salfordracing/SR-FS-17/Assembly/FInal Assembly (Don't Touch)/Assembly/Suspension/fsae-rear-hub/FSAE REAR HUB.png

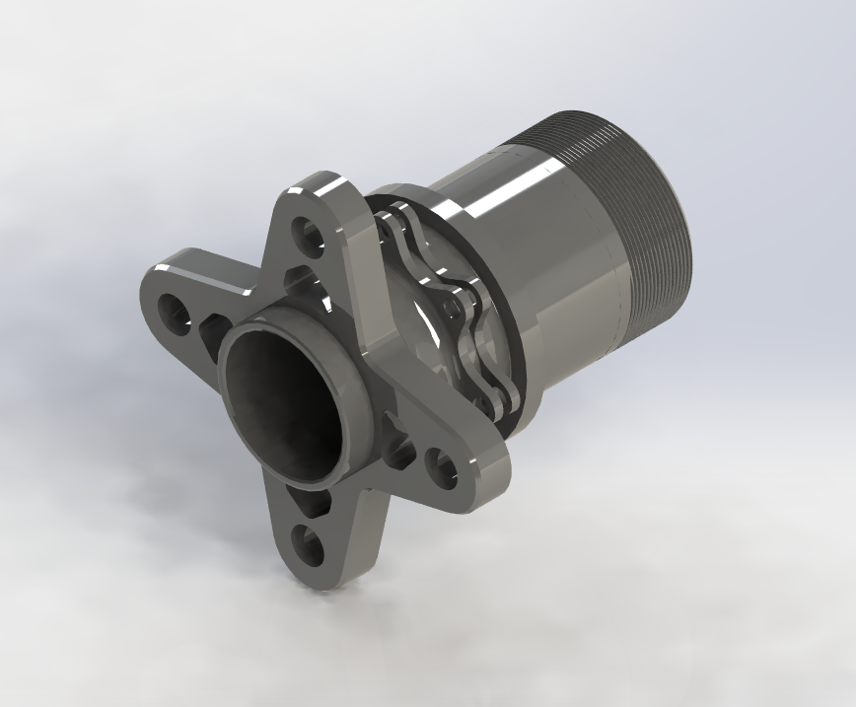
Assembly/FInal Assembly (Don't Touch)/Assembly/Suspension/fsae-rear-hub/FSAE REAR HUB.png
