salfordracing/SR-FS-17/2017 vehicle design/Pedal Box/pedalbox1.JPG

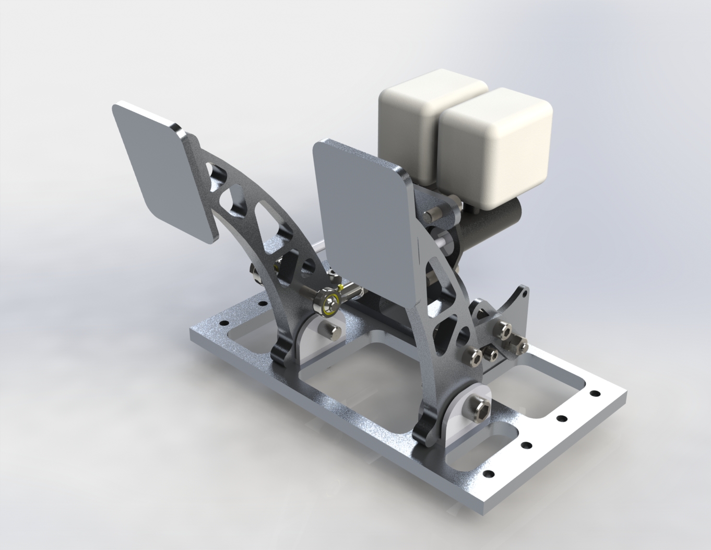
2017 vehicle design/Pedal Box/pedalbox1.JPG
