salfordracing/SR-FS-17/FS-17-0012-H Braking system Design and integration/to order brake cylinder.txt

Cylinder buy link]	3/4 size 2x	http://www.demon-tweeks.co.uk/motorsport/brake-master-cylinders-reservoirs/wilwood-compact-integral-reservoir-master-cylinder	37.24+vat

We'll buy this for now, and try to use the rest from the quadbike. If we'll need more, will order after we try to put things together.
