salfordracing/SR-FS-17/FS-17-0012-H Braking system Design and integration/Research items/Websites.docx

https://www.apracing.com/products/race_car/formula_student/sae.aspx

http://www.engineeringinspiration.co.uk/brakecalcs.htm
