salfordracing/SR-FS-17/Suspension/FS17-SUS-IN18-01 Suspension Calculator.docx

# Suspension WIP

Last updated: 23/01/2017

2 programs used to iteratively optimis

e solution.

http://www.vsusp.com/ (for geometry)

http://suspensioncalculator.com/download.html (for forces, moments and component selection)

## VSUP

Saving and Loading

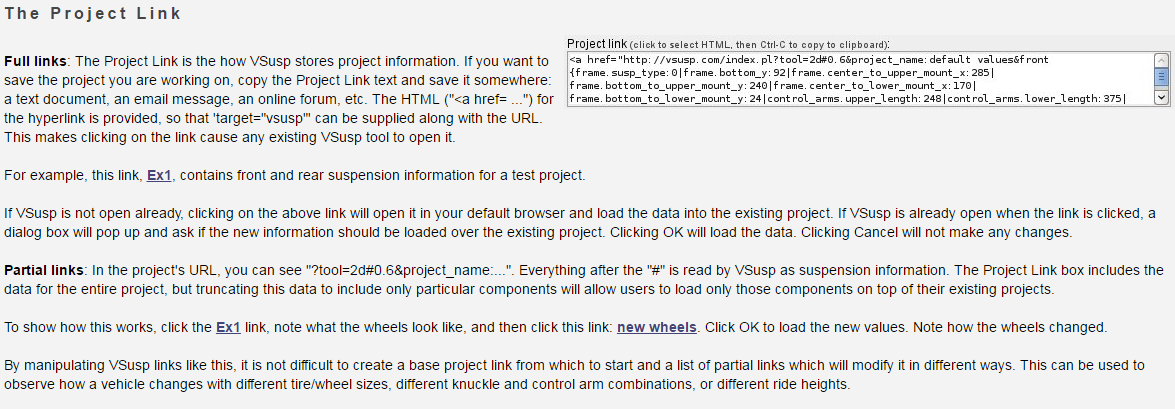
[picture p12: figure]

Saved Link

[url=http://vsusp.com/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]Salford mk.1[/url]

Current Frame Settings with 3 inch ground clearance.

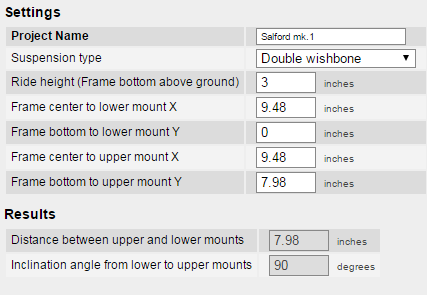
[picture p13: figure]
