salfordracing/SR-FS-17/FS-17-0012-H Braking system Design and integration/Breaking system.xlsx

Sheet: Sheet1
Initial parameters |  | Unit |  | Unit
Vehicle weight (including driver) W | 283 | Kg | 625 | lb
Maximum speed | 25 | m/s | 55 | mph
Wheelbase L | 1.5 | m | 59 | inch
H | 0.185 | m | 7.3 | inch
Lf | 0.64 | m | 25 | inch
Lr | 0.75 | m | 29 | inch
Ub coefficient | 1.8
tyre radius | 0.25 | m | 9.84 | inch
The rim diameter | 0.3 | m | 11.8 | inch
Calliper clearance | 0.03 | m | 1.18 | inch
Rotor diameter | 0.2 | m | 7.87 | inch
Mean radii of the friction force | 0.08 | m | 3.14 | inch
Calliper coefficient factor ucp | 0.6
Piston area Afcp | 0.00154 | m2 | 2.54 | inch^2
Calculations
Weight transfer force | 62.826 | kg | 139.1949153 | lbs | Ft
Weight transfer force exerted on tyre F | 183.5726667 | kg | 446.3983051 | lbs | Fnf
Weight transfer force exerted on tyre R | 78.674 | kg | 125.6355932 | lbs | Fnr
Friction forces front callipers | 1032.59625 | kg | 2518.027637 | lbs | Ffcp
Friction forces rear callipers | 442.54125 | kg | 708.680773 | lbs | Frcp | Need to select to 2 piston
Neutral forces front callipers | 1720.99375 | kg | 4196.712728 | lbs | Fnfcp
Neutral forces rear callipers | 737.56875 | kg | 1181.134622 | lbs | Fnrcp
Pressure in line front | 0.6625825937 | kg/m2 | 413.0622764 | psi | Pf
Pressure in line rear | 0.2839639688 | kg/m2 | 116.2534076 | psi | Pr | Need to select master cylinders
Force on master cylinder Front |  |  | 729.5712457
Force on master cylinder Rear |  |  | 205.3325812
Area of each master cylinder | 2025.8024 | mm2 | 1.76625 | inch2
Displacement of caliper pistons recommended | 0.000793785 | m | 0.03125 | inch
a | 260 | mm | 10 | inch | (approximated from drawing)
b | 71 | mm | 2.8 | inch
b/a |  |  | 0.28
F foot required |  |  | 261.7730715 | lbs

Sheet: Suggested to buy
Have to check this
Brake Calliper | AP Racing | CP3696 |  | https://www.apracing.com/products/race_car/formula_student/sae/brake_calipers.aspx
Brake discs | AP RAcing | 267mm |  | https://www.apracing.com/products/race_car/formula_student/sae/brake_discs.aspx
Brake pads | AP Racing |  |  | http://www.apracing.com/ProductDetail.aspx?ProductID=2999
Cylinder | AP RAcing | 25.4mm one |  | http://www.apracing.com/ProductDetail.aspx?ProductID=2386 | CP2623 Type | 19.1mm (.75") 3/4" | CP2623-92PRM065 / CP2623-92PRM088
 |  | (large to get the required foot force of 150 lbs= 60kgf) |  |  | 3/4 inch one |  | CP2623-92PRM115 / CP2623-92PRM160
 |  |  |  |  |  |  | CP2623-92PRT115 / CP2623-92PRT160
Cylinder buy link] | 2x | http://www.demon-tweeks.co.uk/motorsport/brake-master-cylinders-reservoirs/wilwood-compact-integral-reservoir-master-cylinder | 37.24+vat
