salfordracing/SR-FS-17/FS16/Documentation/FS16-PM-DC13-01 DESIGN SPEC SHEET MASTER.xlsx

Sheet: FSAE_Specs_IC_Powertrain
FSAE Design Spec Sheet |  |  |  |  |  |  | 2016
Competitors: Please read the Instructions-Tips (tab below) prior to the completion and submission of this sheet.
Car No. |  | 0 (class 2)
School |  | University Of Salford (Salford University Race Team)
Dimensions | Units
Overall Dimensions | mm | Length: | 3000 | Width: | 1405 | Height: | 1100
Wheelbase & Track | mm | Wheelbase: | 1600 | Front Track: | 1200 | Rear Track: | 1200
Center of Gravity Design Height | mm | CG Height: |  | Confirmed Via:
Mass without driver | kg | Front: |  | Rear: |  | Total: | 195
Weight Distribution with 68kg driver |  | % Front: | 23.6 | % Left: | 45
Suspension Parameters | Units | Front |  |  | Rear
Tire Size, Compound and Make |  | Hoosier: 20.5 X 7.0 X 13 R25B A2500 |  |  | Hoosier: 20.5 X 7.0 X 13 R25B A2500
Wheels (width, construction) |  | OZ 7"x13" Al Rim |  |  | OZ 7"x13" Al Rim
Suspension Type |  | Uneven A arms, push rod actuated, Fox float mxr infinitely adjustable air shock axially aligned |  |  | Uneven A arms, push rod actuated, Fox float mxr infinitely adjustable air shock, laterally aligned
Suspension design travel | mm | Jounce (col D): Rebound (col E): |  |  | Jounce (col G): Rebound (col H):
Wheel rate (chassis to wheel center) | N/mm
Roll rate (chassis to wheel center) | Nm/deg
Sprung mass natural frequency | Hz
Jounce Damping | % critical |  | at __ mm/sec: |  |  | at __ mm/sec:
Rebound Damping | % critical |  | at __ mm/sec: |  |  | at __ mm/sec:
Motion ratio | _.__:1 |  | Type: |  |  | Type:
Ride Camber (Rate of Camber Change) | deg/m
Roll Camber | deg/deg
Static Toe (- out, + in) | deg
Static camber | deg
Static camber adjustment method |  | upright design |  |  | upright design
Anti dive / Anti Squat | %
Roll center height above ground, static | mm
Roll center position at 1g lateral acc | mm | Height (col D): Lateral (col E): |  |  | Height (col G): Lateral (col H):
Front Caster, Trail, and Scrub Radius |  | Caster (deg): |  | Kin Trail (mm): |  | Scrub Rad (mm)
Front Kingpin Axis |  | Inclination (deg): |  | Offset (mm):
Static Ackermann | % | 5 | Adjustable? | No
Suspension Adjustment Methods
Steer Ratio, C-Factor, Steer Arm Length |  | Steer Ratio (x:1) |  | c-factor (mm) |  | Steer Arm Length
Brake System / Hub & Axle | Units | Front |  |  | Rear
Rotors
Master Cylinder
Calipers |  | AP racing calipers front: CP2576 / rear CP2577 |  |  | AP racing calipers front: CP2576 / rear CP2577
Brake Pad/Lining Material
Force and Pressures @ 1g Deceleration |  | Front Pres. (bar): |  | Rear Pres. (bar): |  | Pedal Force (kN)
Upright Assembly |  | modular concept, steel |  |  | modular concept, steel
Hub Bearings
Axle type, size, and material
Ergonomics | Units
Driver Size Adjustments |  | Sliding pedal box
Seat (materials, padding/damping) |  | Expanding Foam racing seat material, polyurethane foam seat kit produces a rigid foam seat which is ideal for making custom fitted seats
Steering Wheel (dia, construction) |  | Diamter (mm) | ~250mm | Construction | rectanglular shape, rounded edge, aluminium plate
Shift Actuator (type, location) |  | N/A
Clutch Actuator (type, location)
Instrumentation |  | OEM Honda CBR600RR Instrument Binacle
Optional: Driver Safety Systems? |  | HealTech Speedo-Healer for correction of speed read-out.
Electrical | Units
Power Management / Control
Wiring / Loom / ECM mounting |  | OEM Honda/KEIHIN 32Bit CDI ECU with adapted CBR600RR wiring Loom.
Battery / Charging System |  | Yuasa - YTZ10S Maintenance free 190A, 9.1 Ah Battery with 18 coil stator with rectifier for spark and battery charging.
Grounding |  | Earthing point on engine to frame mount
Driver Assist Systems
Logging / Telemetry
Special Sensing Technology
Frame | Units
Frame Construction |  | Steel Space frame chasis
Material |  | ROPT510 Cold Drawn mild steel
Joining method and material |  | Mig Welded
Bare frame mass with brackets & paint | kg | Target: | 60 | Physical Test: | 55
Torsional stiffness | N-m/deg | Target: |  | Simulated: |  | Physical Test:
Torsional stiffness validation method |  | TBC
Impact Attenuator configuration |  | Standard IA
Impact Attenuator dimensions | mm | Width: | 355.6 | Height: | 304.8 | Depth: | 254
Impact Attenuator energy capacity | kJ | Energy: |  | Method:
Powertrain | Units
Manufacturer / Model |  | Honda CRB 600RR
Cylinders & Fuel |  | Cylinders: |  | 4 | Fuel Type: |  | Petrol
Displacement & Compression |  | Displacement (cc): |  | 599 | Compression (_:1): |  | 12.2:1
Bore & Stroke | mm | Bore: |  | 67 | Stroke: |  | 42.6
Engine Output |  | Peak Power (kW) | 88.1 | PeakTorque (Nm) | 66
Design Speeds | rpm | Max Power: | 13500 | Max Torque: | 11250 | 80% Torque:
Induction (natural or forced, intercooled) |  | Naturaly Aspirated
Throttle Body / Mechanism |  | 4x40mm(1.6") cable operated throttle bodies
Fuel Injection System (manf'r, and type) |  | Dual Stage Fuel Injection (DSFI) with 12 hole Denso Injectors
Fuel System Sensors (for fuel mapping) |  | Throttle Position, Engine Coolant, Speed, Manifold Absolute Pressure, Ingition Pulse & Cam Pulse Generator Sensors
Fuel Pressure | bar | 3.45
Injector location |  | xx mm before _________ and directed towards ________
Intake Plenum |  | Volume (cc): |  | Runner length (mm):
Exhaust Header Configuration |  |  | Effective Runner Length (mm): |  |  | Variation (mm):
Exhaust Header Diameters |  | Primary (mm): |  | Collector (mm):
Ignition System |  | Computer Controlled Digital Transistorised with 3-D mapping
Ignition Timing |  | Standard, No advance
Oiling System (wet/dry sump, mods) |  | Wet sump lubrication system, 4.09L capacity
Engine Lubricants / Friction Treatment |  | 10W40 Fully synthetic engine oil
Coolant System and Radiator location |  | ______ mounted xx core ______ radiator , xxxx cfm fan mounted to ______
Fuel Tank Location, Type |  | aluminum sheet metal design |  |  |  | Capacity (L):
Muffler
Other significant engine modifications
Drivetrain | Units
Drive Type |  | Chain, Direct Drive
Differential System |  | Standard FSAE Drexler Differential
Final Drive Ratio | _:1 | 4:1
Vehicle Speed @ max power (design) rpm | kph | 1st gear: |  | 2nd gear: |  | 3rd gear:
Vehicle Speed @ max power (design) rpm | kph | 4th gear: |  | 5th gear: |  | 6th gear:
Half shaft size and material
Axle Joint type and grease used
Aerodynamics (if applicable) | Units
Type / Configuration |  | N/A
Forces (at 80 kph, ρ= 1.162 kg/m^3) |  | Downforce (N): |  | % Front: |  | Drag (N):
Coefficients & Reference Area |  | Cl: |  | Ref. Area (m^2): |  | Cd:
Noteable Features (active, etc)
Other Information | Units
Body Work (material, process)
Optional Information |  | Much of the design is still to be finalised and many items are un workable without a physical car to measure. - Chassis floor close out is CF plate, firewall is CF with Thermal Velocity Magmashield sheet

Sheet: Instructions-Tips
Instructions / Tips for Design Specification Sheet
File naming: Please adhere to the specific file naming convention as stated in the rules. This greatly simplifies file management for the judges and event organizers.
Formatting: Please do not modify the formating of the spec sheet. It has been laid out to print on a single sheet of 8.5 x 11 paper (double sided). While we acknowledge that there is little space in the cells, we ask that you be brief and include longer descriptive information within the Design Report.
Completeness: Please complete the spec sheet in its entirety. The judges expect that there will be a value or description entered for each and every line item contained within. If by chance, the particular item does not apply to your vehicle / design, please enter "N/A" in the space provided. N/A in this case meaning: Not Applicable.
Range of Values: In cases where you have yet to determine a specific value for a parameter, please input the range that you anticipate the values to fall within. Please make the noted range as tight (ie. narrow bandwidth) as you feel comfortable.
Units: For the majority of the specifications requiring a numerical input, an example of the desired unit of measure has been provided. Please be consistent with the units as specified on this sheet.
Comments / Clue Tabs: For many line items, there is additional descriptive information provided if you hover your cursor over the specification cell. Please use this information to guide your entry.
Understanding: The sample values in the template are fictional and should not be used as the baseline for your designs. Note that the specifications identified within the spec sheet contain the type of information the judges will expect you to know, understand, and be capable of discussing during the Design Event. Key factors during the discussion shall be the engineering rationale behind each decision and resulting specification.
Consistency: All values contained within this spec sheet are expected to align with your Design report and your vehicle at competition. It should be expected that inconsistencies will be discussed during the Design event. Without adequate reasoning for the discrepancies, a negative impact on your design score may result.
Timliness: Please submit the Spec Sheet and Design Report ON TIME. Late submission penalties can be significant and there is little excuse for points lost due to late submissions.
Data Entry Issues: If you are having issues with Excel not taking a value (especially if a negative sign is used) please try beginning the entry with an " ' " as the first character.
