salfordracing/SR-FS-17/FS-17-0012-H Braking system Design and integration/Research items/muSymposium2010_English.pdf

"#$!

!"#$%&'(&)'*+&#,-.*,$+&'+/',0"'1-(2"'#3#,"4#'/+-',0"' ⁵6+-4.7('8,.)"&,⁵9':(*$&%';(-#'<:;=>'?'<:;=@'

!"#$%&'"%()*+%&,-"./01*2&3%&41..& 567810*+-*+&9-/"207+60:/*1;<&3=>(40".1*& %&'()*+,-./+((0)123/*'(+,.4*!
560$-*&'-..?0"&

### @AB&5C3D)C,&E?F3&

51*6&,.4&((7*'08998(*7&+(.:97!

;+&*7.#$+&'

=/0& G*1H0"I16J& #$& @KK.108& 5:10*:0I& 1*& 40".1*<& 3=>(40".1*<& 6-;0I& K-"6& -6& 6/0& L9#"( ?7.-&56780*6L&M16/&6/01"&#M*&"-:0&:-"I&I1*:0&NOOP%&31I6#"1:-..J&80"1H08&$"#?&6/0&L9#"( ?7.-&5@QL<&I6780*6&60-?I&-"0&-F.0&6#&0*60"&M16/&I0.$(F71.6&"-:1*+&:-"I&1*&-*&1*60"81I( :1K.1*-"J&:#?K06161#*%&=/0& "0+7.-61#*I& #$&6/0& L9#"?7.-&56780*6L&80I:"1F0I& 6/0&:#*81( 61#*I& 6/-6& -& I1*+.0(I0-60"& "-:1*+& :-"& ?7I6& F0& F71.8& 7*80"& M16/1*& -& J0-"%& 9#"& 0-:/& :#?K06161#*&J0-"&-&*0M&H0/1:.0&?7I6&F0&F71.6%&

9#"&6/0&L9#"?7.-&56780*6L&R&"-:1*+&:-"&4DCOS&$"#?&6/0&3=>(40".1*<&6/0&F"-;0&IJI( 60?& M-I& :#?K.060.J& "080I1+*08& -*8& I7KK#"6I& 6/0& 1*60"K"06-61#*& #$& 6/0& :#?K#*0*6I& :#*I1I60*6.J&*7?0"1:-..J%&)*&6/0& $#..#M1*+&H0/1:.0&4DCOT&6/0&F"-;0&IJI60?&F-I08&#*& 6/0&4DCOS&"-:1*+&:-"&M-I&?#"0&80H0.#K08<&/#M0H0"&?#I6&#$&6/0&K-"6I&-"0&180*61:-.&6#& 6/0&K"0H1#7I&H0/1:.0%&

)*&-88161#*&6#&#K61?12-61#*&#$&I0.0:608&F"-;0&K-8&$"1:61#*&?-60"1-.I<&16&I/#MI&6/0&0U( K0"1?0*6-.& H0"1$1:-61#*& #$& 6/0& "0-.1208& F"-;0& IJI60?& $#"& 6/0& "-:1*+& :-"& 4DCOS<& K-"( 61:7.-".J&1*&6/0&80I1+*&#$&6/0&F"-;0&81I:I&-*8&6/01"&6/0"?-.&.#-8<&J06&6/0&K#60*61-.&1I& *#6&0U/-7I608%&

!"#$%&'(&)'*+&#,-.*,$+&'+/',0"'1-(2"'#3#,"4#'/+-',0"'⁵6+-4.7('8,.)"&,⁵9':(*$&%';(-#' | <==
! | "#$%&'()$*&#+

!"#$ %&'()*+,$-.*/#0.%$1'2#(3$ ,0$40.#(/43145+40,(6$ 3.*/#0.$1'0.#3.$74."$),06$ .#,)3$ ,('*0/$$/#2#+'5)#0.8$4)5+#)#0.,.4'0$,0/$'5#(,.4'0$'9$,$340:+#;3#,.#($9'()*+,$(,140:$ 1,($.",.$1'*+/$."#'(#.41,++6$3#(2#$,3$,$5('.'.65#$9'($,$3),++$3#(4#3$'9$<8===$2#"41+#3>$

!"#$5,(.4145,.40:$3.*/#0.$.#,)3$",2#$."#$'55'(.*04.6$.'$1'03'+4/,.#$."#4($?0'7+#/:#$ 40$."#$94#+/$'9$#0:40##(40:$314#01#3$,0/$.'$:,40$%3'9.$3?4++3%$40$."#$3,)#$),00#($.",.$9'($ +,.#($5('9#334'0,+$+49#$43$@#1')40:$401(#,340:+6$4)5'(.,0.>$

!"#$.#,)3$40$."#$%&'()*+,$-.*/#0.%$;$5('A#1.3$,(#$34)4+,($'(:,04B#/$,3$1')5,06$0'.$ '0+6$40$.#1"041,+$.,3?3$9'($1'03.(*1.4'0$'9$,$&'()*+,$(,140:$1,(8$@*.$,+3'$40$(#+#2,0.$ '(:,04B,.4'0,+$,0/$#1'0')41$,35#1.38$3*1"$,3$5('A#1.$),0,:#)#0.8$940,014,+$5+,0040:$ ,0/$5*@+41$(#+,.4'03$402'+2#/>$

!,! -*.$&%*)/0+'1210&341#$+&5+$61+⁷8&%4(0/+9$('1#$⁷+

!"#$4/#,$'9$."#$%&'()*+,$-.*/#0.%$7,3$3.,(.#/$<CD<$40$."#$E04.#/$-.,.#3$'9$F)#(41,$ @6$ ."#$ -FG%3$ H-'14#.6$ '9$ F*.')'.42#$ G0:40##(3I$ ,11'(/40:$ .'$ ."#$ J&'()*+,$ -FGJ>$ !"#$,4)$'9$."#$1')5#.4.4'0$7,3$."#0$;$,0/$3.4++$43$;$,$35#14,+$3.*/#0.$3*55'(.$40$."#$ 94#+/$'9$#0:40##(40:>$

-401#$ <CCD8$ 40$ 1''5#(,.4'0$ 74."$ -FG$ ,0/$ KL#1"G$ HK03.4.*.4'0$ '9$L#1",041,+$ G0:4; 0##(3I8$ ."#$ %&'()*+,$ -.*/#0.%$ "#+/$ 40$ G0:+,0/>$ L#,07"4+#8$ ."#$ %&'()*+,$ -.*/#0.%$ 1'01#5.$",3$ 9'*0/$)'(#$ 9'++'7#(3$40$),06$1'*0.(4#3>$M'7$7'(+/74/#$,@'*.$N==$3.*; /#0.3$1''5#(,.#$,.$1'++#:#3$,0/$*042#(34.4#3$40$40.#(/43145+40,(6$.#,)3>$-401#$<CCC8$."#$ %&'()*+,$-.*/#0.%8$43$,+3'$,.$"')#$40$O#(),06$P<Q>$$

E0/#($ ."#$ .#()$ %&'()*+,$-.*/#0.$O#(),06%$ ."#$RSK$ HF33'14,.4'0$ '9$O#(),0$G0:4; 0##(3I$$."43$#2#0.$43$"#+/$,00*,++6$'0$."#$T'1?#0"#4)$U40:$3401#$V==W>$!"#$0*)@#($ '9$*042#(34.6$.#,)3$5,(.4145,.40:$",3$401(#,3#/$9(')$X=$40$V==W$.'$YD$40$V==C8$7"41"$ /'1*)#0.3$."#$,..(,1.42#0#33$'9$."#$%&'()*+,$-.*/#0.$O#(),06%$4)5(#3342#+6>$

!,: ;1<(0/$*&#.+

!"#$(#:*+,.4'03$'9$."#$%&'()*+,$3.*/#0.%8$@,3#/$'0$."#$(*+#3$'9$."#$%&'()*+,$-FG%$PVQ8$ /#31(4@#3$ ."#$ ?#6$ #+#)#0.3$ 9'($ (#,+4B40:$ ."#$340:+#;3#,.#($ 9'()*+,$ (,140:$ 1,(8$ 7"41"$ )*3.$@#$5+,00#/8$/#34:0#/$,0/$4)5+#)#0.#/$@6$3.*/#0.$7'(?$74."40$,$6#,(>$&'($."#$ 1')5#.4.4'0$40$."#$9'++'740:$6#,(8$,$0#7$2#"41+#$)*3.$@#$5('/*1#/>$

!"!# | $$%$&'#%(&)*(+&,-(+.#Æ#/012-3,41#

!"#$%&"'&("'")&"*#%+"',-./"01-2'1,'&("'-34"#5'&("'-"634.&%1*#'6%+"'#3,,%7%"*&',-""81/5' #1'&(.&'83-%*6'&("'-".4'%/$4"/"*&.&%1*'.'7-".&%+"'8"#%6*'%#'$1##%94":';("-"'%#'*1'$-"< #7-%9"8'/%*%/3/'0"%6(&5'&("'#$"7%,%7'"*6%*"'8"#%6*'1,'&("'-"=3%-"8',13-<#&-12"'"*6%*"' 7.*'9"',-""4>'7(1#"*'.*8'%&'%#'$1##%94"'&1'3#"'/18"-*'/.&"-%.4#:'

?10"+"-5' ,1-' 8"+%.&%1*#' ,-1/' &("' -"634.&%1*#' &("' &"./#'/3#&' .77"$&' #"*#%&%+"' $1%*&' 8"837&%1*#' 3$' &1' &("' 8%#=3.4%,%7.&%1*' .*8' .*' ")743&%1*' ,-1/' &("' 71/$"&%&%1*:' ;("' 71/$"&%&%1*'%&#"4,5'.#'#(10*'%*'@%63-"'A5'%#'8%+%8"8'%*'#&.&%7'.*8'8>*./%7'8%#7%$4%*"#' B"+"*&#C5'0(%7('.-"'1*4>'$-"#"*&"8'%*'D*64%#(:''

;("'"+"*&#'.-"'"+.43.&"8'#"$.-.&"4>'.*8'#3/'3$'&1'&("'1+"-.44'-.*2%*6'1,'".7('&"./:' ;("' .##"##/"*&' 1,' &("' "+"*&#' .-"' 7.--%"8' &(-136(' 9>' "*6%*""-#' .*8' $-1,"##%1*.4#' 1,' -.7%*6'.*8'.3&1/1&%+"'%*83#&->:'E1&'&("',.#&"#&'7.-'0%*#'.3&1/.&%7.44>5'93&'&("'9"#&' 1+"-.44'$.72.6"'1,'&"7(*1416>'.*8'"71*1/>:'

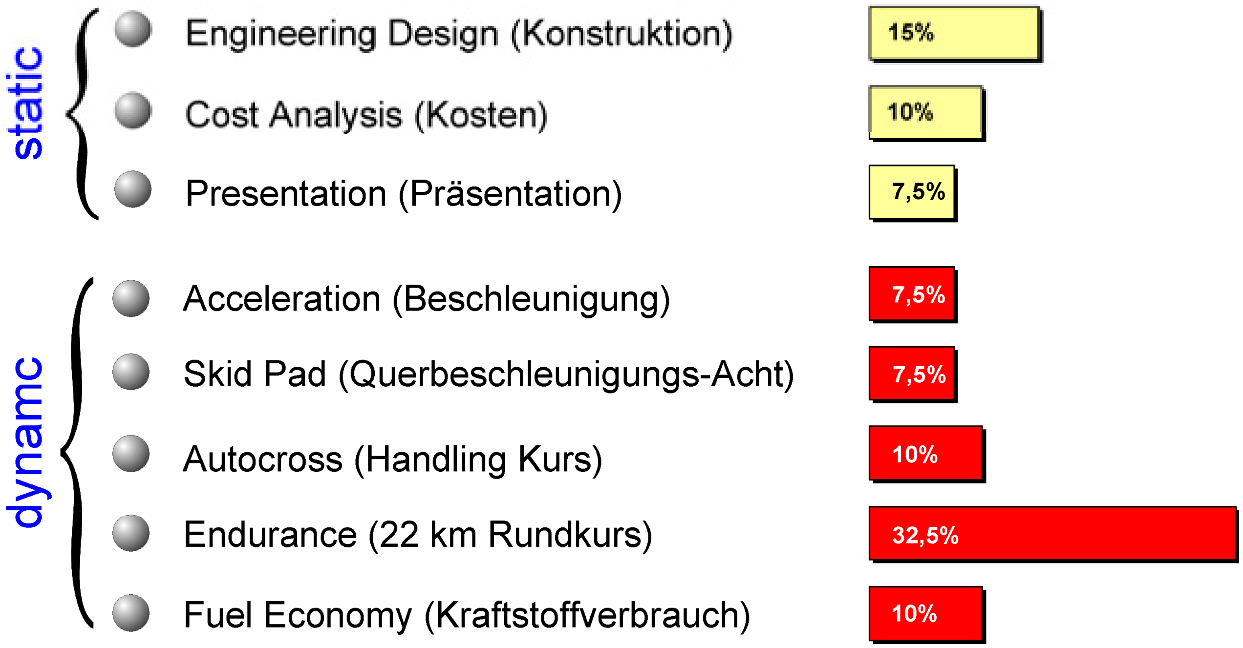
[picture p71: figure]

@%63-"'AF' !%#7%$4%*"#'

G*'#&.&%7'8%#7%$4%*"#'&("'71#&#'0%44'9"'.*.4>H"8'.*8'.*'%/.6%*.->',1-/34.'9386"&'$4.*' ,1-' '$-1837&%1*' 1,' &("'7.-'/3#&'9"'7-".&"8:';("' I"*6%*""-#I' 1,' &("' &"./'(.+"' &1'")< $4.%*'.44'#&-37&3-"#'.*8'7(.-.7&"-%#&%7#'1,'&("'+"(%74"'83-%*6'&("'I!"#%6*'J"$1-&I:'G&'%#' *1&'&("'.7&3.4''71*#&-37&%1*5'93&'-.&("-'&("'$-1,"##%1*.4'9.726-13*8'1,'&("'&"./'.*8' &("%-'3*8"-#&.*8%*6'1,'&("'71--"4.&%1*#'&(.&'%#'"+.43.&"8:'

;("'#&.&%7'8%#7%$4%*"#'.-"'71/$4"&"8'0%&('&("'IK3#%*"##'L4.*'L-"#"*&.&%1*I:'M'$.*"4'1,' %*83#&->'")$"-&#'-"+%"0'&("',%*.4'#.4"#'$-"#"*&.&%1*'1,'&("',1-/34.'7.-:'

!"#$%&'(&)'*+&#,-.*,$+&'+/',0"'1-(2"'#3#,"4#'/+-',0"'⁵6+-4.7('8,.)"&,⁵9':(*$&%';(-#' | <=>

!"#$%&#'()"$*+'$,()#(-#'.*"#,"#+"+.//0#()/0#1("",2/&#3,$%#.)#,)$&)",4&#,)5+"$*0#"1()6 "(*"%,17#$%&#1/.'&8&)$#(-#$%&#$&.8"#,"#*.$%&*#,81(*$.)$#,)#1&*"1&'$,4&#(-#.$$*.'$,4&6 )&""# $(# 1($&)$,./# "1()"(*"9# :81(*$.)$# 2.",'# '%.*.'$&*,"$,'"# (-# .# ;<(*8+/.# =$+5&)$;# 6# *.'&#'.*#.*&#"%(3)#,)#<,>+*&#?9#

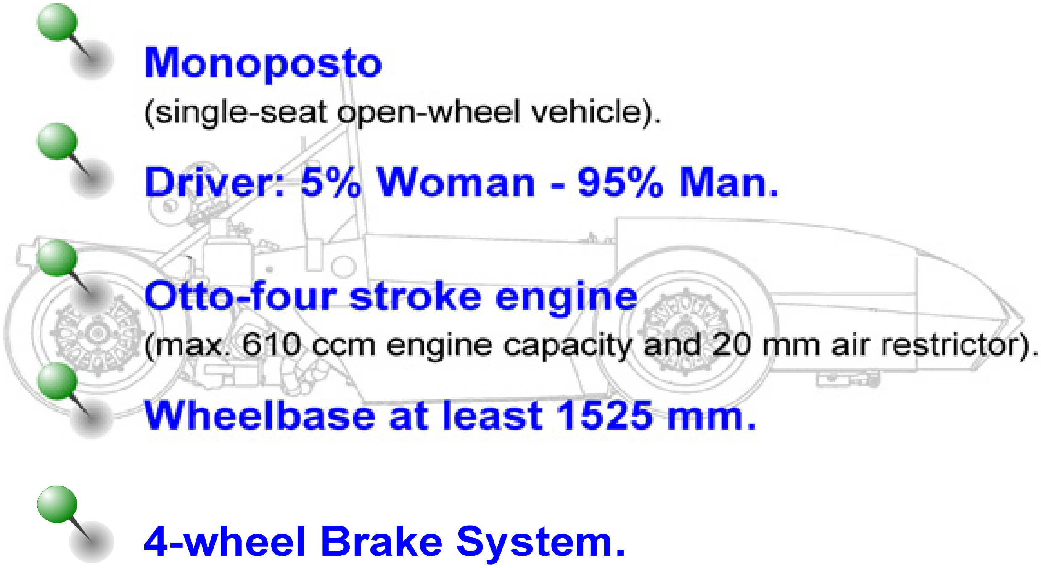
[picture p72: figure]

<,>+*&#?@# | :81(*$.)$#2.",'#'%.*.'$&*,"$,'"#(-#.#;<(*8+/.#=$+5&)$;#6#*.',)>#'.*#
! | "#$%&'($#)*(

<,>+*&#A#"%(3"#$%&#BCDEF#C.',)>#GC.'&#D.*#B&*/,)7#?EEFH#.)5#BCDEI#GB&*/,)#C.'&# D.*#?EEIH9#J%&#5&",>)#(-#&.'%#2+,/5&5#4&%,'/&#3."#5&",>)&5#-(*#$%&#;<(*8+/.#=$+5&)$;# K&*8.)0#GLM:#'(81&$,$,()#(-#$%&#;<(*8+/.#=$+5&)$;#()#$%&#$*.'N#(-#$%&#O('N&)%&,86 *,)>H#.)5#'(**&"1()5&5#$(#$%&#*+/&"#(-#<(*8+/.#=!P9#M&*,4&5#-*(8#$%&#&Q1&*,&)'&"#(-# $%&#0&.*"#?EER#.)5#?EES#-(//(3,)>#5&4&/(18&)$#1*,(*,$,&"#3&*&#"&$@#

=,81/&#5&",>)7#&"1&',.//0#-(*#$%&#;<(*8+/.#=$+5&)$;#K&*8.)0#5&4&/(1&59# P81$0#8.""#(-#?EE#N>9#
PQ1&)",4&#.)5#'(81/&Q#.+Q,/,.*0#"0"$&8"#*&1/.'&5#20#",81/&#'()"$*+'$,()"9# D(81()&)$#".4,)>"#20#*&+",)>#$%&89#
D()","$&)$# './'+/.$,()# .)5# (1$,8,T.$,()# (-# .//# 8.""# *&/&4.)$# '(81()&)$"# 3,$%# <P#8&$%(5"9#

!"#$ | %%&%'($&)'*+),'-.),/$Æ$0123.4-52$

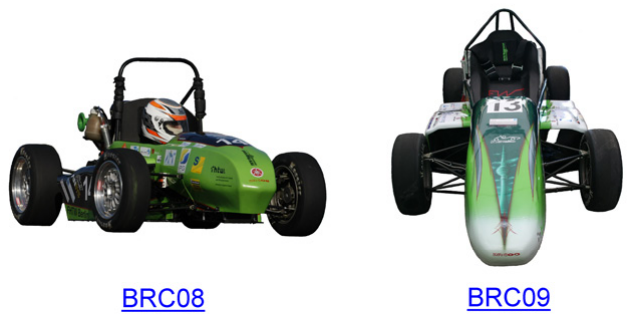
[picture p73: figure]

"#$%&'!()! *+,#-$!,+&.!!/*012!%-3!/*014!

5-!67'!+&'+!89!67'!3&#:'!+-3!67'!.%.;'-.#8-!<867!:'7#,='.!7+:'!+-!#3'-6#,+=!,8-,';6>! ?7'!9&+@'!89!67'!/*014!78A':'&B!A+.!3':'=8;'3!9&8@!.,&+6,7>!

?7'!:'7#,='!3C-+@#,.!98,%.!=#'.!A#67!67'!&'.;',6#:'!&+,#-$!,+&.!8-!+!;+&6#,%=+&=C!$883! +,,'='&+6#8-!+-3!<&+D#-$!+<#=#6CB!A7#,7!#.!&'E%#&'3!#-!67'!3C-+@#,!,8@;'6#6#:'!'F+@#G -+6#8-.>!!?+<='!H!;&8:#3'.!#-98&@+6#8-!8-!#@;8&6+-6!:'7#,='!3+6+>!

?+<='!H)!I'7#,=' 3+6+

?7'!@+F#@%@!.;''3!89!,+&.!#.!3%'!68!67'!7#$7!=+6'&+=!+,,'='&+6#8-!&'E%'.6!3%&#-$!67'! 3C-+@#,! 6'.6.! -86!#-! 67'! 98&'$&8%-3B! .8! 67+6!#-! ,8@;+&#.8-! 68! 67'! ,+&.! 89! ;&':#8%.!

!"#$%&'(&)'*+&#,-.*,$+&'+/',0"'1-(2"'#3#,"4#'/+-',0"'⁵6+-4.7('8,.)"&,⁵9':(*$&%';(-#' | <=>

!"#$%& '()#*+& ,-.& /& 0..&1)& 2&34& 53"&)#*6& %7""8&9%&$"8:;"8&<!& 53"&=>;19?@& 53"&39@3"$& @"#$%&5>&,0.&1)&2&36&A39%&3#%&#&7>%959("&"BB";5&>B&="%%&5$#;59>?&9?5"$$:759>?%&9?&53"&#;/ ;"="$#59>?&5"%56&

! "#$%&'()&*#$+,$-+-.%*/$+#0+&1.+2',3*$/+%4%&.5+

A3"&<$#1"&%!%5")&9?&#&B>$):=#&;#$&;3#%%9%&8"%9@?&9%&?"*5&5>&53"&C3""=&%:%7"?%9>?&#?8& 53"& ;3>9;"& >B& 53"& 59$"D& 53"&)>%5&9)7>$5#?5& ;>)7>?"?56& E%7";9#==!& C953& 53"& C9?89?@& ;>:$%"&>B&53"&FG>$):=#&H5:8"?5F&I"$)#?!&53"&#;;"="$#59>?&#?8&%5>779?@&7>C"$&B>$&B#%5& =#7&59)"%&3#%&%7";9#=&9)7>$5#?;"6&A3"&)>$"&"BB9;9"?5&53"&<$#1"&%!%5")&8";"="$#5"%&53"& ("39;="D&53"&=>?@"$&;#?&<"&53"&$#?@"&>B&39@3&%7""8%6&J8"#==!D&53"&;#$&C9==&89$";5&5>&53"& ;:$("&#5&B:==&%7""8D&8"=#!"8&C953&)#*9):)&B$9;59>?&7>5"?59#=&>B&53"&("39;="&#?8&9?&53"& 5>7&>B&53"&;:$("&):%5&%5#$5&C953&53"&$"#;;"="$#59>?6&

A>&#==>C&=#5"&<$#19?@&@>>8&F;>=8&B$9;59>?&7$>7"$59"%F&>B&53"&7#8%&#$"&$"K:9$"8&<";#:%"& 53"&<$#1"&7#8%&3#("&?>5&$"#;3"8&53"9$&>759):)&>7"$#59?@&5")7"$#5:$"&#5&53"&<"@9?/ ?9?@&>B&53"&<$#19?@&7$>;"%%6&L&$#798&9?;$"#%"&>B&53"&<$#19?@&8";"="$#59>?&5>&53"&)#/ *9):)&="("=&9%&9)7>$5#?5&9?&>$8"$&5>&9?959#5"&53"&<$#19?@&7$>;"%%&=#5"6&

M:$9?@&53"&FE?8:$#?;"F&'%""&#=%>&G9@:$"&,D&760,04D&C39;3&$"7$"%"?5%&#&00&1)&3#?8=9?@& ;>:$%"D&9?&#88959>?&5>&53"&F;>=8& B$9;59>?&7$>7"$59"%F&53"&53"$)#=&%5#<9=95!&>B&53"&<$#1"& %!%5")&9%&9)7>$5#?56&A3"&<$#19?@&%!%5")&9%&%5$"%%"8&8!?#)9;#==!&%5$>?@&<!&$#798&=>#8& ;3#?@"&7$>;"%%"%6&L?&"*5$")"& 53"$)#=&=>#8& >?& 53"&<$#1"%D&="#89?@& 5>&39@3& 5")7"$#/ 5:$"&@$#89"?5%&#?8&3"#5&B=>C%D&C9==&="#8&5>&53"$)#=&"BB";5%&9?&53"&"?59$"&%!%5")6&L%&#& ;>?%"K:"?;"& >B& 539%& 53"& 89%;%D& 53"& B$9;59>?& )#5"$9#=D& <$#1"& B=:98& #?8& 53"& 7"$973"$#=& ;>)7>?"?5%&#$"&%5$"%%"8&39@3=!&53"$)#=&C9%"6&A3"%"&B>==>C9?@&5")7"$#5:$"&"BB";5%&#$"& 5#1"?&9?5>&#;;>:?5+&

N$#1"&89%;& | & | &O"#5&;$#;1%&
G$9;59>?&)#5"$9#=%& | &P3#?@"%&>B&B$9;59>?&&>$6&=>%%&>B&B$9;59>?&:7&5>&B#89?@&
N$#1"&B=:98& & | &P3#?@"%&>B&;>)7$"%%9<9=95!&&7"8#=&5$#("=&"*5"?59>?&
Q"$973"$!& | & | &G9$"&

A3"&39@3&>7"$#59?@& B$"K:"?;!&8:$9?@&53"&$98"&#=%>&$"K:9$"%&#&"$@>?>)9;&>7"$#59>?&>B& 53"&<$#1"&%!%5")D&%>&53#5&53"&3:)#?/)#;39?"&9?5"$B#;"&@"5%&#?&#%&39@3&9)7>$5#?;"&#%& 53"&7:$"&8";"="$#59>?&7"$B>$)#?;"&>B&53"&<$#1"&%!%5")6&&

!"#$ | %%&%'($&)'*+),'-.),/$Æ$0123.4-52$

!"#$%&'(#$)*)+#,$-.$+"#$&'/012$/'&$34567$8')$9#:#;-<#9$$.&-,$)/&'+/"$'19$')$%')0)$ .-&$.=+=&#$345><;'11#9$:#"0/;#)?$!"#$&#=)'%0;0+*$-.$+"#$%&'(#$)*)+#,$9#)021$8')$0,> <;#,#1+#9$%*$=)012$+"#$3456@?$!"#$)+#<$+-8'&9)$,-9=;'&0)'+0-1$-.$0190:09=';$)=%> )*)+#,)$0)$'$<&#&#A=0)0+#$ .-&$'$9&')+0/$ &#9=/+0-1$01$9#:#;-<,#1+$ +0,#)$ .-&$1#8$:#"0> /;#)?$$

B+$ .=&+"#&$ )<#'()$ .-&$ +"#$,-9=;'&0C'+0-1$ >$ #)<#/0';;*$ -.$ +"#$ %&'(#$ )*)+#,$ >$ +"'+$ +"#$ 90,#1)0-1)$-.$+"#$%&'(#$/-,<-1#1+)$'+$'1$#'&;*$)+'2#$-.$:#"0/;#$9#:#;-<,#1+$,=)+$%#$ .0D#9E$ %#/'=)#$ +"0)$ "')$ '$ ,'F-&$ 01.;=#1/#$ -1$ +"#$ /-1)+&=/+0-1$ -.$ +"#$ #1+0&#$ :#"0/;#$ G8"##;$/'&&0#&E$8"##;$"=%)E$.&',#)H?$

!"#$/-1/#<+=';$9#:#;-<,#1+$-.$+"#$%&'(012$9#:0/#$8')$/"'&'/+#&0C#9$<&0,'&0;*$%*$+"#$ 1##9$+-$)':#$8#02"+$'19$0,<&-:#$+"#$=)'%0;0+*$-.$+"#$<&#:0-=)$)*)+#,?$!"#$1=,#&0/';$ '1';*)0)$-.$+"#$"#'+$%=92#+$/-=;9$%#$8#;;$)-;:#9$01$+"#$8#02"+$)':012$/-,<&-,0)#$&#> 2'&9012$)+'%0;0+*$'19$<#&.-&,'1/#?$

!"# $%&'()%*%+,-./0.,1%.²34)*'56.7,'8%+,².)'5%-.

B1$ +"#$ )#+$ -.$ &=;#)$ %')#9$ -1$ +"#$ IJ-&,=;'$ KLM$ 4=;#)I$NOPE$ +"#$ )<#/0.0/'+0-1)$ .-&$ +"#$ /-1)+&=/+0-1$-.$+"#$%&'(#$)*)+#,$%##1$9#)/&0%#9?$Q"#&#R$

!"#$/'&$,=)+$%#$#A=0<<#9$80+"$'$%&'(#$)*)+#,$+"'+$'/+)$-1$';;$.-=&$8"##;)$'19$ 0)$-<#&'+#9$%*$'$)012;#$/-1+&-;?$ !"#&#$'&#$+8-$019#<#19#1+$%&'(#$/0&/=0+)$&#A=0&#9?$ J-&$#'/"$%&'(#$/0&/=0+$'$)#<'&'+#$&#)#&:-0&$,=)+$%#$<&#)#1+?$ B1$/')#$-.$.'0;=&#$-.$'$%&'(#$/0&/=0+$+8-$8"##;)$,=)+$)+0;;$%#$'%;#$+-$%&'(#?$ L$)012;#$%&'(#$'/+012$-1$'$;0,0+#9>);0<$90..#&#1+0';$0)$'//#<+'%;#?$ 3&'(#>%*>80&#$)*)+#,)$'&#$<&-"0%0+#9?$ S1'&,-&#9$<;')+0/$%&'(#$;01#)$'&#$<&-"0%0+#9?$
!"#$ %&'(#$ )*)+#,)$ ,=)+$ %#$ <&-+#/+#9$ 80+"$ )/'++#&$ )"0#;9)$ .&-,$ .'0;=&#$ -.$ +"#$ 9&0:#$+&'01$-&$.&-,$,01-&$/-;;0)0-1)?$ !"#$%&'(#$)*)+#,$80;;$%#$9*1',0/';;*$+#)+#9$'19$,=)+$9#,-1)+&'+#$+"#$/'<'%0;> 0+*$ -.$;-/(012$ ';;$ .-=&$ GTH$8"##;)$ '19$ )+-<<012$ +"#$ :#"0/;#$01$ '$ )+&'02"+$;01#$ '+$ +"#$#19$-.$'1$'//#;#&'+0-1$&=1$)<#/0.0#9$%*$+"#$%&'(#$01)<#/+-&)$GU6$(,V"H?$ L$%&'(#$<#9';$-:#&>+&':#;$)80+/"$,=)+$%#$01)+';;#9$-1$+"#$/'&?$!"0)$)80+/"$,=)+$ %#$ 01)+';;#9$ )-$ +"'+$ 01$ +"#$ #:#1+$ -.$ %&'(#$ )*)+#,$ .'0;=&#$ )=/"$ +"'+$ +"#$ %&'(#$ <#9';$ -:#&$ +&':#;)E$ +"#$ )80+/"$ 80;;$ %#$ '/+0:'+#9$ '19$ 80;;$ )+-<$ +"#$ #1201#$ .&-,$

!"#$%&'(&)'*+&#,-.*,$+&'+/',0"'1-(2"'#3#,"4#'/+-',0"'⁵6+-4.7('8,.)"&,⁵9':(*$&%';(-#' | <=>

!"##$#%&'()$*'*+$,-)'."*,'/$00',)1'$%#$,$2#'3#4'-",',)1'52+1!',2'3#6'101-,!$-30' 7"10'5".5*&'81513,14' 3-,"3,$2#' 27' ,)1'*+$,-)'."*,'#2,' !1*,2!1'52+1!' ,2' ,)1*1' -2.52#1#,*9' 3#4' $,' ."*,' :1' 41*$%#14' *2' ,)3,' ,)1' 4!$;1!' -3##2,' !1*1,' $,&' ()1' *+$,-)'."*,':1'$.501.1#,14'+$,)'3#302%'-2.52#1#,*9'3#4'#2,',)!2"%)'!1-2"!*1' ,2' 5!2%!3..3:01' 02%$-' -2#,!2001!*9' 1#%$#1' -2#,!20' "#$,*9' 2!' *$.$03!' 7"#-,$2#$#%' 4$%$,30'-2#,!2001!*&'
()1'-3!'."*,':1'1<"$5514'+$,)'3'!14':!3/1'0$%),'27'3,'013*,'=>'+3,,*9'2!'1<"$;3? 01#,9' -013!06' ;$*$:01' 7!2.' ,)1' !13!&' @7' 3#' ABC' :!3/1' 0$%),' $*' "*149' $,' ."*,' :1' -013!06';$*$:01'$#';1!6':!$%),'*"#0$%),&'
()$*' 0$%),' ."*,' :1' 7$D14' :1,+11#' ,)1' +)110' -1#,1!0$#1' 3#4' :102+' ,)1' 4!$;1!E*' *)2"041!'01;10';1!,$-3006'3#4'355!2D$.3,106'2#';1)$-01'-1#,1!0$#1'03,1!3006&'

!"# $%&'()*+%,()-./0%.120.+3)

F2!',)1':!3/1'*6*,1.',)1':!3/1'72!-1'4$*,!$:",$2#'3#4':!3/1'72!-1'4$*,!$:",$2#'%!35)' 5036*'3#'$.52!,3#,'!201&'@#'-2#,!3*,',2'!1<"$!14':!3/1'72!-1'4$*,!$:",$2#9'$#'+)$-)',)1' 02-/'*1<"1#-1'27'7!2#,'3#4'!13!'3D01'$*'7$D149'72!';1)$-01*'72!'5":0$-',!3#*52!,',)$*'421*' #2,' -2"#,' 72!' ,)1' GF2!."03' H,"41#,G' !3-$#%' -3!*&' ()1' :!3/$#%' 72!-1' 4"!$#%' :!3/$#%' 72!-1'4$*,!$:",$2#'4$3%!3.'$*',)1!172!1'#2,'!1*,!$-,14&'I2+1;1!9',)1':!3/$#%'72!-1'4$*? ,!$:",$2#'4$3%!3.'72!',)1'"*"30'*,3,$2#3!6'-2#4$,$2#*'3!1'3**".14J'

K2;1.1#,'2#'3'503#1'*"!73-1'L#2'3*-1#,'$#70"1#-1M&' N1%01-,'27',)1'-)3**$*'*"*51#*$2#'L#2'.2;1.1#,'302#%',)1'O?4$!1-,$2#&' P2#*,3#,',$!1'!200$#%'!34$"*'L#2',$!1*'*"*51#*$2#M&' N1%01-,'27',)1'+)110'!1*$*,3#-1'-2177$-$1#,&' N1%01-,'27',)1'+)110*'.2.1#,'27'$#1!,$3&' N2'1771-,'27'31!246#3.$-'!1*$*,3#-1'72!-1*&' N2'0$7,?'3#4'42+#72!-1*&'
N1%01-,'27',)1'1#%$#1*':!3/1',2!<"1&'

F$%"!1'Q'*)2+*',)1':!3/1'*6*,1.'53!3.1,1!*'!1<"$!14'72!',)1'%12.1,!6'3#4'*,!1#%,)' 27',)1';1)$-01&'

!"#$ | %%&%'($&)'*+),'-.),/$Æ$0123.4-52$

"#$%&'!()! *'+,'&!-.!$&/0#,1!

"-&!,2'!3'45&#6,#-+!-.!,2'!#3'/7!8&/9#+$! .-&5'!3#4,&#8%,#-+!,-!,2'! .&-+,!:";<0<#3'/7=!/+3! ,2'!&'/&!/>7'!:";<2<#3'/7=!#4!.-&!/!0'2#57'!?#,2!,2'!@/44!@"A$!/+3!$&/0#,1!2B<!70<!72!#.!,/9#+$! #+,-! /55-%+,! ,2'! 31+/@#5! ?'#$2,! 3#4,&#8%,#-+! -+! ,2'! />7'4! :"C<! 0<! 31+<! "C<! 2! 31+=<! ,2'! ?2''78/4'!7!/+3!,2'!/55'7'&/,#-+!-.!$&/0#,1!$!#+!,2'!4,'/31!3'5'7'&/,#-+! >; !DEF)!

G
; | ; | B | ; | 2 | ; | "A$ | ; | B
;<0<#3'/7 | C<0<31+ | C<0<4,/, | "A$ | ; | "A$
> | > | 2> | 7> | @ | >2
" | H" | H" | I@ | > | H@ | $ | I $ | $ | 7 | $ | 7 | $ | 7$
÷ | ÷ ÷ | ÷ | ÷ | ÷ | ÷ | ÷÷ ÷ | ÷
! | ! | | | | | | | | | | | | :JKL!M=!

G
; | ; | B | ; | 0 | ; | "A$ | ; | B
;<2<#3'/7 | C<2<31+ | C<2<4,/, | "A$ | ; | "A$
> | > | 2> | 7> | @ | >2
" | H" | H" | @ | > | H@ | $ $ | $ | 7 | $ | 7 | $ | 7$
÷ | ÷ ÷ | ÷ | | ÷ | ÷ | ÷ | ÷÷ ÷ | | ÷
! | ! | | | | | | | | | | | :JKL!G=!

N/9#+$!#+,-!/55-%+,!,2'!&'7/,'3!$&/0#,1!2'#$2,!,-!,2'!?2''78/4'!O <!

2B OH
7 | !! | :JKL!E=!

,2'!6/&,!-.!,2'!8&/9'!.-&5'!/,!,2'!&'/&!/>7'!

| 07 H 7 | !! | :JKL!(=!

/+3!,2'!3'5'7'&/,#-+!A!

!"#$%&'(&)'*+&#,-.*,$+&'+/',0"'1-(2"'#3#,"4#'/+-',0"'⁵6+-4.7('8,.)"&,⁵9':(*$&%';(-#' | <=>

"! #$
%
| !! | "&'()*#!

+,--,./)012)3425-)62-503,7/138)920.227)012)965:37%)+,6;2)95/24),7)012).23%10),+)5--)<2= 13;-2)>/22)5-/,)?@AB()

< | >
!C<C3425-

D

E
$+ # $# F | G# H
E | ÷ | ÷ | !&'"#I#!
< | > !C1C3425-

D

E
$+ # $# | G# H
E | ÷ | ÷ | !&'"#J#!

E,6)012)3425-)965:37%)+,6;2)43/0639K03,7)+,--,.24)9L)2-3M37503,7),+)012)8565M2026)#N)

| O
!C1C3425- | !C<C3425- | !C<C3425-
O
D | D | D
E | E | E F | F
$ | G
E | @H | HE | OH | E
| | ÷ | ÷ | ÷ | !&'"#P#!

!5/24),7)>&'(PB)E3%K62)*)/1,./)012)3425-)965:37%) +,6;2)43/0639K03,7),+)012)!QRSPT/) 965:37%)+,6;2)43/0639K03,7)435%65M()U,),90537)012)92/0)8,//39-2)42;2-26503,7)012);,7= /06K;03<2) 7,6M5-) 43/0639K03,7) 7224/) 0,) 92) ,632705024) ,7) 012)M5"3MKM) ,+) 0362) 5412= /3,7())

V13-2)+,6),0126)E,6MK-5);56/)+6,70)574)6256).37%/)86,<342)/,M2);,7/342659-2)526,4L= 75M3;)4,.7) +,6;2C)37)012)E,6MK-5)W0K4270)012)M5"3MKM)/8224/) +,6)2++2;03<2)K/2),+) 526,4L75M3;)4,.7) +,6;2)3/) 0,,)-,.()U1262+,62C) 012) <32.);57)92)-3M3024)37) 012) /057= 4564);,7/06K;03,7) 0,) 012) 657%2) 0,) 59,K0) F(S)%()E,6)5).122-) +63;03,7)2++,60),+)F(S) 012) +6,70)574)6256)5"-2).3--)-,;:)/3MK-0572,K/-L)5/)/1,.7)+,6)012)/0574564);,7/06K;03,7)37) E3%K62)*())

U12)!QR)65;2);56/)4,)7,0)15<2),0126)965:2) +,6;2)624K;26)574)965:2) +,6;2)43/0639K= 03,7)K730/C)/,)012)625-)43/0639K03,7)3/)5-.5L/)62862/27024)9L)5)/0653%10)-372()

X7426) 43++26270) .122-) +63;03,7) ;,2++3;3270)+6,M) 012) /0574564) 965:2) +,6;2) 43/0639K03,7) 012)43/057;2)920.227)012)625-)574)3425-)965:2)+,6;2)43/0639K03,7)3/)1,.2<26)'K302)-56= %2()Y/)5)62/K-0)57)2"027424)/0,8837%)43/057;2)+,--,.37%)012),<26)965:24)+6,70)5"-2),+)
012) <213;-2) .301) 57) K7426/0226) /2-+) /022637%) 9215<3,K6() Z7) 85603;K-56C) 012) 625-3#59-2) M5"3MKM) +63;03,7);,2++3;3270) ,7) 012);,K6/2);57) <56L);,7/342659-L)42827437%) ,7) 0362) ;1,3;2)574)6,54)/K6+5;2C)/,)012)965:37%)+,6;2)43/0639K03,7)MK/0)5-.5L/)92)5458024)0,) 012)5;0K5-)6,54=+63;03,7)/30K503,7)92+,62)5);,M820303,7()

!!"# | $$%$&'#%(&)*(+&,-(+.#Æ#/012-3,41#

!"#$ %&'($)*#)"(+$',$ #-.',/$.-#($ %0"$1#-2+$3-(%+#$.45',6+#(7$5',2+6$0'%&$ -$3-,*-554$ -68*(%-15+$1-5-,.+$1+-37$-#+$*(*-5$9(++$:&-)%+#$;<=><$

?&'($ #+(*5%($',$ -$ -68*(%-15+$ @'+56$ %"$ -6-)%$%&+$ -A-'5-15+$ -6&+('",$ "@$ %&+$ %'#+($ %"$ %&+$ '6+-5$1#-2',/$@"#.+$6'(%#'1*%'",<$

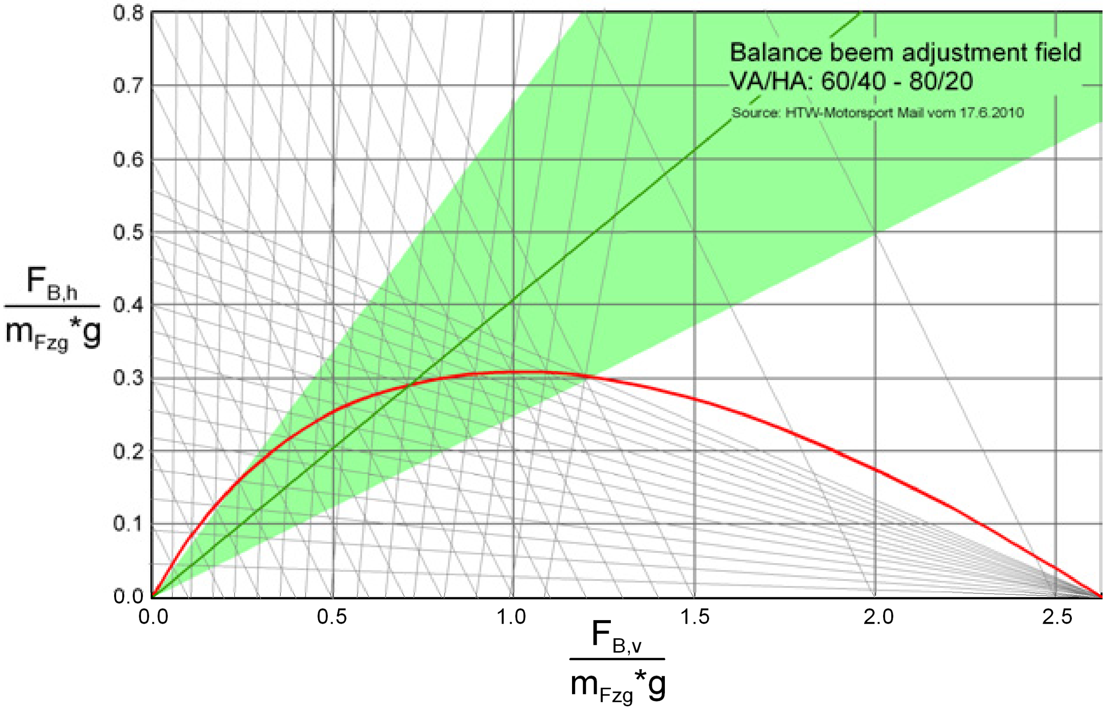
[picture p74: figure]

!'/*#+$BC$ D#-2+$ @"#.+$ 6'(%#'1*%'",$ 6'-/#-3$ "@$ %&+$ DE:FG$ 0'%&$ -68*(%3+,%$ "@$ %&+$ #+-5$1#-2+$@"#.+$6'(%#'1*%'",$

H,$ -$ A-#'-%'",$ "@$ %&+$ %'#+$ -6&+('",$ *(+6$@"#$ )5-,,',/$ -,6$ "..*##',/$ 6*#',/$ %&+$ #'6+$ 1"%&$-I5+($6"$,"%$5".2$-%$%&+$(-3+$%'3+$',$-$6+.+5+#-%'",$0'%&$%&+$3-I'3*3$-6&+J ('",$*%'5'K-%'",7$1*%$%&+#+$'($-$6+@',+6$5".2$(+L*+,.+<$M'%&"*%$%&+$*(+$"@$NDO$',$)#',J .')5+$'%$'($,+.+((-#4$%"$5".2$%&+$ @#",%$-I5+$1+@"#+$5".2',/$%&+$#+-#$-I5+$%"$+,(*#+$%&+$ .-#P($(%-1'5'%4<$?&+$%#-.%'",$+@@"#%$"@$%&+$@#",%$-I5+$3*(%$1+$/#+-%+#$%&-,$%&-%$"@$%&+$ #+-#$-I5+<$$

M&+,$(+%%',/$%&+$-.%*-5$1#-2+$@"#.+$6'(%#'1*%'",7$%&+#+@"#+7$%&+$%#-.%'",$+@@"#%$"@$%&+$ -I5+($&-($%"$1+$+I-3',+6<$

?&+$1#-2+$(%-1'5'%4$.-,$1+$-((+((+6$*(',/$%&+$ÆJK$6'-/#-3<$H,$%&'($6'-/#-37$%&+$'6+-5$ 1#-2',/$@"#.+$6'(%#'1*%'",$#*,($',$-$;B$Q$-,/5+<$?"$+A-5*-%+$%&+$1#-2',/$(%-1'5'%47$%&+$ .*#A+($"@$%&+$%'#+J-6&+('",$5'3'%($-#+$6#-0,$',$-66'%'",-5<$

!"#$%&'(&)'*+&#,-.*,$+&'+/',0"'1-(2"'#3#,"4#'/+-',0"'⁵6+-4.7('8,.)"&,⁵9':(*$&%';(-#' | <<=

!"#$%&'(#)*+")%"$%)$,-"./)0%$1")23%4")53%*'3()*+")$&+"/'3()-'6'*/)*$1"/7)

| 89+ | 89+ | 89+
89+ | 89: | ;
< | < | < = | = | = < >< | ? < | ? 6 # ÷ | ÷÷ | ! | "@A#!B!"

<%3(*)$,-"7

| :

C
?=
C D

÷
÷ | 3%)"AE':$-"(*7) | F@AG)CHI
89: | 89:
:
;9:9&K( | + | J
< | < C = | = | = < | C | - | + >D | 6 # | >?
? | - | -
| | ← ÷ | ÷ | | | | →

F@AG)CCI

!"$%)$,-"7)

⁺ ?=
D>

÷
÷ | 3%)"AE':$-"(*7) | F@AG)CLI
89+ | 89+
+
;9+9&K( | : | J
< | < = | = | = < | - | + D | 6# | ?
? | - | -
| ← | ÷ | ÷ |
| | | →
) | F@AG)CMI

<'#E%") N) /+3O/) $() ",$65-") 32) *+") $&+"/'3() 53*"(*'$-) 32) *+") :"+'4-") 8!PHQ) 23%) *+") $&+"/'3()32)CGH)$&RE/*"&)-'("$%)0%$1")23%4")&'/*%'0E*'3(G)

!!!" | ##$#%&"$'%()'*%+,'*-"Æ"./01,2+30"

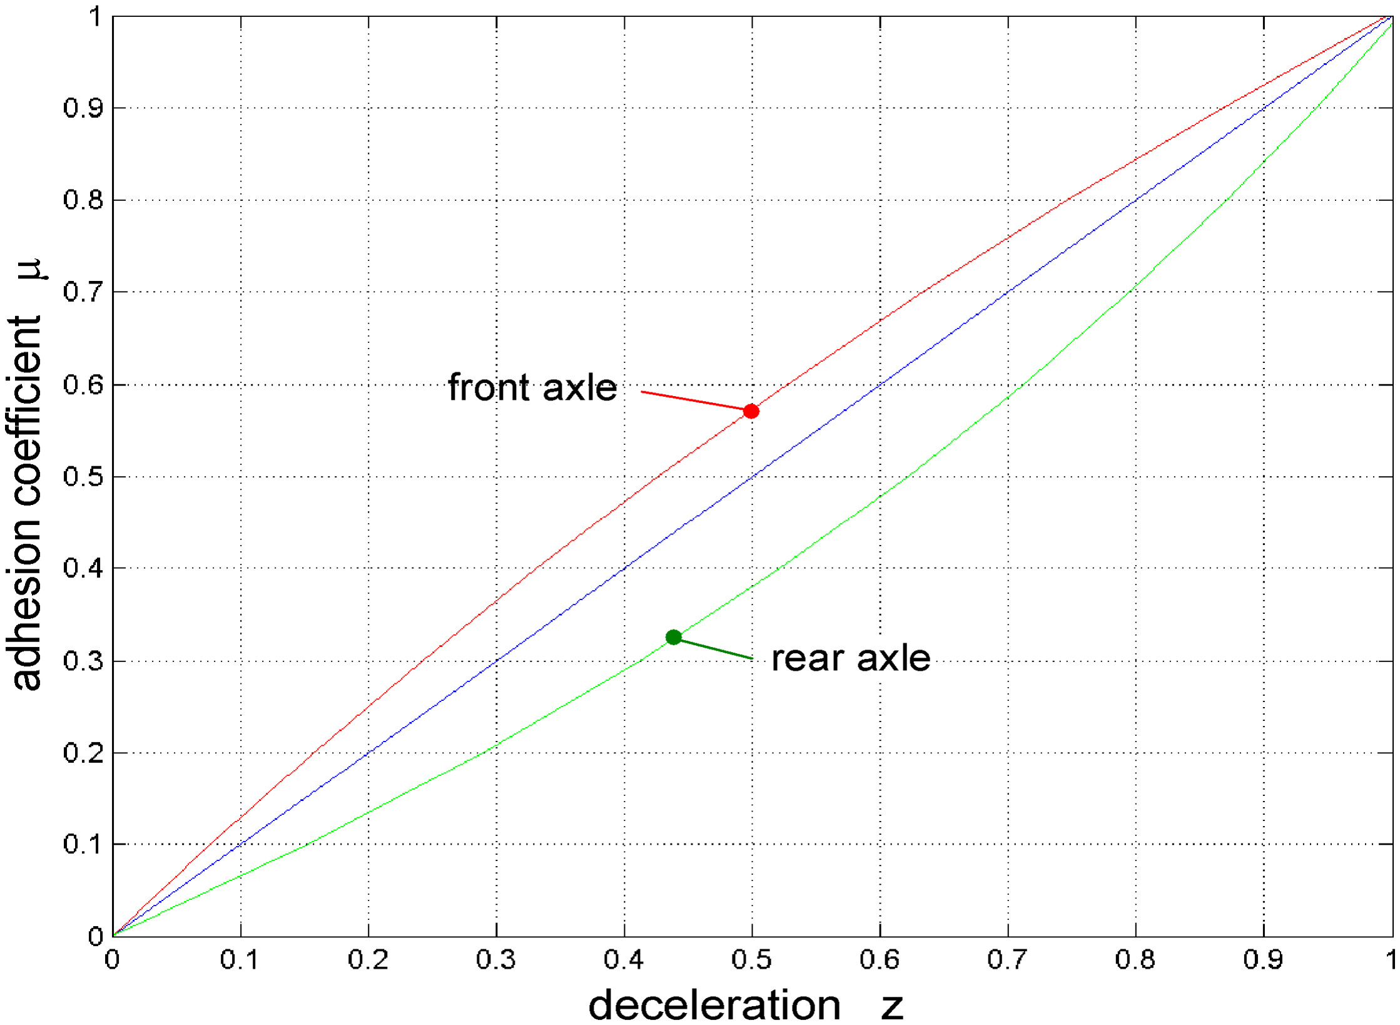
[picture p75: figure]

"#$%&'!()! *+,'-#./!0.1'/1#23!1.!&'0&'-'/1!1,'!4&25#/$!-124#3#16!7Æ89!+#2$&2:;!

!"! #$%&'()*$)+*,(-*.,$*/+,*01(

</!1,'!=".&:%32!>1%+'/1=!&%3'-!1?.!#/+'0'/+'/1!4&25'!@#&@%#1-!2&'!2-5'+A!</!-'3'@1#/$! 1,'!:'1,.+!.B!1,'!200.&1#./:'/1! B2#3!-2B'16!2/+!C',#@3'!+6/2:#@-!2-0'@1-!,2-!1.!4'! @./-#+'&A!

"2#3%&'!.B!./'!.&!4.1,!4&25'!@#&@%#1-!,2-!1?.!:2#/!&'2-./-)!

D'252$'!
1,'&:23!.C'&3.2+!

E,'!0&.424#3#16!.B!B2#3%&'!.B!1,'!4&25'!-6-1':!1,&.%$,!3'252$'!+'0'/+!-1&./$36!./!1,'! -6-1':!+'-#$/A!E,'!B2#3%&'!0&.424#3#16!&#-'-!?#1,!1,'!#/@&'2-'!.B!@.:0./'/1-!2/+!@./8 /'@1.&-A!F'&:2/'/136!#/-1233'+!2/+! B#G'+!02&1-!2/+!-121#@!-'23-!0&.C#+'!,#$,!-'@%&#16! 2$2#/-1!+'B2%31A!E,'!%-'!.B!,.-'!3#/'-!#/@&'2-'-!1,'!&#-5!.B!+'B2%31H!?,#@,!#-!?,6!1,'! &'$%321#./-! +.! /.1! 233.?! %/2&:.%&'+! 032-1#@! 0#0'-A! ".&! 1,#-! 0%&0.-'! :'123! :'-,! -,'21,'+! @243'-! 74&2#+'+! ,.-';! 2&'! %-'+A! *! ,#$,'&! 0&.424#3#16! .B! +'B2%31H! ,.?'C'&H! ,2C'!:.C'+! -'23-H! 2-! %-'+! B.&! 'G2:03'!#/! 1,'!:2-1'&! 4&25'! @63#/+'&! 2/+! 1,'! 4&25'! @23#0'&-!723-.!-''!IJK;A!*/!'L%2336!#:0.&12/1!2-0'@1!3#5'!1,'!:'@,2/#@23!B2#3%&'!#-!1,'! 0&.1'@1#./! 2$2#/-1! 2! B2#3%&'! 46! 1,'&:23! .C'&3.2+A! M6! C'&6! B&'L%'/1! 4&25#/$! 4'B.&'! '2@,!@%&C'!./!1,'!N/+%&2/@'!@.%&-'!1,'!4&25'-!2&'!,#$,36!-1&'--'+A!*!B2#3%&'H!4.1,!46!

!"#$%&'(&)'*+&#,-.*,$+&'+/',0"'1-(2"'#3#,"4#'/+-',0"'⁵6+-4.7('8,.)"&,⁵9':(*$&%';(-#' | <<=

!"#$%&"&'()%$%*"('+(',"(-#%."(/0&0&*(+#(-#%."()0123(%&)('"$!+#%#0/4(-4(',"(5%0/6#"(+5( ',"(-#%."(5/60)($61'(-"(2+&10)"#")(0&(',"(1"/"2'0+&(+5(2+$!+&"&'17(

8,"(5%0/6#"(+5(',"(-#%."(5/60)(2%&(-"(5"/'(%1(9%!+#(/+2.3(+#(-4(%&(0$!#+!"#(":'"&10+&( +5(',"(-#%."(!")%/('#%9"/(%1(%(#"16/'(+5(0&2#"%1")(2+$!#"110-0/0'4(+5(',"(/0;60)7(<5(',"#"( 01(%(-#%."(20#260'( 5%0/6#"3(0'($61'(%2,0"9"( ',"(,0*,"1'(!+110-/"( '#%2.( 1'%-0/0'4(%#"( #"= ;60#")(0&(+#)"#('+(&+'(+9"#>,"/$(',"()#09"#7(?"2%61"(+5(610&*(50:")(2%/0!"#(-#%."1(+&( ',"(5#+&'(%:/"1(+5(',"(?@ABC(%&)(',"(?@ABD(%(1/0*,'/4($+#"(!+10'09"(12#6-(#%)061(01( 1"'7(8,01()+"1(&+'(%//+>(%()0%*+&%/(-#%."(20#260'()01'#0-6'0+&3(10&2"(',"(,0*,"#(-#%."( 5+#2"(%'(',"( 5#+&'(%:/"(#"16/'1(0&(%(-#%."=4%>($+$"&'(',%'(2%&(&+'(-"(2+$!"&1%'")( -4( %&( 1'""#=4%>( $+$"&'( >,02,( >0//( -"( 0&0'0%'")( -4( ',"( .0&*!0&7( 8,"( -#%."( 20#260'( )01'#0-6'0+&($61'(',"#"5+#"(-"()"10*&")(%1( 5#+&'(%:/"(E(#"%#(%:/"(F-/%2.(E(>,0'"(/%4= +6'G3( >,02,( >0//( %/1+( 16!!+#'( ',"($"',+)( +5( ',"( %)H61'%-/"( -#%."( 5+#2"( )01'#0-6'0+&( 610&*(%(-%/%&2"(-"%$(F1""(%/1+(I"2'0+&(J7KG7(

!"# $%&'()*+,&-./0+

<&(90">(+5(%(,0*,(',"#$%/(#"/0%-0/0'4(>,0/"(10$6/'%&"+61/4(#")620&*(',"($%11"1(%(&6= $"#02%/(2%/26/%'0+&(+5(',"(,"%'(-6)*"'(+5(',"()"902"(01(61"56/7(L6#0&*(',"(-#%.0&*(!#+= 2"11( ',"( )012( ,%1( '+( 1%9"( %-+6'( CB=DBM( +5(',"( '+'%/( -#%.0&*( "&"#*4( %1( ,"%'7( N&/4( %-+6'(KB=OBM(+5(',"#$%/("&"#*4(2%&(-"()"/09"#")(%1( 5+#2")(+#( 5#""(2+&9"2'0+&(+#(#%= )0%'0+&(0&'+(',"("&90#+&$"&'7(8,"#"5+#"(',"(',"#$%/()"10*&(+5(%(-#%."(141'"$(01($%)"( "11"&'0%//4(+&(',"()0$"&10+&1(+5(',"(-#%."()01.7(

8,"('+'%/(,"%'(5/6:(+&(',"()012(01(2+$!+1")(+5(',"(2+$-0&")(,"%'(5/6:(16!!/0")(-4(',"( >,""/(-#%."(FP?

| G(%&)(',"(!#+!+#'0+&1(+5(,"%'(#%)0%'0+&(FPI'
| G3( 5#""(%&)( 5+#2")(2+&=

9"2'0+&(FPQ

| G(%&)('+(+',"#(2+$!+&"&'1(',#+6*,()0#"2'")(,"%'(5/+>(FPR
| G7((

8%.0&*(0&'+(%22+6&'(',"(!+#'0+&(+5(-#%."(5+#2"(%'(',"(#"%#(%:/"(-4(FS;7(DG3(!7(OOK3(5+#( ',"(%2'6%/(1!"")(9(5+//+>(',"(0$!/"$"&'")(!+>"#(%'(',"(5#+&'(%&)(#"%#(>,""/(-#%."1T(

?3I2,"0-"3, | ?3I2,"0-"3,
K U | V | $ * W 9VP | V5 ' O
÷ ÷ ÷÷÷ | | ( | FS;7(KJG
?3I2,"0-"39 | ?3I2,"0-"39
K U | V | K | $ * W 9VP | V5 ' O
÷ | ÷ ÷÷÷ | | ( | FS;7(KXG

!!"# | $$%$&'#%(&)*(+&,-(+.#Æ#/012-3,41#

!"#$%&'$()'*+,-$*,('$".$%&'$/#,0'$1+(*2$%&'$(),%+,-$1+3'4(+"4$+4$%&'$%&'#3,-$*,-*5-,6 %+"4$,#'$#'15*'12$!+75#'$82$+4$%&,%$"4-9$,$*#"(($('*%+"4$".$%&'$.#+*%+"4$#+47$+($*"4(+16 '#'1:$

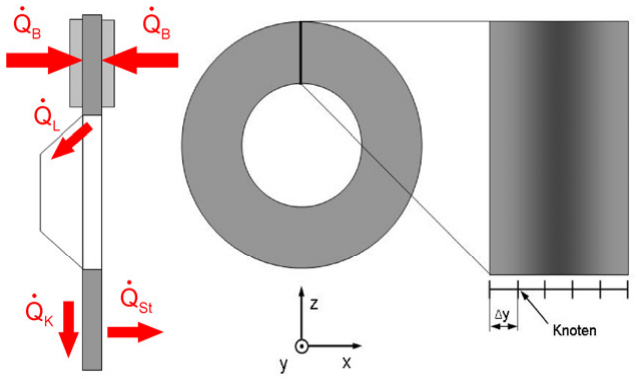
[picture p76: figure]

!+75#'$8;$ <#,0'$1+(*$3"1'-$

=4$%&'$3"1'-$ ."#$*,-*5-,%+47$%&'$/#,0'$1+(*$%'3)'#,%5#'$,($,$ .54*%+"4$".$%&'$1+3'46 (+"4+47$,41$*&"+*'$".$3,%'#+,-2$%&'$&',%$*5##'4%$>5,4%+%+'($+4$%&'$/#,0'$),1($,41$#"6 %"#($+4$%&'$/#,0'$1+(*$)"%$?+--$/'$(533,#+@'$,41$/5+-1$%"7'%&'#$?+%&$%&'$*"4A'*%+"4$ ,41$#,1+,%+"4$&',%$.-5B$,$*"33"4$)'#*'4%,7'$&',%$.-"?$#54"..:$

! "#$%&'#(&#&)*

=4$,$."#35-,$*,#$,$/#,0'$/""(%'#$+($5(5,--9$4"%$5('12$("$%&,%$+4$,11+%+"4$%"$%&'$1'*'-6 '#,%+"4$/'&,A+"#$%&'$*-,3)+47$'4'#79$".$%&'$(9(%'3$+($".$7#',%$+3)"#%,4*':$C4-9$%&'$ '4'#79$DE/'%F$)#"A+1'1$/9$%&'$1#+A'#$+($A,+--,/-':$=%$+($#'>5+#'1$."#;$

G-,3)+47$'4'#79$DEH)F$D'B),4(+"4$".$%&'$/#,0'$*,-+)'#(F$ H%#,+4$'4'#79$DEI/F$".$%&'$%#,4(3+((+"4$1'A+*'$D':7:$&"('$-+4'(F$

E K ! 1( K ) 1L M ! 1( <'% | ¨ | ¨ | ¨ <'% | <'% | J/ | J/ | H) | H) | $ | DN>:$OPF

Q&'$,*%5,%+"4$'4'#79$35(%$/'$3+4+3+@'1$/'*,5('$"4$%&'$"4'$&,41$%&'$)'1,-$%#,A'-$+($ A'#9$-+3+%'1$%&#"57&$%&'$'B+(%+47$(),*'$,41$"4$%&'$"%&'#$&,41$%&'$1#+A'#$+($-",1'1$/9$ ,$&+7&$-'A'-$".$,*%5,%+"4$."#*':$$

!"#$%&'(&)'*+&#,-.*,$+&'+/',0"'1-(2"'#3#,"4#'/+-',0"'⁵6+-4.7('8,.)"&,⁵9':(*$&%';(-#' | <<=

!"#$%&'%#(%$)*+%)+%,-%(.%/)0#).1%)'$%)",)+020/).'3%$)*#/)1"$%)-0#%$4).1+"'21).1%)'$%)",) $.0,,%+)3+*5%)(*-06%+$4)3+*5%),-'0/)70.1).1%)'$%)",)-"7)("86+%$$030-0.94)8*:080;0#2),+0(< .0"#)+*/0'$)*#/)0#)*)-"7)$9$.%8)6+%$$'+%)-%=%-)>?@<A@)3*+BC)D#)6*+*--%-4).1%)*(.'*.0"#) ",).1%)3+*5%)6%/*-)*-$")1*$).")3%)/%$02#%/)0#).%+8$)",)%+2"#"80($C)

!"# $%&'(&)*+,-./)%.,

E1%)/%$02#)",).1%)*(.'*.0"#)/%=0(%)",)*),"+8'-*)(*+)/0,,%+$)#".*3-9),+"8).1%)'$'*-)/%< $02#$)",)6*$$%#2%+)(*+$)0#).1%)-0#5*2%)",).1%)3+*5%)6%/*-).").1%)3+*5%)8*$.%+)(9-0#/%+C) E1%)*(.'*.0"#)/%=0(%)8'$.)1*=%)*#)*/F'$.*3-%)3+*5%)6%/*-)+*.0")*.)"#%)1*#/)*#/)*#) */F'$.*3-%)$.*.0()3+*5%),"+(%)/0$.+03'.0"#)*.).1%)".1%+)1*#/C)

G) $8*--)6%/*-) .+*=%-)*#/)*) $.0,,)3+*5%) $9$.%8)-%*/$) .") *) $%('+%) ,%%-0#2) *.) .1%)3+*5%) 6%/*-C)H9) .1%)-90#2) $%*.0#2)6"$0.0"#) ",) .1%)/+0=%+4)0.)0$)/0,,0('-.).")/"$%) .1%)3+*50#2) ,"+(%)/'+0#2)%8%+2%#(9)3+*50#2C)

!"#"# 0(1%'1(&)*+,

E1%)3+*5%)6%/*-)+*.0")(*#)3%)(1*#2%/)70.1)1%-6)",).1%)-%=%+)2%"8%.+9)"+)*#)*/F'$.< *3-%)*#2-%)3%.7%%#).1%)3+*5%)6%/*-),"+(%)>IJB)*#/).1%)*(.'*.0"#),"+(%)/0+%(.%/).").1%) 8*$.%+)(9-0#/%+)>IKL4H%.BC)I02'+%)M)$1"7$).1%),"+(%$)*.).1%)*(.'*.0"#)/%=0(%C)

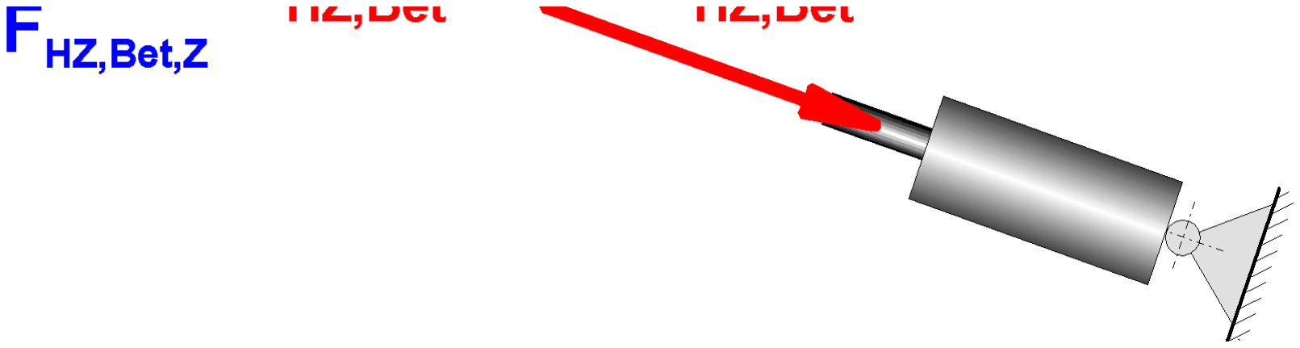
[picture p77: figure]

I02'+%)MN) I"+(%$)*.).1%)*(.'*.0"#)/%=0(%)

G),-%:03-%)8"/0,0(*.0"#)",).+*#$80$$0"#)"#).1%)$6".4)1"7%=%+4)(*#)"#-9)+%*(1%/)70.1)*) ("86-0(*.%/) (1*#2%) ",) .1%) 3+*5%) -%=%+O$) 2%"8%.+94) 3%(*'$%) .1%) 3+*5%) 6%/*-) 3%*+0#2) (*#)3%)%:6"$%/).")1021)-"*/$C)

!!"# | $$%$&'#%(&)*(+&,-(+.#Æ#/012-3,41#

!"#$%&'"(&$")*+&,(-.,(/'.)+&)0&'"(&1/'#1'.)+&0),/(&2&1$&.+&'"(&3("./4(&,(14.5(-&6789:& 2&4(1-$&')&1&".;"&<(1,.+;&4)1-&1'&'"(&<,1=(&>(-14&'",)#;"&'"(&0),/(&A?%@1;(,

G | B&
A | EA FA ?%@1;(, | ? | CD%6('
G | G | G | GHIB&JKL

!".$&*1$&/)+$.-(,(-&1'&'"(&,1/.+;&/1,&6789M&1+-&'"(&<(1,.+;&)0&'"(&>(-14&*1$&>)$.2 '.)+(-&&#+-(,&'"(&N1$'(,&<,1=(&/O4.+-(,G$((&A.;#,(&JP%&>BQP9LB&

6(''(,&$#.'(-&'"1+&'"(&/"1+;(&)0&'"(&<,1=(&>(-14&;()N(',O&0),&1+&(1$O&1-R#$'N(+'&)0& '"(&>(-142',1+$N.$$.)+&.$&1&04(S.<4(&/"1+;(&)0&'"(&'.4'&1+;4(&&0),&'"(&N1$'(,&<,1=(&/O42 .+-(,B&A),&'"(&N1.+&<,1=(&/O4.+-(,&-.,(/'.)+14&/)+',)4&0),/(&.$&314.-T&

? | J
CD%6('
Q
A@ A | E
/)$ | @

÷
÷ | & | GHIB&J:L

A.;#,(&MT& 6141+/(&<(1N&

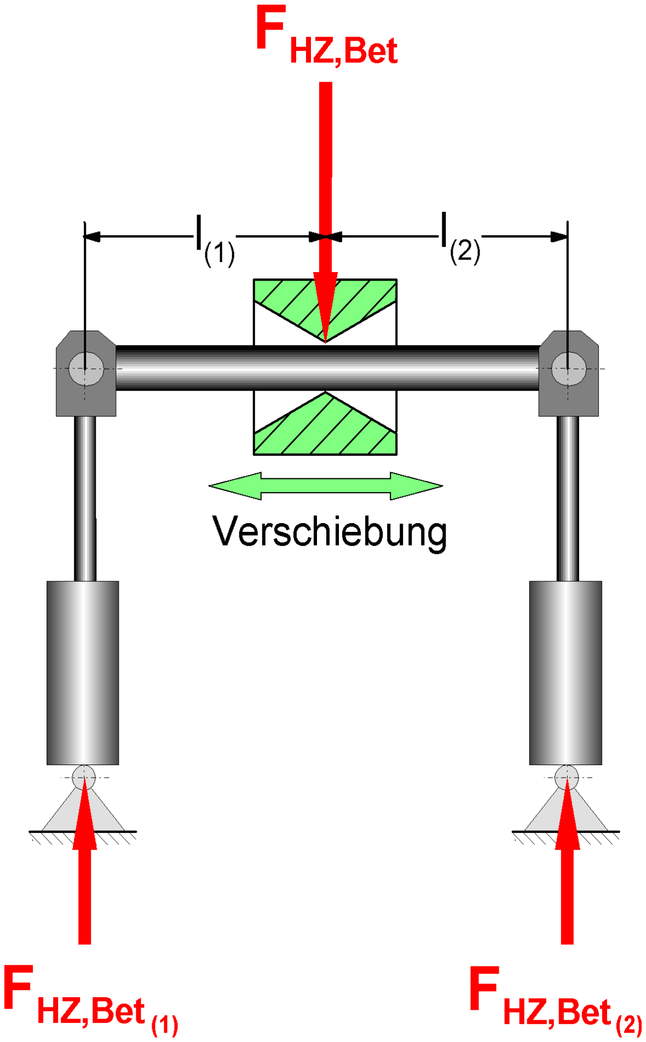
[picture p78: figure]

!)&1-R#$'& '"(& $'1'./&<,1=(& 0),/(&-.$',.<#'.)+&')& '"(&-.00(,(+'& 1-"($.)+&/)+-.'.)+$& )+& '"(&/)#,$(&'"(&<,1=(&>(-14&0),/(&GACD%6('L&*.44&<(&-.3.-(-&)+&'*)&N1.+&<,1=(&/O4.+-(,$B&&

U.'"& '"(&/"))$(+&<,1=(&/.,/#.'&-.$',.<#'.)+&1'& '"(&3("./4($&6789:& 1+-&6789M& G$((& 81>BL&'"(&0,)+'&1+-&,(1,&1S4(&(1/"&)>(,1'(-&*.'"&1&$.+;4(2/.,/#.'&N1$'(,&<,1=(&/O4.+2 -(,B&!"(&-.$',.<#'.)+&)0&'"(&>#$"&,)-&0),/($&1$$#N($&1&<141+/(&<(1N&*.'"&1+&1-R#$'2 1<4(&>)$.'.)+&')&/)+-#/'&'"(&1/'#1'.)+&0),/(&GACD%6('L%&A.;#,(&M%&-.,(/'(-&')&'"(&<,1=(& N1$'(,&/O4.+-(,B&

!"#$%&'(&)'*+&#,-.*,$+&'+/',0"'1-(2"'#3#,"4#'/+-',0"'⁵6+-4.7('8,.)"&,⁵9':(*$&%';(-#' | <<=

!"#$%&'$("#)'*$%"$%&'$+#,-'$.,*%'#$)/0123'#*$41%&$$0$5$0678906:8$("00"4*$(#".$%&'$';<101+= #1<.$)"231%1"2*$"2$%&'$+,0,2)'$+',.>$

?@AB'% :
?@AB'% 7
! | 0
! | 5
0
÷ | $ | 6C;D$7E8
?@AB'% | 7
?@AB'% :
! | 0
! | 5
0
÷ | $ | 6C;D$:F8

G+%,12$%"H'%&'#$41%&$C;D7I>$

J | 7 | :
?@AB'% 7
| | :

!K0
! | 5
)"* | K 0

÷÷
÷ | ÷ | $ | 6C;D$:78

J | 7 | 7
?@AB'% :
| | :

!K0
! | 5
)"* | K 0

÷÷
÷ | ÷ | $ | 6C;D$::8

B'),<*'$"($ %&'$)&"1)'$ %"$,$ (#"2%$L$ #',#$,M0'$31*%#1+<%1"2$,2$',*/=%"=1.N0'.'2%$+,*1)$ +#,-'$N#'**<#'$31*%#1+<%1"2$),2$+'$.,3'$+/$.',2*$"($,$*'N,#,%'$31.'2*1"212H$"($%&'$ .,12$+#,-'$)/0123'#$N1*%"2$31,.'%'#$63?@6M88D$O2$*<..,#/$1%$1*$P,013$ ("#$%&'$#'0,%1"2= *&1N$+'%4''2$%&'$+#,-'$N'3,0$,23$%&'$+#,-'$)1#)<1%$N#'**<#'>$

: | J | 7
7
?@ | :
7
0 | Q! K
N5
3: | )"* | K 0
÷ | ÷ ÷ ÷ | ÷ | ÷ | !C;D$:R"#
7 | J | 7
:
?@ | :
:
0 | Q! K
N5
3: | )"* | K 0
÷ | ÷ ÷ ÷ | ÷ | ÷ | !C;D$:Q"#

!"#"$ %&'(&)*)+,-

QD7D:D7 J'3,0$+"M$

S&'$3'*1H2$"($%&'$N'3,0$+"MA$)"2*1*%12H$"($+#,-'$,23$,))'0'#,%"#$N'3,0A$&,*$%"$+'$*<+= T')%$%"$%&'$("00"412H$)"231%1"2*>$

)".N,)%$,23$01H&%4'1H&%$3'*1H2$
*N,)'$"N%1.1U'3$
*%1(($N'3,0*$
#1H13$."<2%12H$

,3T<*%,+0'$12$M=31#')%1"2$

!!"# | $$%$&'#%(&)*(+&,-(+.#Æ#/012-3,41#

!"#$%$&'()**+,$-.'&'/!0,
'%.!#").'$%,'%.$,.1!,2")&!,3."4(.4"!,

5$",.1!,0"'6!",.$,7!,)7*!,.$,.)8!,),2).'#4!,2"!!,"'0'%#,-$3'.'$%9,'.,'3,$2,)06)%.)#!,.1)., .1!,-!0)*,7$:,'3,&$6)7*!,'%,.1!,;,0'"!(.'$%,)%0,.1!,)%#*!,$2,.1!,-!0)*3,()%,7!,)0< =43.!0>,?'.1,.1!,43!,$2,0"'6!",3-!('2'(,3!).,'%3!".3,)%,)0=43.&!%.,$2,.1!,-!0)*,7$:,'%, ;,0'"!(.'$%,'3,%$.,%!(!33)"+>,5$",),2).'#4!,2"!!,-$3'.'$%9,'.,'3,)*3$,43!24*,%$.,.$,-$3'< .'$%, 1'3, 2!!., 6!".'()*, $%, .1!, -!0)*39, 74., 3*'#1.*+, '%(*'%!0, '%, .1!, 0'"!(.'$%, $2, .")6!*>, @1'3,()%,7!,0$%!,A'.1,.1!,-'.(1'%#,$2,.1!,-!0)*3,).,)7$4.,B<CDE,2"$&,.1!,F<):'3,$",7+, .1!, $223!., $2, .1!, ."!)0, $2, .1!, -!0)*, .$, .1!, -$3.'%#, $2, .1!, 1!!*, 7+, )7$4., CD<GD,&&>, ?'.1, )%,'%("!)3'%#, )%#*!9, 1$A!6!"9, .1!, 43)7*!,)(.4).'$%, 0'3-*)(!&!%.,'3,*'&'.!0>, H%, .1!, 3'..'%#, -$3'.'$%, $2, .1!, IJKDLMDN<6!1'(*!3, ),&):'&4&, $-!").'%#, )%#*!, $2, )7$4., GBE,'3,-$33'7*!,.$,%$.,.$,$6!"3."!.(1,.1!,2$$.>,,

5'#4"!,CD,31$A3,),38!.(1,$2,.1!,-!0)*,7$:,$2,.1!,IJKDL,($%3'3.'%#,$2,7")8!,)%0,)(< (!*!").$",-!0)*>,@1!,7)*)%(!,7!)&,.$,.1!,7")8!,&)3.!",(+*'%0!",'3,*$().!0,4%0!",.1!, 6!1'(*!,2*$$",).,.1!,IJKDL>,O,(*4.(1,-!0)*,'3,%$.,)6)'*)7*!,7!()43!,.1!,(*4.(1,'3,!*!(< ."'()**+, $-!").!0,6'), .1!, 3.!!"'%#,A1!!*>,@1!,"!)*,6!"3'$%,'%, .1!,IJKDL,'3, 31$A%,'%, 5'#4"!,CC>,

5'#4"!,CDP, IJKDL,-!0)*,7$:,38!.(1,QRS,

!"#$%&'(&)'*+&#,-.*,$+&'+/',0"'1-(2"'#3#,"4#'/+-',0"'⁵6+-4.7('8,.)"&,⁵9':(*$&%';(-#' | <<=

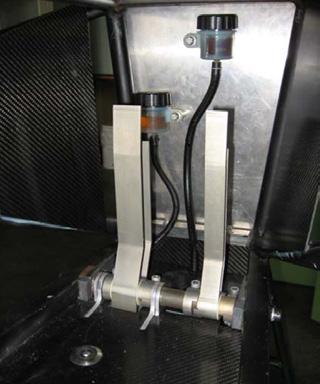
[picture p79: figure]

"#$%&'!(()! *+,-.!/'012!345!678!

9:'! 3&1;'! /'012! :1<! 1=! 10>%<?132'! <?4/!#=! ?:'! &'2'1<'0! /4<#?#4=@! A:#B:! '=<%&'<! ?:'! <1C'!4/'=#=$!4C!?:'!B4D/'=<1?#4=!34&'!E<=#CC#=$!:42'F!#=!?:'!D1<?'&!BG2#=0'&<@!"#$%&'! (HI! 9:'! 0#<?1=B'! 3'?A''=! 3&1;'! 1=0! 1BB'2'&1?4&! /'012! D%<?! 3'! 4C! <%CC#B#'=?! <#J'! ?4! <1C'2G!/&'K'=?!1!B4=?1B?!4C!?:'!<:4'<!A:'=!4/'&1?#=$I!

L<!/1&?!4C!?:'!0'K'24/D'=?!4C!?:'!3&1;'!<G<?'D!C&4D!?:'!*+,-.!?4!?:'!*+,-M!?:'! /'012!345!A1<!/1&?#B%21&2G!1CC'B?'0!3G!B:1=$'<I!9:'!/'012<!4C!?:'!*+,-M!04!A#?:4%?! 1!C4&B'!&'0#&'B?#4=I!9:'!3&1;'!D1<?'&!BG2#=0'&!?:'&'C4&'!:1K'!3''=!/21B'0!#=!?:'!#=?'N &#4&@!:4A'K'&@!?:'!3&1;'!/'012!#<!2'<<!3%&0'='0I!"#$%&'!(O!<:4'<!?:'!/'012!345!4C!?:'! *+,-MI!!

!"#$ | %%&%'($&)'*+),'-.),/$Æ$0123.4-52$

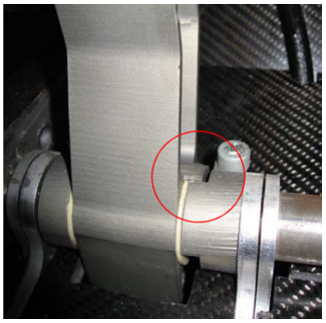
[picture p80: figure]

"#$%&'!()*! +&,-'!.'/,0!123.!456!

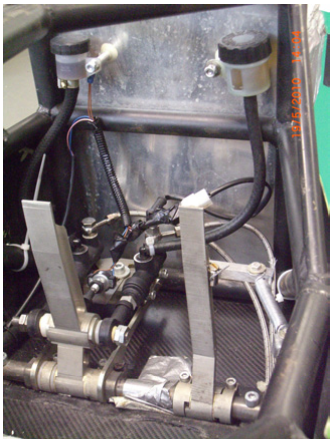
[picture p81: figure]

"#$%&'!(7*! +89:;!.'/,0!<3=!

>?(?)?) +,0,@A'!<',B!

CD'!12&%A2%&'!3E!2D'!<,0,@A'!<',B!#1!/'1#$@'/!E3&!<32D!F'D#A0'1!#/'@2#A,00G?!H1.'A#,00G! ,! 1D3&2! /'1#$@! 3E! 2D'! <',B!I,1!#@! E3A%1! 23! ,AD#'F'! D#$D! 12#EE@'11?!CD'! %@,11'B<0'/!! <,0,@A'!<',B!#1!1D3I@!#@!"#$%&'!(>!I#2D!,@/!#@!!"#$%&'!(J!I#2D3%2!2D'!10#/#@$!10''F'?!

!"#$%&'(&)'*+&#,-.*,$+&'+/',0"'1-(2"'#3#,"4#'/+-',0"'⁵6+-4.7('8,.)"&,⁵9':(*$&%';(-#' | <=>

!"#$ %&'(')*$ %&##+#$,-(#$ ./$%0##&$ 123$'%$ 45#%%#($')0.$ 0"#$ 65-7#$ 4#(-&$,-(#$ ./$ -&8,'9 )8,:$ 0.$ 5#(8;#$ 0"#$ <#-5$ /5.,$ 0"#$ 6-&-);#$ ('%7$ 1=3$ <"';"$ '%$ %844.50#($ ')%'(#$ 0"#$ %&##+#>$!"#$4.%'0'.)$./$0"#$6-&-);#$('%7$0.$0"#$0<.$?.')0$"#-(%$1@3$5#*8&-0#%$0"#$65-7#$ /.5;#$('%05'680'.)>$

!"#$ ?.')0$"#-(%$15.($#)(%3$-5#$,.8)0#($0.$0"#$0"5#-($.)$0"#$0"5#-(#($5.($1A3$#-;"$ 6B$-$;#)0#5')*$('%7$1C3$-)($-$)80$1D3>$E"#)$8%')*$-$%0-)(-5($0"5#-($0"#$;.5#$('-,#9 0#5$./$0"#$0"5#-(#($5.($'%$0..$&.<:$%.$'0$;.8&($*#0$(#/.5,#(>$F)$.5(#5$0.$45#+#)0$/5.,$ 085)')*$0"#$6-&-);#$('%7$(85')*$0"#$-(?8%0,#)0:$'0$<'&&$6#$/'G#($6B$,#-)%$./$-$4')$1H3$ ')$0"#$%&##+#$123>$E'0"$"#&4$./$0"#$;#)0#5')*$('%7%$0"#$&-0#5-&$;&#-5-);#$./$0"#$6-&-);#$ 6#-,$'%$-(?8%0#($%.$0"-0$0"#$0"5#-(#($5.($;-)$/5##&B$?.**&#$')$-$/-'&85#$./$.)#$65-7#$ ;'5;8'0:$680$0"#$%&##+#$;-)$).0$,.+#$#G;#%%'+#&B$(85')*$).5,-&$.4#5-0'.)>$$

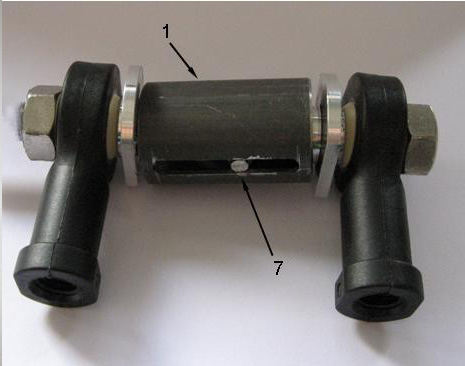
[picture p82: figure]

I'*85#$2CJ$ K-&-);#$6#-,$<'0"$%&'(')*$%&##+#$LAM$

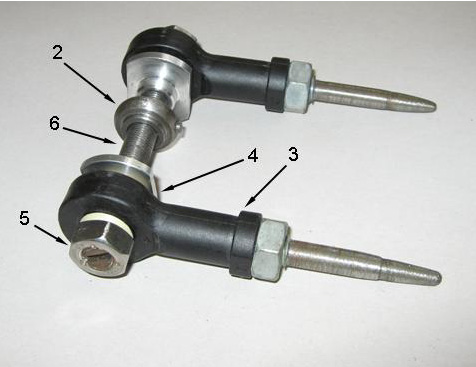
[picture p83: figure]

I'*85#$2DJ$ K-&-);#$6#-,$LAM$

!"!# | $$%$&'#%(&)*(+&,-(+.#Æ#/012-3,41#

!"#$%&#'()&#*+#&,,*,#$%&#'&"$&,-".#/-)0#-)#)122*,$&/#($#$%&#'*33(,#-")-/&#$%&#)3&&4&5#6%&# /-(7&$&,#*+#$%-)#'*33(,#/&$&,7-"&)#$%&#3*)$#$,(4&3#/1,-".#$%&#+(-31,&#*+#(#8,(0&#'-,'1-$5# 9/4("$(.&)# *+# $%-)# ):)$&7# (,&# )-723&# 7("1+('$1,&# ("/# 1)&# *+# 3-.%$# ;&-.%$<23()$-'# 8&(,-".)5#9#/-)(/4("$(.&#-)#$%&#;&(,#*+#$%&#8(3("'&#/-)0#-"#$%&#)3&&4&#+*,#(#1"+(4*,< (83&#7($&,-(3# )&3&'$-*"=#;%-'%#'("#8&# ,&/1'&/#8:# $%&#1)&# *+# (# >?"-8(33>#3-"0(.&5#6%&# 1)&# *+# (# >?"-8(33>#3-"0(.&# %*;&4&,# ,&@1-,&)# ("#&"3(,.&7&"$# *+# $%&# )3-/-".# )3&&4&>)#/-< (7&$&,5#

6*# '%(".&# $%&# 8,(0&# +*,'&# /-)$,-81$-*"# /1,-".# $%&# ,('&# ("# (/A1)$7&"$# *+# $%&# 8,(0&# 8(3("'&# -")-/&# $%&# '*'02-$# -)# 7&("-".+135#B*,# $%-)# $%&# $%,&(/&/# ,*/# *+# $%&# 8(3("'&# 8&(7#-)#$1,"&/#-"#$%&#'*'02-$#8:#7&(")#*+#(#+3&C-83&#)%(+$#;-$%#(#0"*85#D&)$#2*)-$-*")# -"# $%-)# 0"*8# 2,&4&"$# ("# (1$*7($-'# (/A1)$7&"$# *+# $%&# 8,(0&# 8(3("'&# ;%-3&# /,-4-".5# 6%&#"*,7(3#8,(0-".#+*,'&#/-)$,-81$-*"#,($-*#*+#+,*"$#E#,&(,#+*,#$%&#FDGHI#-)#JIKLM#*"# $%&#8(3("'&#8&(75#

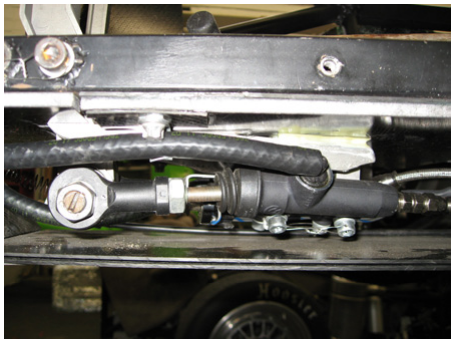
[picture p84: figure]

B-.1,&#NJK# O()$&,#':3-"/&,#($#$%&#FDGHI#PJQ#

R5N5M5L O()$&,#':3-"/&,#

B-.1,&#NS#)%*&)#$%&#8(3("'&#8&(7#("/#$%&#(/(2$-*"#*+#$%&#7()$&,#':3-"/&,)#1"/&,#$%&# 4&%-'3&#+3**,#8(3("'&#8&(7#("/#$%&#8,(0&#7()$&,#($#$%&#FDGHI5#6%&#(/(2$-*"#*+#$%&# 8,(0&#7()$&,#':3-"/&,)#($#$%&#FDGHT#)%*;)#B-.1,&#NM5#9)#(#7()$&,#8,(0&#':3-"/&,=#-"# 2,-"'-23&=#7*$*,':'3&#7()$&,#8,(0&#':3-"/&,)#+*,#+**$#('$1($-*"#'("#8&#1)&/5##

6%&)&#(,&#81-3/#()#(#)-".3&<'-,'1-$#/&4-'&=#%(4&#)7(33#/-7&")-*")#("/#(33*;#("#&C$&,< "(3#$("0#&('%5#6%&#1)&/#':3-"/&,#(,&#7(/&#8:#$%&#7("1+('$1,&,#F,&78*#U#'*7&#12#

!"#$%&'(&)'*+&#,-.*,$+&'+/',0"'1-(2"'#3#,"4#'/+-',0"'⁵6+-4.7('8,.)"&,⁵9':(*$&%';(-#' | <==

!"#$%"&'$%#()*$+,#+-,&.$/,&'$($0,.&"1$2,(3*&*#$"!$45$336$($+"30"1*1&$3(..$"!$78$9$ (12$&'*:$(#*$!,;*2$3"-1&*2$&"$&'*$+'(..,.<$=-#,19$&'*$%#()*$(+&-(&,"16$&'*$0-.'$#"2$ ,.$9-,2*2$"1$($+,#+->(#$>,1*$(&$&'*$.,2*$"!$&'*$0*2(>6$."$&'(&$&'*$+:>,12*#$3-.&$'(?*$($ @",1&$%*&/**1$&'*$0-.'$#"2$(12$0,.&"16$/',+'$+(1$%*$%*1&$(&$($#(19*$-0$&"$(%"-&$8$A<$ B,9-#*$4C$.'"/.$&'*$%(.,+$.&#-+&-#*<$D$2,.(2?(1&(9*$"!$&',.$+:>,12*#$,.$&'*$>"..$"!$0,.E &"1$!"#+*$+(-.*2$%:$&'*$%*12$(19>*<$

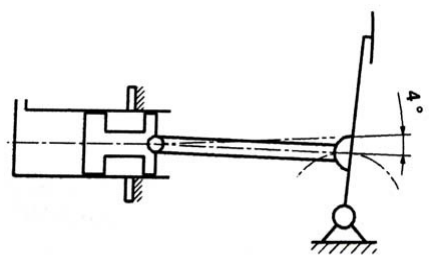
[picture p85: figure]

B,9-#*$4CF$ G(.&*#$%#()*$+:>,12*#$/,&'$(19->(#$2*?,(&,"1$HCI$

J1$0#,1+,0>*6$3(.&*#$%#()*$+:>,12*#$/,&'$($#,9,2$+"11*+&,"1$%*&/**1$&'*$0-.'$#"2$(12$ 0,.&"1$(#*$0"..,%>*$&"$-.*$&'*$*1&,#*$(?(,>(%>*$(+&-(&,"1$!"#+*<$$

K"/*?*#6$ &'*$ +:>,12*#$ 3-.&$ &'*1$ %*$ 0,?"&*2<$ L-+'$ +:>,12*#.$ (#*$ *M-,00*2$ /,&'$ ($ .&#"19*#$0-.'$#"2$(12$'(?*$($',9'*#$/*,9'&<$

N'*$%#()*$>,9'&$"!$&'*$?*',+>*.$/',+'$/(.$0#*.+#,%*2$%:$&'*$#*9->(&,"1.$,.$(+&,?(&*2$ %:$3*(1.$ "!$ ($ ':2#(->,+$ ./,&+'$ +"1&#">>*2$/,&'$ &'*$ %#()*$ +,#+-,&$ "!$ &'*$ !#"1&$ (;>*<$ N'*$ ./,&+'$,.$ (2(0&*2$2,#*+&>:$ &"$ &'*$0,0*$+"11*+&,"1$ (&$ &'*$3(.&*#$%#()*$+:>,12*#6$ B,9-#*$47<$O*+(-.*$"!$&'*$#"%-.&$2*.,91$PQ=$>,9'&.$(#*$-.*26$B,9-#*$4R<$

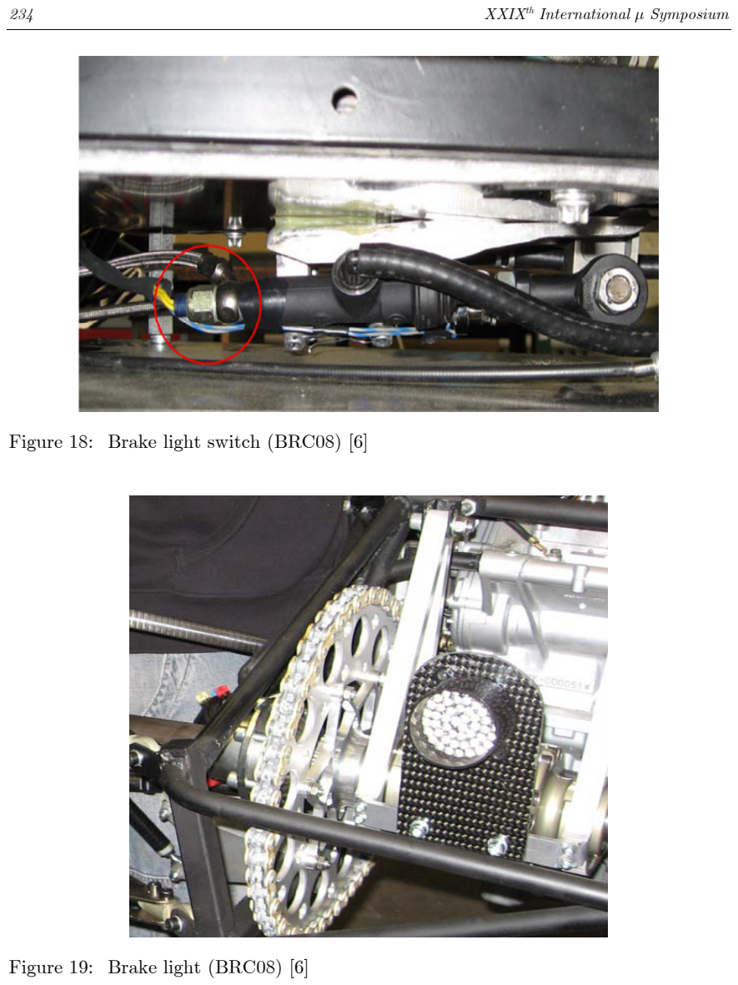
[picture p86: page 25]

!"#$ | %%&%'($&)'*+),'-.),/$Æ$0123.4-52$

"#$%&'!()*! +&,-'!.#$/0!12#03/!4+567)8!9:;!

"#$%&'!(<*! +&,-'!.#$/0!4+567)8!9:;!

!"#$%&'(&)'*+&#,-.*,$+&'+/',0"'1-(2"'#3#,"4#'/+-',0"'⁵6+-4.7('8,.)"&,⁵9':(*$&%';(-#' | <=>

!"# $%&'()*((*+',-./*0.,

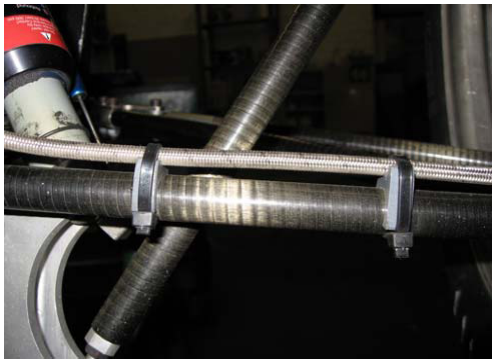
[picture p87: figure]

"#$%&'!()*! +'#,-.&/'0!1.2'!34!41'!5+6)7!89:!

!"#"1 2%&3.,4*'.(,

;1'!4&3,2<#22#.,!0'=#/'!.-!41'!='1#/>'2!/.,2#242!'?/>%2#='>@!.-!41'!1@0&3%>#/!>#,'2!A3,0! 41'#&!/.,4',42B!C'4D'',!41'!3/4%34#.,!0'=#/'!3,0!41'!D1''>!C&3E'2F!

5&3E'! -.&/'! 0#24&#C%4.&2! .&! '>'/4&.,#/3>>@! C32'0! C&3E'G/.,4&.>! /.<H.,',42! 3&'! ,.4! 3=3#>3C>'!-.&!41'!5+6!='1#/>'2F!

5'/3%2'! .-! 41'! 2<3>>!>',$412!41'! 4&3,2<#22#.,! 0'=#/'!#2! '?/>%2#='>@! C%#>0! D#41! &'#,G -.&/'0! 1.2'2! AIJ431>->'?>'#4%,$',IBF! K>41.%$1! 24''>! H#H'2! 13='! 3! 1#$1'&! /.<H&'22#='! 24#--,'22L! 1.D'='&L! 41'! >#,E2! 4.! 41'! ,'/'223&#>@! ->'?#C>'! H#H'2! #,! 41'! 3?>'! 3,0! D1''>! 3&'3!H&.=#0'!3,!300#4#.,3>!&#2E!.-!-3#>%&'F!;1'!H#H'2!3&'!3443/1'0!D#41!1.2'!/>3<H2!.,! 2%C-&3<'!.&!-&3<'!4%C'2L!!"#$%&'!()F!

!"#"# 2%&3.,546*-,

;1'!/.<H.,',42!%2'0!#,!41'!5+6G='1#/>'2!3&'!<.24>@!C32'0!.,!41'!<.4.&/@/>'!4'/1G ,.>.$@F!;1'!'>324.<'&2!.-!41'!/.<H.,',42!3&'!0'2#$,'0!-&.<!41'!<3,%-3/4%&'&!-.&!41'! %2'!.-!H.>@$>@/.>'41'&F!!

!"#$ | %%&%'($&)'*+),'-.),/$Æ$0123.4-52$

!"#$%#$&"#'()'*+,-.'/01#23/.0-*'0340&"4(*-.(0("0.3#3&"4'0"*0534'*-#0"3#.0#'..0&"56*'..3+ ,#'70."0()-(0()'0.(3114'..0"10()'0,*-8'0.$.('503.06".3(39'#$0341#2'4&'/:0;4"()'*0356"*+ (-4(0 &*3('*3"403.0 ()'0 ('56'*-(2*'0 .(-,3#3($0 "10 ()'0 ,*-8'0 1#23/:0 <*39'40 ,$0 ()'0 -350 ("0 .-9'0-.052&)0(3*'0.2.6'4/'/05-..0"10()'0,*-8'0.$.('50-.06"..3,#'0-(0()'0=)''#.70"4#$0 -0#353('/06"('4(3-#01"*0.("*-%'0"10,*-834%0)'-(03.0-9-3#-,#'70."0-,"9'+-9'*-%'0('56'*-+ (2*'.0 &-40 ,'0 -&)3'9'/:0 >"/'*40 #3?23/.0 ,-.'/0 "40 6"#$%#$&"#'()'*0 "11'*0 )3%)0 ,"3#34%0 6"34(.0()-(0'@&''/.0'9'40()'0.6'&313&-(3"40-&&"*/34%0("0<AB0C0D':%:0E-.(*"#F0GHIJ:0

!"# $%&&'()*+,&-(

K(03.0 2.'12#0 ("0 &"553(0 ()'0 425,'*0 "10 63.("4.0 -4/0 ()'0 63.("40 /3-5'('*0 "10 ()'0 ,*-8'0 &-#36'*.0,'1"*'06#-4434%0()'0,*-8'0/3.&70,'&-2.'0()'0/3.&.0)-9'0-0)2%'0/'.3%406"('4(3-#0 340 ('*5.0 "10 /3-5'('*70 ()3&84'..0 -4/0 34.(-##-(3"4:0 ;40 356"*(-4(0 6-*-5'('*0 3.0 ()'0 )'3%)(0 "10 ()'0 ,*-8'0 6-/70 =)3&)70 (-834%0 34("0 -&&"24(0 ()'0 6-/0 6*'..2*'70 -11'&(.0 ()'0 #'4%()0"10()'06-/0-4/0()2.0()'0425,'*0"10,*-8'063.("4.:0B)'05'-401*3&(3"40*-/32.0"10 ()'0/3.&03.01-9"*'/0,$0-0#"=0)'3%)(0"10()'06-/:0B)'0(-4%'4(3-#01"*&'0"40()'0/3.&0-&(.0 "40-0*-/3-#0.2*1-&'70#353('/0,$0()'0"2('*0*-/32.0*-0-4/0()'0344'*0*-/32.0*3 0"10()'0,*-8'0
6-/01*3&(3"40*34%:0

I"*0()'05'-401*3&(3"40*-/32.03.09-#3/L0

| M | M
- 3
N | O | O
- 3

* *
*P
* *
| DQ?:0OCJ

B)'0*'?23*'/0("(-#0,*-8'063.("40-*'-0"10()'0,*-8'0;R70N0/'6'4/.0"40()'0,*-8'06*'..2*'0 "10 ()'0 *'.6'&(39'0 ,*-8'0 &3*&23(0 D6DSTOJJ70 ()'0 ,*-8'0 &)-*-&('*3.(3&0 EU70 ()'0 -&)3'9-,#'0 ,*-834%0 1"*&'0340 ()'0 (3*'V.0 &"4(-&(0 6#-('0 "10 ()'0 -66*"6*3-('0 -@3.0IN7D9T)J70 ()'0 /$4-53&0 (3*'0*"##34%0*-/32.0*/$40-4/0()'05'-401*3&(3"40*-/32.0"10()'0,*-8'0#3434%0*N:0

N7 9 T )
/$4
R7N | U
STO | N
I | *
; | P
6 | E | * ÷ ÷ | DQ?:0OWJ

!"#$%&'(&)'*+&#,-.*,$+&'+/',0"'1-(2"'#3#,"4#'/+-',0"'⁵6+-4.7('8,.)"&,⁵9':(*$&%';(-#' | <=>

!"#$%&'(&)"*"&+,&*-%&.-%%$&#/"0%1&234567869:&

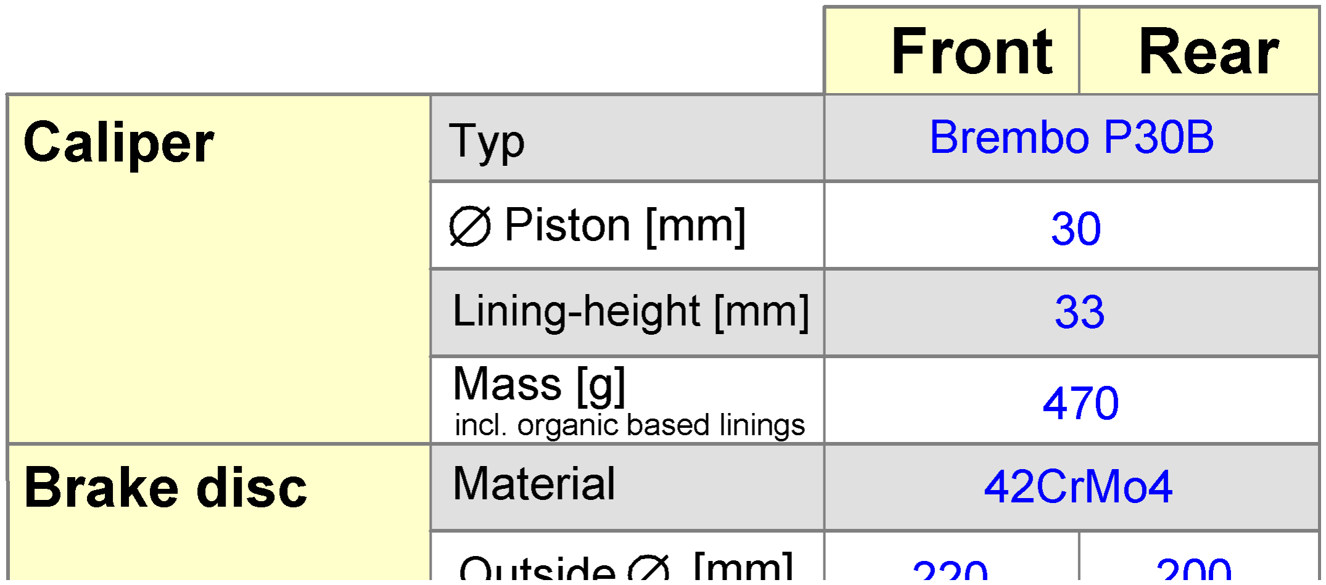
[picture p88: figure]

!-%&/%;<=/%>&?<@#%/&+,&A=1*+?1&B"?&#%&"11%11%>&=?&B+?C<?B*=+?&.=*-&"&>%1=/%>&,/=B*=+?& /=?D& +?& *-%&>=1BE& *"0=?D&=?*+& "BB+<?*& *-%&A%/@=11=#$%& 1A%B=,=B& 1</,"B%&A/%11</%& +,& *-%& #/"0%&A">&"?>&*-%&/%$"*%>&1</,"B%&>=@%?1=+?F&&

G+/& +/D"?=B& ,/=B*=+?& @"*%/="$& *-%& 1</,"B%& A/%11</%& 1-+<$>& ?+*& %HB%%>& *-%& I"$<%& +,& J'&K8@@'
F&!-%&B"$=A%/1&"?>&A">1&"/%&=>%?*=B"$&=?&#+*-&I%-=B$%1&+?&*-%&,/+?*&"?>&/%"/& "H$%1F&!"#$%&'&1<@@"/=L%1&*-%&>"*"&,/+@&*-%&B"$=A%/&"?>&*-%&#/"0%&>=1BF&

!"#"$ %&'()*+,

3/"0%&B"$=A%/1& ,+/& ,+/@<$"&B"/1&@<1*&#%&>%1=D?%>& "1&$=D-*&.=D-*& "1&A+11=#$%& "?>&M%*& I%/M& 1*=,,& 2I+$<@%& B"A"B=*M:F& G+/& /"B=?D& ,=H%>& B"$=A%/& #/"0%1& "/%& A/%,%/"#$M& <1%>F& !-%1%&-"I%&"&$+.&I+$<@%&B"A"B=*M&"?>&B"?&#%&>%1=D?%>&$=D-*N.%=D-*F&)<%&*+&*-%&-=D-& 1*=,,?%11&+,&*-%&,=H%>&B"$=A%/1&*-%M&-"I%&"&I%/M&%I%?&#/"0%&A">&.%"/&#%-"I=+/F&)<%&*+& -=D-&#%?>=?D&@+@%?*1& +?& *-%&#/=>D%& +,& ,=1*&B"$=A%/1&=*&@<1*&#%&@">%&I%/M&@"11=I%F& O1<"$$M&@+*+/BMB$%&,=1*&B"$=A%/1&-"I%&*-%/%,+/%&"&-=D-%/&@"11&*-"?&,=H%>&B"$=A%/1&.=*-& *-%& 1"@%& A%/,+/@"?B%F&3%B"<1%& +,& *-%&@"11=I%& ,=1*& B"$=A%/& #/=>D%& *-%& ,/=B*=+?& /">=<1& @<1*&"$1+&#%&/%><B%>&+,& ,+/&"&D=I%?&/=@&B$%"/"?B%F&3"1=B"$$ME&*.+NA=1*+?&B"$=A%/1&"/%& 1<,,=B=%?*&.=*-&=*1& #/"0%& ,+/B%&$%I%$& ,+/& *-%& PG+/@<$"& Q*<>%?*P& I%-=B$%1F& R,& *-%& -=D-%/& @"11&+,&@<$*=&A=1*+?&&,=H%>&B"$=A%/1&2SE&TE&7&A=1*+?:&B"?&#%&"BB%A*%>E&*-=1&+,,%/1&#%?%N ,=*1& +,&$+?D%/& #/"0%&$=?=?D1& +?& *-%& ,/+?*& "H$%F&3M& /%><B=?D& *-%& -=D-*1& +,& *-%& ,/=B*=+?& "/%"&"1&"&/%1<$*&+,&*-%&$+?D%/&#/"0%&$=?=?D&#/"0%&>=1B1&.=*-&"&1@"$$%/&>="@%*%/&B"?&#%& >/=I%?F&Q=?B%&.=*-&@<$*=&A=1*+?&B"$=A%/1&*-%&A=1*+?&"/%"&=?&D%?%/"$&=1&D/%"*%/&*-"?&.=*-& 'NA=1*+?&B"$=A%/1E&*-%&#/"0%&A/%11</%&B"?&#%&/%><B%>F&U$1+E&*-%&*=$*N@+@%?*&+,&*-%&$=?N

!"#$ | %%&%'($&)'*+),'-.),/$Æ$0123.4-52$

!"#$%&'()*+%,-% ./*% 01!&.!2"% 021&*% '&.!"#% 0123% ./*%4*5*1% 20% ./*%4!"!"#% ./!&6"*))% '.% ./*% 7'+% ,'&6% 74'.*$% &'"% ,*% &237*")'.*+% ,-% ./*% ()*% 20% +!00*1*".% 7!).2"% +!'3*.*1)%!")!+*% ./*%3(4.!%7!).2"%&'4!7*1)8%92:*5*1%("!0213%)(10'&*%71*))(1*%&'"%'4)2%,*%1*'&/*+%:!./% /!#/;<('4!.-%.:2;7!).2"% 0!=*+%&'4!7*1)%:!./%#(!+*+%,1'6*%7!).2")8%>/*%:/**4%,1'6*%20% ./*% 1*'1% '=4*% 20% ./*% ?@ABC% )/2:)%D!#(1*% EE8% F"%D!#(1*% EG$% ./*% 012".% '=4*% ,1'6*% 20% ?@ABC%')%()*+%+(1!"#%1'&!"#%!)%)/2:"8%

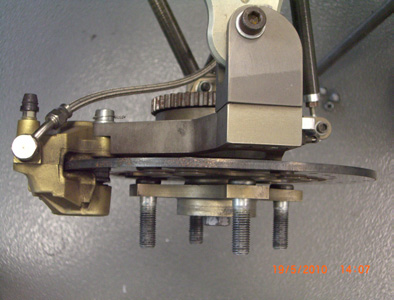
[picture p89: figure]

D!#(1*%EGH% D12".%'=4*%,1'6*%?@ABC%

!"#$%&'(&)'*+&#,-.*,$+&'+/',0"'1-(2"'#3#,"4#'/+-',0"'⁵6+-4.7('8,.)"&,⁵9':(*$&%';(-#' | <=>

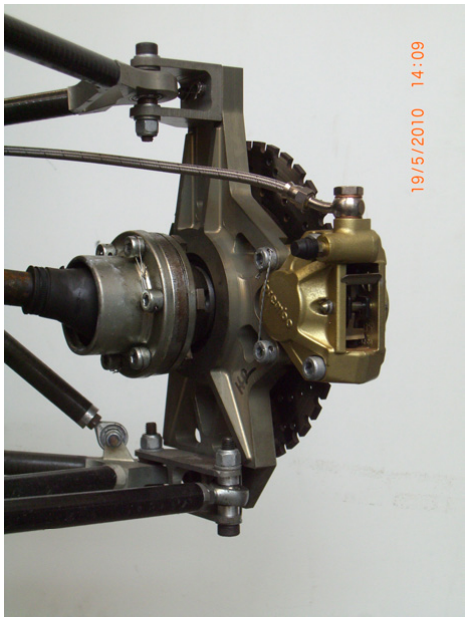
[picture p90: figure]

"#$%&'!(()! *'+&!+,-'!.&+/'!0*123!

45'!6'5#7-'8!0*129:23!+&'!';%#<<'=!>#?5!?>@A<#8?@B!C#,'=!7+-#<'&8!DEF20G!>#?5!+! <#8?@B!=#+H'?'&!@C!F2!HH!@C!?5'!H+B%C+7?%&'&!0&'H.@IJ!!+,#+--K!H@%B?'=!@B!?5'! >5''-!7+&&#'&L!

!"#"$ %&'&'()*

"@&!75@@8#B$!?5'!.&+/'!<+=8!#?!H%8?!C#&8?!.'!='7#='=!#B!<&#B7#<-'!?@!%8'!8#B?'&'=!H'A ?+--#7!.&+/'!-#B#B$8!@&!@&$+B#7!.+8'=!-#B#B$8!#B!7@BM%B7?#@B!>#?5!H'?+--#7!.&+/'!=#878L! "@&! @&$+B#7! .+8'=!-#B#B$8J! ?5'! @<'&+?#B$! ?'H<'&+?%&'!#8! $'B'&+--K!#B! ?5'! &+B$'! F22A N22O!1J!#?!H%8?!.'!7+-7%-+?'=!>#?5!+B!#B7&'+8'=!>'+&!+?!+!8?'+=KA?'H<'&+?%&'!@C!+<A <&@,#H+?'-K! (22OL!45'! C&#7?#@B! 7@'CC#7#'B?! @C!@&$+B#7! .+8'=!-#B#B$8!#8!#B! ?5'! &+B$'! @C! 2LF! ?@! 2LPL! Q#B?'&'=! .&+/'!-#B#B$8! 7+B! .'! =&#6'B! +?! 5#$5'&! ?'H<'&+?%&'8! +B=! 5+6'! +! H@&'! '6'B! C&#7?#@B! $&+=#'B?! @B! ?5'! ?'H<'&+?%&'L! 45'! C&#7?#@B! 7@'CC#7#'B?! @C! 8#B?'&'=! -#B#B$8!#8!#B!?5'!&+B$'!C&@H!2LN!?@!2LRL!S8<'7#+--K!?5'!7@-=!C&#7?#@B!7@'CC#7#'B?!#8!5#$5'&!

!"#$ | %%&%'($&)'*+),'-.),/$Æ$0123.4-52$

!"#$%&'()!*%"#+%#%),("!$#-(*./#0!"!",*1#23.).-4#(#3!,3.)#-)(5!",#'.)6%)&("$.#!"#+3.# !"!+!(0#'3(*.#%6#+3.#-)(5!",#')%$.**#$("#-.#($3!.7./#8!+3#*!"+.)./#0!"!",*9#*%#+3(+#+3!*# !*#-.++.)#*:!+./##+3("#%),("!$#-(*./#&(+.)!(0*#.*'.$!(004#6%)#+3.#3("/0!",#$%:)*.#%6#+3.# ;<%)&:0(# =+:/."+;1# >%8.7.)9# *!"+.)./# 0!"!",*# $).(+.# (# 3!,3# 8.()# (+# +3.# -)(5.# /!*$1# 23.# 3!,3# +3.)&(0# $%"/:$+!7!+4# %6# -)(5.# '(/*# 8!+3# *!"+.)./# 0!"!",*# (0*%# 3(7.# 3!,3# +3.)&(0#).?:!).&."+*#%"#+3.#-)(5.#60:!/1#

<%)# +3.# :*./# $(0!'.)*# @ABCDE# D).&-%FG# !"# +3.# DHICJ# ("/# DHICK# *!"+.)./# 0!"!",*# 8!+3#(#&(+.)!(0#&!L!",#=H#@=MHG#().#%66.)./#6)%&#2HNF#1#O"#+3.#$%&'.+!+!%"#:"+!0# "%8#%),("!$#-(*./#0!"!",*#8!+3#(#3!,3#%6#BB#&&#3(7.#-.."#:*./1#23.#:*.#%6#*!"+.)./# 0!"!",*#!*#("#%'+!%"#6%)#6:+:).#%'+!&!P(+!%"#*+.'*1#

!"#"# $%&'()*+,-,)

23.# -)(5.# /!*$# %66.)*# .L+."*!7.# %''%)+:"!+!.*# 6%)# +3.# %'+!&!P(+!%"# %6# +3.# -)(5.# *4*Q +.&1#R%).%7.)# 6)%&# (00# '()+*# %6# +3.# -)(5.# *4*+.&# +3.# -)(5.# /!*$#!*# +3.# $%&'%"."+# +3(+#$("#-.#.(*!.*+#("/#$3.('.*+#*.06Q&(/.9#-.$(:*.#("#!"+.)"(0#$%%0!",#%6#+3.#-)(5.# /!*$#!*#"%+#".$.**()41#

2(-0.#BS#D)(5.#/!*$#/.*!,"#'()(&.+.)*#

2(-0.#B#,!7.*#("#%7.)7!.8#%6#+3.#/.*!,"#'()(&.+.)*#%6#+3.#-)(5.#/!*$1##

T1B1B1U R%:"+!",#

V"#+3.#/)!7."#(L0.#@:*:(004#+3.#).()#(L0.G#&%:"+!",#%6#+3.#-)(5.*#%"#+3.#$3(**!*#3(*# +%#-.# +.*+./# +%# 5..'# +3.# +!).# *:*'."/./#&(**# (+# +3.#83..0# (*#0%8# (*#'%**!-0.1#N!+3# +3.#7.3!$0.*#DHICJWCK#+3.#-)(5.#/!*$*#().#&%:"+./#%"#+3.#83..0#$())!.)9#-.$(:*.#+3.# *'($.#!*#7.)4#0!&!+./#(+#+3.#/!66.)."+!(01#N!+3#(#7!.8#+%#+!).#*:*'."/./#&(**#+3.#-)(5.# /!*$# &(**# 3(*# ("# ('')%')!(+.# 3!,3# ')!%)!+41# >."$.# !+# 6%00%8*# +3.# "../# 6%)# !&')%7.Q

!"#$%&'(&)'*+&#,-.*,$+&'+/',0"'1-(2"'#3#,"4#'/+-',0"'⁵6+-4.7('8,.)"&,⁵9':(*$&%';(-#' | <=>

!"#$%&'"()'*+#(&$,"&,")$&-).)-+$/&)#*&%$'0-$0')1&%$'"#($,&)%&)&20#-$+3#&32&4')5"&!)6 $"'+)1&7&

8#)13(&$3&$,"&*+%-&4')5"&)*).$+3#&3#&!3$3'-/-1"%&+%&)&2+9"*&3'&213)$+#(&+#%$)11)$+3#&32& $,"&4')5"&*+%-& $3& $,"&:,""1&-)''+"'& 2")%+41"7&8& 213)$+#(&!30#$+#(& 32& $,"&4')5"&*+%5;%& 2'+-$+3#&'+#(&)#*&$,"&*+%-;%&+##"'&'+#(<&:,+-,&+%&0%"*& 23'&$,"&)*).$)$+3#&$3&$,"&:,""1& ,04<&,)%& $,"& )*=)#$)("& $,)$& $,"&"9.)#%+3#& 32& $,"& 2'+-$+3#& '+#(&:+11&4"&1"%%&,+#*"'"*& $,)#& $,"& 3#"& 32& )& 2+9"*&!30#$"*& 4')5"& *+%-7&>,0%& $,"& %,+"1*+#(& 32& $,"& 2'+-$+3#& '+#(& 0#*"'&,+(,&$"!."')$0'"%&)#*&$,"&$,'")$&32&."'!)#"#$&*+%$3'$+3#&+%&!+#+!+?"*7&

@3:"="'<&:+$,&)&213)$+#(&+#%$)11)$+3#&')$$1+#(&#3+%"%&-)#&4"&3--0'&:,+1"&*'+=+#(7&>,+%& #3+%"&+%&)=3+*"*&4/&0%+#(&)&;%"!+;&213)$+#(&+#%$)11)$+3#&0%+#(&213)$"'%<&:,+-,&("#"')$"&)& .'"13)*& 4/& !")#%& 32& $,"& +#%$)11)$+3#& 32& )**+$+3#)1& -3''0()$"*& :)%,"'%& 4"$:""#& $,"& 4')5"& *+%-& )#*& $,"& & 21)#("<&A+(0'"& BC7&81$,30(,& $,"& 0%"& 32& 213)$+#(& 4')5"& *+%-%& ,)%& !3'"&*"%+(#&)#*&!)#02)-$0'+#(&-3!.1"9+$/<&$,'30(,&$,"&0%"&32&)10!+#0!&23'&$,"&+#6 #"'&'+#(&32&$,"&4')5"&*+%-&,3:"="'&$,"&!)%%&32&$,"&213)$+#(&!30#$"*&4')5"&*+%-&-)#&4"& '"*0-"*&-3!.)'"*&:+$,&$,"&2+9"*&!30#$"*&*+%57&

A+(0'"&BCD& A13)$"'&EFG&

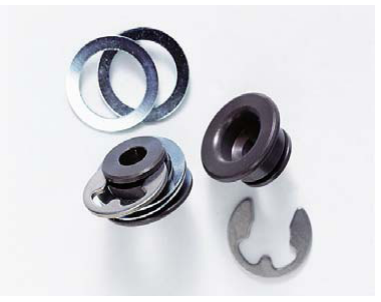
[picture p91: figure]

H7C7C7B I)$"'+)1%&)#*&*+!"#%+3#%&

>,"&*+!"#%+3#%&32&$,"&4')5"&*+%-&J'3$3'K&:+11&4"&&*"$"'!+#"*&4/&&$,"&%"1"-$+3#&32&$,"& !)$"'+)17&8%&)&"-3#3!+-)1&!)$"'+)1&23'&$,"&4')5"&*+%-&)10!+#0!&3'&%$""1&-)#&4"&0%"*7& L')5"& *+%-%&!)*"& 32& -)'43#& 2+4"'& -3!.3%+$"%& )'"& 32$"#&*'+="#&+#& ')-+#(<&40$& 23'& $,"& '30$"&)#*&*'+=+#(&.'32+1"&+#&$,"&;A3'!01)&M$0*"#$;&$,+%&+%&#3$&%0+$)41"&4"-)0%"&32&$,"& 13:&-31*&2'+-$+3#&-3"22+-+"#$&)#*&,+(,&.'3*0-$+3#&-3%$%7&

L')5"&*+%-%&32&')-+#(&=",+-1"%&)'"&32$"#&.'3=+*"*&:+$,&,31"%&3'&('33="%7&>,"&('33="%& 3'&,31"%&)'"&#3$&+#$"#*"*&$3&-331&$,"&4')5"&*+%-<&40$&-1")#&$,"&%0'2)-"%7&L/&$,"&"1)%6 $+-+$/&32&$,"&1+#+#(&+$&:+11&4"&.0%,"*&+#$3&$,"&'"-"%%&*0'+#(&%1+.&3="'&)#*&:")'&30$&*0'6

!"!# | $$%$&'#%(&)*(+&,-(+.#Æ#/012-3,41#

!"#$%&'&()&*$+,&%&-.$/!0,$1&%23%(0&4$3%$#%335&4$-%(6&$4!)7)$("$!"7%&()&4$/&(%$32$0,&$ '!"!"#)$3778%9$,3/&5&%9$0,&$73"0(70$1(00&%"$32$0,&$'!"!"#$("4$0,&$4!)7$!)$:3%&$8"!23%:$ ("4$)73%!"#$7("$-&$1%&5&"0&4*$;:13%0("0$!)$0,&$8"!23%:$(%%("#&:&"0$32$0,&$<"&#(0!5&$ 13%0!3")<*$ ;"$ 0,&$ (%%("#&:&"0$ 32$ ,3'&)$!"$0,&$ -%(6&$ 4!)69$ 0,&$:808('$ 35&%'(1$ 32$ 0,&$ ,3'&)$3"$0,&$3%-!0)$32$0,&$'!"!"#=(%&($!)$!:13%0("0*$>)$0,&$73(0!"#$!)$)'!11&4$35&%$(0$ &(7,$13!"0$32$0,&$1&%23%(0!3"$0,&$23%:(0!3"$32$%!11'&)$0,%38#,$0,&$1&%23%(0!3")$/!''$-&$ (53!4&4*$$

+,&$ 8)&$ 32$ )'30)$ #&"&%(''.$ $ "30$ ,(5&$ 0,!)$ 1%3-'&:*$ +,&$ "&#(0!5&$ 13%0!3"$ /,!7,$ /!''$ )'!11&4$35&%$2%3:$0,&$'!"!"#$),38'4$-&$&?8('$0,%38#,380$0,&$&@0&"0$32$0,&$-%(6&$4!)7*$ +,&%&-.$-%(6&$A844&%$("4$($"3!)&$#&"&%(0!3"$!)$)811%&))&4*$+,&$%&)8'0!"#$"307,$("4$ 0,&%:('$)0%&))&)$48%!"#$31&%(0!3"$(%&$%&'&5("0$03$0,&$2(0!#8&$)0%&"#0,$23%$0,&$<B3%:8'($ C084&"0<$73:1&0!0!3"9$,3/&5&%9$0,&$53'8:&$32$:(0&%!('$03$(-)3%-$0,&$-%(6!"#$&"&%#.$ )0("4)$)3'&'.$!"$0,&$23%&#%38"4*$

D)1&7!(''.$ /,&"$ 4!:&")!3"!"#$ 0,&$ %&(%$ -%(6&$ 4!)79$ ($ 4&0(!'&4$ )0%&))$ ("('.)!)$ !)$ %&= ?8!%&4*$ E&7(8)&$ 32$ 0,&$ '3/$ ,&(0$ !"180$ 48&$03$ '3/&%$ -%(6!"#$ 23%7&)9$ 0,&$ %&(%$ -%(6&$ 4!)7)$(%&$:(4&$0,&3%&0!7(''.$5&%.$0,!"*$

>$7%!0!7('$'3(4$7()&$3778%)9$,3/&5&%9$!2$0,&$5&,!7'&$:35&)$-(76/(%4$(20&%$($F)1!"F$/!0,$ !"7%&()&4$)1&&4$("4$0,&$4%!5&%$1%&))&)$0,&$-%(6&$1&4('$/!0,$28''$23%7&*$>)$0,&$%&)8'0$32$ 0,&$4."(:!7$ (@'&$'3(4$ 03$ 0,&$ %&(%$/,&&')$("4$ 0,&$1%3487&4$,!#,$-%(6&$ 23%7&$ (0$ 0,&$ -%(6&)$0,!)$7("$'&(4$03$-876'!"#$32$0,&$2%!70!3"$%!"#$3%$0&(%!"#$32$0,&$2'3(0&%)*$

+,&$:())&)$ 32$ 0,&$ 2%!70!3"$ %!"#)$ 32$ 2%3"0$ ("4$ %&(%$ (@'&$:8)0$ -&$ ('!#"&4$ )3$ 0,(0$ 0,&$ 0&:1&%(08%&$ #%(4!&"0)$ 48%!"#$ 31&%(0!3"$ (%&$ )!:!'(%*$ +,!)$ 4&:("4$ (%!)&)$ 2%3:$ 0,&$ 0&:1&%(08%&$4&1&"4&"7&$32$0,&$ 2%!70!3"$73&22!7!&"0$32$0,&$'!"!"#)*$;29$ 23%$&@(:1'&9$0,&$ -%(6&$ 0&:1&%(08%&$ (0$ 0,&$ %&(%$ (@'&$!)$ (0$ ($'3/&%$'&5&'9$/!0,$!"7%&()!"#$ 0&:1&%(08%&$ 4!22&%&"7&$ 73:1(%&4$ 03$ 0,&$ 2%3"0$ (@'&$ -%(6&$ 1&%23%:("7&$!)$ #!5&"$ (/(.$ -&7(8)&$ 0,&$ 2%!70!3"$73&22!7!&"0$32$0,&$'!"!"#)$(7,!&5&4$(0$0,&$2%3"0$(@'&$($,!#,&%$'&5&'$0,("$(0$0,&$ %&(%$(@'&*$

G3%&$4("#&%38)$!)$("$!"7%&()&$32$0,&$2%!70!3"$73&22!7!&"0$(0$0,&$%&(%$(@'&*$;2$0,&$2%!70!3"$ 73&22!7!&"0$3"$0,&$%&(%$-%(6&$!"7%&()&)$(0$($%!)!"#$0&:1&%(08%&$ 2()0&%$0,("$0,&$73&22!= 7!&"0$3"$0,&$2%3"0$-%(6&9$0,!)$7("$%&5&%)&$0,&$'376!"#$3%4&%$("4$0,&$-%(6!"#$-&,(5!38%$ 32$0,&$5&,!7'&$!)$8")0(-'&*$

B3%$0,&$%&4870!3"$32$73:13"&"0)$("4$/&!#,09$!0$:(6&)$)&")&$03$8)&$0,&$-%(6&$4!)7$(0$ 0,&$)(:&$0!:&$()$)1&&4$)&")3%$/,&&'$23%$($0%(70!3"$73"0%3'$).)0&:$("4$03$&?8!1$0,&:$

!"#$%&'(&)'*+&#,-.*,$+&'+/',0"'1-(2"'#3#,"4#'/+-',0"'⁵6+-4.7('8,.)"&,⁵9':(*$&%';(-#' | <=>

!"#$% $&'()% &*% +*&&,()-% .$")/% $&!(,(*/% *(01"*()% #$(% 1)(% &2% #(34(*5#1*(% )#56'(% )4((7% )(8)&*)-%

9-:-:-: ;(5'"<5#"&8%

.$(%2*"=#"&8%*"8+)%&2%#$(%>;?@AB@CD,($"='()/%358125=#1*(7%6E%3(58)%&2%'5)(*%=1#/%5*(% 357(%&2%9F?*G&9/%H"+1*(%F9-%I(*(%#$(%#$"=J8())%&2%#$(%*5!%35#(*"5'%!5)%=$&)(8%#&%6(% KDF%33%'5*+(*-%L2%8(=())5*E/%#$(%2*"=#"&8%*"8+%=58%6(%)#"''%$5*7(8%587%#(34(*/%61#%#$")% ")% 8&#%35875#&*E-% .$*&1+$% #$(% )16)(01(8#% +*"87"8+% 587% )#*5"+$#(8"8+% &2% #$(% 7")=)/% #$(%2"85'%2*"=#"&8%*"8+%#$"=J8())%587%*18&1#%")%357(/%H"+1*(%FM-%

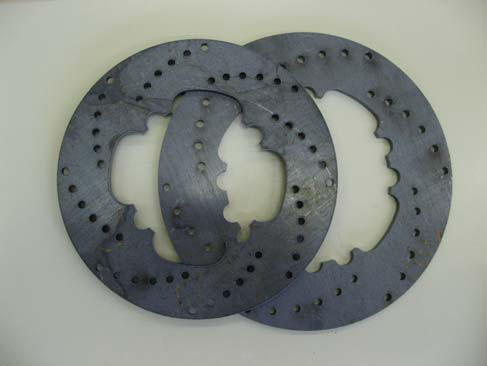
[picture p92: figure]

H"+1*(%F9N% H*"=#"&8%*"8+%=1##(7%>;?@A%OPQ%

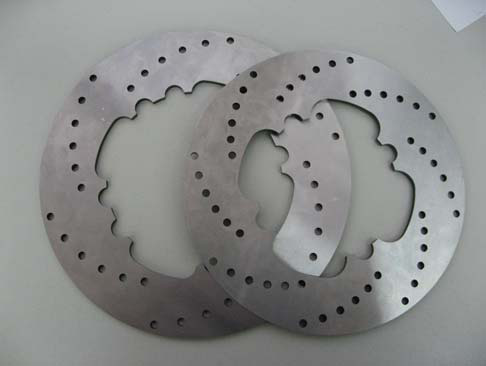
[picture p93: figure]

H"+1*(%FMN% H*"=#"&8%*"8+%+*"87(7%>;?@A%OPQ%

L8% 577"#"&8% #&% #$(% 2*"=#"&8% *"8+% #$"=J8())% #$(% "8#(+*5#"&8% &2% #$(% "88(*% *"8+% "8#&% #$(% !$(('% $16% &22(*)% 21*#$(*% 4&#(8#"5'% 2&*% !("+$#% *(71=#"&8-%R"#$% #$(% 3&18#"8+% &2% #$(% 6*5J(%7")=S)% 2*"=#"&8%*"8+%6E%3(58)%&2% 2'&5#(*)%5''%)=*(!%=&88(=#"&8%!"''%6(%()=54(/%)&%

!""# | $$%$&'#%(&)*(+&,-(+.#Æ#/012-3,41#

!"#!$!"%$&'(!#)*%$+%!,%%)$!"%$-.#)/%$0-$!"%$1'2$#)&$,"%%.$*#)$+%$1%&3*%&4$50,$+%)&6 ')/$202%)!($')$!"%$7031)#.$0-$!"%$#8.%$#1%$!"%$1%(3.!(4$

9'/31%$:;$("0,($!"%$#&<#)!#/%03($')!%/1#!'0)$0-$!"%$+1#=%$&'(*>($'))%1$1')/$')!0$!"%$ ,"%%.$"3+$ 0)$ !"%$?@ABC4$D"%$&'#2%!%1$ 0-$ !"%$+1#=%$&'(*($ 0)$ !"%$ -10)!$ #8.%$ 0-$ !"%$ ?@ABC$ E$ ?@ABF$ '($ ::B$ 224$ G31')/$ 1#*')/H$ !"%$ +1#=%$ &'(*($ #!$ !"%$ -10)!$ 0-$ !"%$ ?@ABF$,%1%$'&%)!'*#.$!0$!"0(%$0-$!"%$?@ABC4$D"%$1%#1$+1#=%$&'(*($0-$+0!"$<%"'*.%($ "#<%$#$&'#2%!%1$0-$:BB$224$$

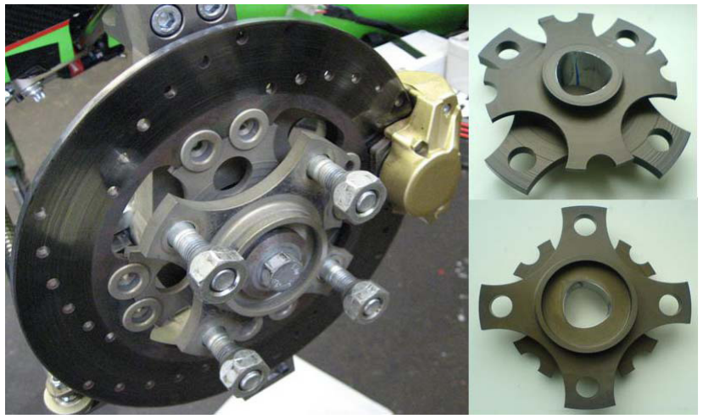
[picture p94: figure]

9'/31%$:;I$ J)!%/1#!'0)$0-$!"%$&'(=$'))%1$1')/$')!0$!"%$,"%%.$"3+$6$?@ABC$K;L$

!"#$%&'(&)'*+&#,-.*,$+&'+/',0"'1-(2"'#3#,"4#'/+-',0"'⁵6+-4.7('8,.)"&,⁵9':(*$&%';(-#' | <=>

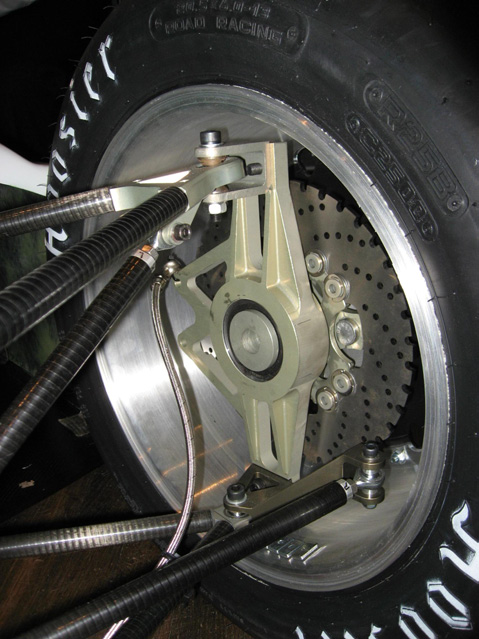
[picture p95: figure]

"#$%&'!()*! +,-'&./-#0'!1&/2'!3#45!6!7&8.-!/9,'!:;<=>!

"8&! -?'! :;<=>! /30/.5'3! 1&/2'! 3#454! @#-?! /!-88-?'3! 3#45! '3$'! /&'! /0/#,/1,'! @?#5?! 5/.!/,48!%4'3!/4!/!&8-8&!78&!4A''3!4'.4#.$!B4''!"#$%&'!((C!"#$%&'!()DE!F?'!3#454!8.!-?'! 7&8.-!/9,'4!87!18-?!0'?#5,'4!/&'!&%..#.$!@#-?!G!HH!-?#52.'44C!-8!-?'!&'/&C!'/5?!@#-?!I! HHE!

! "#$%&'(%)*+,-.%&'/'0+*'1)-

"8&! -?'! &'0#'@! 87! -?'&H/,! 1'?/0#8&! 87! -?'!1&/2'! 4J4-'HC! -'4-! &%.4!@'&'! 5/&&#'3! 8%-! @#-?!-?'!&/5'!5/&!:;<=KE!F?'!'9A'&#H'.-4!@'&'!5/&&#'3!-?&8%$?!8.!-?'!78&H'&!H#,#L -/&J!/#&A8&-!#.!MNO-'&18&$P+,-'4!Q/$'&ME!F?'!-'4-!58%&4'!58.4#4-'3!87!/!7,/-!/18%-!R==! H!,8.$!/.3!K=!H!@#3'!58.5&'-'!A,/-''3!A/-?E!

F?'! 4','5-'3! &8%-'! ?/3! .8@?'&'! 7,8@! 8%-! 87! -/&! /-! -?'!#.-'&4-#5'4! ! 87! -?'! A,/-'4! 8&! $&8@-?!87!$&/44C!"#$%&'!(KE!S%'!-8!,/52!87!&8/3!H/&2#.$4C!/!58.4-/.-!-&/5-#8.!8.!-?'!

!"#$ | %%&%'($&)'*+),'-.),/$Æ$0123.4-52$

!"#$%!&'"()**'#!+&#%,-.&/,0&!1(!-#!+2&3)%&+,#,&%!-)%+$"4&#5!&$6,4!&+$0(*,7&'"$#&879 :5%)"& ;&<=&>)4&/$#5&$"#!4%,#!+& +,#,&*)44!%& )?& #5!&$"0#%'6!"#&6,"'?,-#'%!%&@A8B& 05)/"&$"&&3$4'%!&CDB&/,0&'0!+2&&

E5!&+,#,&*)44!%&0#)%!0&#5!&+,#,&$"&,"&$"#!%",*& ?*,05&6!6)%72&F7&6!,"0&)?&(%)4%,69 6,G*!& ,",*)4& -5,""!*0& (%!00'%!& ,"+& #!6(!%,#'%!& 0!"0)%0& H#5!%6)-)'(*!0& ,"+& #!69 (!%,#'%!& %!0$0#,"-!IB& *$"!,%& ,"+& %)#,%7& ()#!"#$)6!#!%0B& *,6G+,& 0!"0)%0& ,"+& ,*,%6& >JKL0&-,"&G!&-)""!-#!+2&&

E5!& 0,6(*$"4& %,#!& -,"& G!& -)"?$4'%!+& ?%!!& ?)%& !,-5& -5,""!*2& M$#5& ,++$#$)",*& $"('#& -5,""!*&/5!!*&0!"0)%0&-,"&G!&-)""!-#!+&#)&#5!&N!*)-$#7&6!,0'%!6!"#2&A"#!%",*&0!"0)%0& ,**)/&#5!&+!#!-#$)"&)?&*)"4$#'+$",*&,"+&*,#!%,*&,--!*!%,#$)"2&E5!%!&$0&,*0)&#5!&()00$G$*9 $#7&#)&6!,0'%!&+,#,&)?&#5!&!"4$"!&-)"#%)*&:@O&G'02&

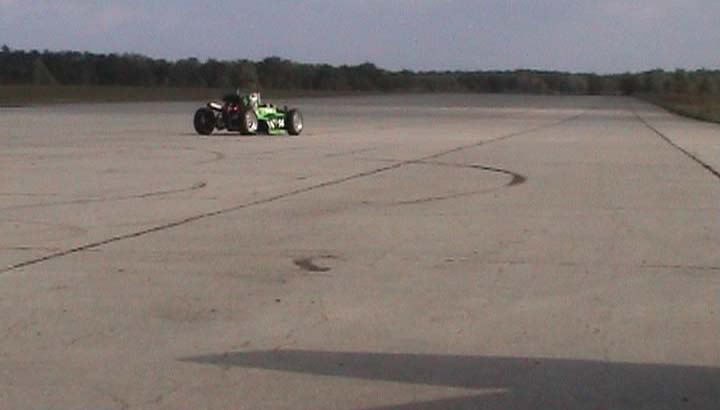
[picture p96: figure]

3$4'%!&CPQ& E!0#&,%!,&$"&RS#!%G)%4&T&@*#!0&>,4!%&UVW&

E5!& ?)-'0& )?& #5!& 6!,0'%!6!"#0& /,0& #5!& +!#!-#$)"& )?& G%,.!& +$0-0& #!6(!%,#'%!0B& G!9 -,'0!&#5!&G%,.$"4&?)%-!&+$0#%$G'#$)"&$0&$"?*'!"-!+&G7&#5!&#!6(!%,#'%!&+$??!%!"-!&)?&#5!& +$0-0&,0&,&%!0'*#&)?&#5!&#!6(!%,#'%!&+!(!"+$"4&?%$-#$)"&-)!??$-$!"#&)?&#5!&*$"$"402&

E5!& 5!,#$"4& )?& #5!& G%,.!& +$0-0&/!%!& %!,-5!+&/$#5& ,"&$"$#$,*& 0(!!+& )?& DX& .6T5&/$#5& ?'**&+!-!*!%,#!+&G%,.$"4&#)&,&0#)(&,0&$"+$N$+',*&,"+&0!Y'!"-!+&G%,.!&6,"!'N!%&/$#5&,& G%,.$"4&(!+,*&?)%-!&)?&CXZ9C[Z&O&H\'0#&G!*)/&#5!&G*)-.$"4&#5%!05)*+&)?&#5!&%!,%&,1*!I2&

!"#$%&'(&)'*+&#,-.*,$+&'+/',0"'1-(2"'#3#,"4#'/+-',0"'⁵6+-4.7('8,.)"&,⁵9':(*$&%';(-#' | <=>

!"#$ %#&'#()%*(#$ +,$ %"#$ -().#$ /0121$ 3)1$ (#2+(/#/$ 30%"$ 2+45#4%0+4)6$ 708(970$ 160'9 #6#&#4%1:$

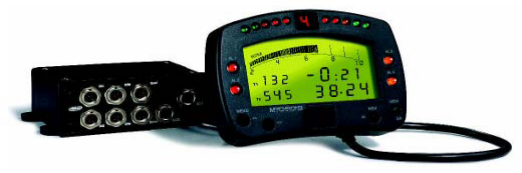
[picture p97: figure]

;0<*(#$=>?$ @AB8"(+4$C$DE$F+<$G>H$

!"#$&+*4%04<$+,$%"#$-().#$%#&'#()%*(#$1#41+($3)1$)-+*%$IJ$&&$04$(+%)%0+4)6$/0(#29 %0+4$-#"04/$%"#$+*%6#%$+,$%"#$-().#$/0121$,(+&$%"#$2)60'#(:$;+($%"01$%"#$1#41+($3)1$'+9 10%0+4#/$04$%"#$&0//6#$+,$%"#$,(02%0+4$1*(,)2#K$%).04<$04%+$)22+*4%$%"#$"+6#1$+,$%"#$/012K$ ;0<*(#$ CJK$!"#$ %#&'#()%*(#1$ +,$ %"#$ ,(+4%$ )4/$ (#)($ )L6#$3#(#$&#)1*(#/$ +4$ %"#$ (0<"%$ 10/#$+,$%"#$5#"026#:$

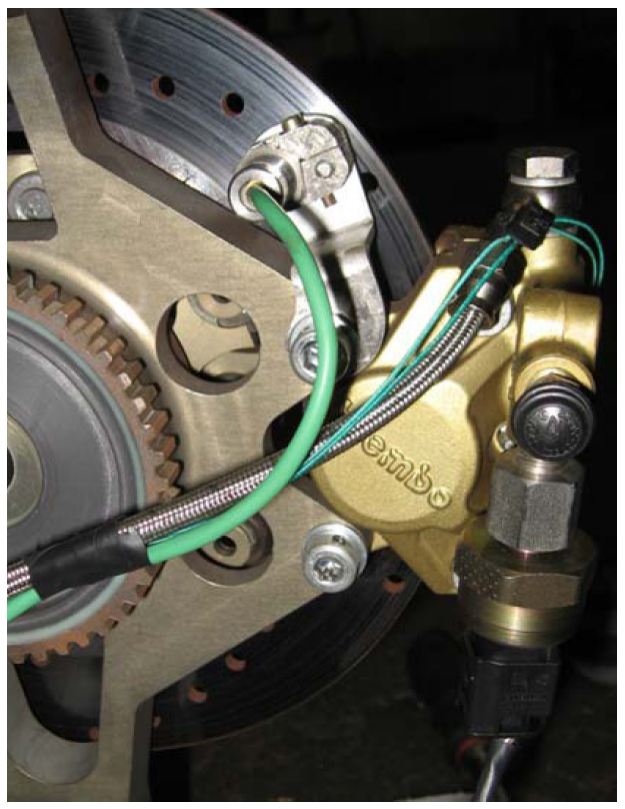
[picture p98: figure]

;0<*(#$CJ?$ A+*4%04<$+,$%"#$-().#$/012M1$%#&'#()%*(#$1#41+($)%$%"#$NO8JP$GQH$

!"#$ | %%&%'($&)'*+),'-.),/$Æ$0123.4-52$

!"#$%&"'()'*+"'#,"$-&.-/'"))"#*'()'*+"'0.&1'+(,"&'*+"'2"3)(3$*"0'43$1"'0.&#&'0('-(*'$,5 ,(6'$'2"37$-"-*'7"$&%3"7"-*'()'*+"')3.#*.(-'*"72"3$*%3"'$*'*+"'43$1"'2$0'48'7"$-&' ()'.-*"/3$*"0'*+"37(#(%2,"&'.-&.0"'*+"')3.#*.(-'&%3)$#"9'

!"&.0"&' *+"' *"72"3$*%3"&' $,&(' *+"' 43$1"' 2.2"523"&&%3"' 6"3"' .-#,%0"0' .-' *+"' ":2"3.5 7"-*$,';"3.).#$*.(-'()'*+"'43$1"')(3#"'0.&*3.4%*.(-9'

<$4,"' =' &+(6&' *+"'43$1"'0.&#' *"72"3$*%3"&' $*' *+"' )3(-*' $:,"' >*!?@;A' $-0' $*' *+"' 3"$3' $:,"'>*!?@+A@'$-0'*+"'3"&%,*.-/'*"72"3$*%3"'0.))"3"-#"'>$*A'$&'$' )%-#*.(-'()'*+"'-%75 4"3&'()'43$1.-/')(3'$'0.&*3.4%*.(-'()'BCD')3(-*'$:,"'$-0'EFD'3"$3'$:,"9'

<+"'3$*+"3',(6'*"72"3$*%3"&'()'*+"'43$1"'0.&#&'$)*"3'GH'43$1"&'&%//"&*&')%*%3"'2(&&.5 4.,.*."&')(3'$00.*.(-$,'*+"37$,,8'7(*.;$*"0'6"./+*'(2*.7.I$*.(-9'

<$4,"'=J' K(72$3.&(-'()'*+"'43$1"'0.&#'*"72"3$*%3"&'

L*'$' ).-"5*%-.-/'$,&('*+"'3"&2"#*.;"' )3.#*.(-'*"72"3$*%3"&'(-'*+"'43$1"',.-.-/'+$&'*(' 4"' *$1"-' .-*(' $##(%-*@' 6+.#+' 0.))"3@' 0"2"-0.-/' (-' *+"' *+"37$,' #(-0%#*.;.*8' ()' *+"' 43$1"',.-.-/'7$*"3.$,@'#(-&.0"3$4,8' )3(7'*+"'0.&1'*"72"3$*%3"9'M%"'*('*+"',(6'*+"35 7$,'#(-0%#*.;.*8'()'(3/$-.#' )3.#*.(-'7$*"3.$,'.*'#$-'4"'":2"#*"0'*+$*'*+.&',"$0&'*('$' +./+"3'*"72"3$*%3"'0.))"3"-#"'4"*6""-'*+"'&%3)$#"'()'*+"'43$1"'0.&#'$-0'*+"'&%3)$#"'()' *+"',.-.-/'$&'*+.&'6.,,'+$22"-'6.*+'&.-*"3"0')3.#*.(-'7$*"3.$,&9'

<$4,"' N' &+(6&' *+"' *"72"3$*%3"' 0.))"3"-#"' 4"*6""-' *+"' 43$1"' 0.&#' $-0' *+"' (3/$-.#' 4$&"0'43$1"',.-.-/'(-'*+"')3(-*'$:,"'()'*+"'!OKHF9'

<$4,"'NJ' K(72$3.&(-'()'43$1"'0.&#&'$-0'43$1"',.-.-/'*"72"3$*%3"'$*'*+"')3(-*'()'*+"' !OKHF'6+"-'%&.-/'$-'(3/$-.#'43$1"'2$0'PBQ'

!"#$%&'(&)'*+&#,-.*,$+&'+/',0"'1-(2"'#3#,"4#'/+-',0"'⁵6+-4.7('8,.)"&,⁵9':(*$&%';(-#' | <=>
! | "#$%&&'(

!"#$%&%'()*"+##,-%#./0%#0/.#12345#,-%#6./7%#898,%:#;/8#"%;'9#$%8*+"%$#/"$#*"0(.)(< ./,%$#*"#,-%#&%-*0'%#1234=#>(.#,-%#0(:)%,*,*("#;*,-#,-%#%?0%),*("#(>#,-%#.%/.#6./7%# $*808@#A,# ,-%# 8/:%# ,*:%# /# 0'(8%$# 6./7%# 0/'0B'/,*("#;/8#*",.($B0%$C# B8%$# /8# /# $(0B< :%",/,*("#(>#,-%#DE%8*+"#2%)(.,D#(>#,-%#DF(.:B'/#G,B$%",D#H%.:/"9@#

I-%#/"/'98*8#(>#,-%#0("$B0,%$#%?)%.*:%",/'#8,B$*%8#)(*",8#(B,#,-%#)(,%",*/'#>(.#>B,B.%# (),*:*J/,*("@#I-%#()%./,*"+#,%:)%./,B.%8#(>#,-%#6./7%#$*808C#)/.,*0B'/.'9#/,#,-%#.%/.# /?'%C#0/"#6%#>B.,-%.#*"0.%/8%$@#I-.(B+-#/"#%?0-/"+%#(>#,-%#(.+/"*0#6/8%$#6./7%#'*"*"+# :/,%.*/'#,(#8*",%.#:%,/'#6/8%$#'*"*"+8C#,-%#6./7*"+#)%.>(.:/"0%#(>#>B,B.%#&%-*0'%8#0/"# >B.,-%.#6%#%"-/"0%$@#

I(#/&(*$#/#:%0-/"*0/'#$%8,/6*'*J/,*("#(>#,-%#$*808#$B.*"+# >B.,-%.#;%*+-,#.%$B0,*("8C# >(.#%?/:)'%C#/#'/.+%.#"%+/,*&%#)/.,#69#:%/"8#(>#/"#*"0.%/8%#(>#,-%#)%.>(./,*("#*8#)(8< 8*6'%@#K*7%;*8%C#,-%#B8%#(>#'*+-,#:%,/'#,(#).($B0%#,-%#$*808#-/8#,(#6%#,.*%$#(B,@#

L(;%&%.C#$%8)*,%#/''#;*''#,(#(),*:*J%C#,-%#>(0B8#("#,-%#.(6B8,"%88#(>#,-%#898,%:#:B8,# "(,#6%#'(8,#6%0/B8%# +(($#)'/0%:%",8#*"# ,-%# DF(.:B'/#G,B$%",D#0(:)%,*,*("#0/"# ("'9# 6%#/0-*%&%$#;*,-#/#>/*'<8/>%#&%-*0'%@#

) | *+,+-+./+0(
MNO | PE!<FPI<Q/-.6B0-#R44=C#S/8#*8,#$*%#F(.:B'/#G,B$%",#H%.:/"9#TC#G@NUV#>>@C#
E%J%:6%.#R445C#EW88%'$(.>#
MRO | R4N4#F(.:B'/#GAX#2B'%8C#GAX#!",%."/,*("/'C#R44=#
MUO | 1*''C#Y@Z#[R44=\Z#G7.*),B:#JB.#P(.'%8B"+#1.%:8%",%0-"*7C#LIS<1%.'*"C#G,/"$#
R44=#

MVO 1.%B%.#]#1*''#[L.8+@C#R44^\Z#1.%:8%"-/"$6B0-C#U@#AB>'/+%C#F.*%$.*0-#P*%;%+#_# G(-"#P%.'/+]HSP#F/0-&%.'/+%#H:6LC#S*%86/$%"C#G%),%:6%.#R44^C#!G1`#U< 5UV5<44^V<U#

MaO 1B.07-/.$,#]#1B.+#[N=55\Z#1%.%0-"B"+#B"$#2%7("8,.B7,*("#$%8#1.%:8&%.-/'< ,%"8#&("#bYS@#Y*))%"-%*:Z#P%.'/+<!">(.:/,*("C#N=55#

M^O E/'':%.C#G,%>/"#[R445\Z#X",;*07'B"+#%*"%8#b.(+./::8#JB.#AB8'%+B"+#&("# 1.%:8/"'/+%"#>W.#F(.:%';/+%"#>W.#$*%#F(.:B'/#G,B$%",C#E*)'(:/.6%*,#/:# G,B$*%"+/"+#F/-.J%B+,%0-"*7#$%.#FLIS<1%.'*"C#`(&%:6%.#R445C#1%.'*"#

!"#$ | %%&%'($&)'*+),'-.),/$Æ$0123.4-52$
!"# | $%&'()*+,(-*./0.1233456.7')),89'):';<)*-0.=0.>?@A0.B*'(C8D')6.E*','9.F. $'?C)'%.E'%A89G.2334.
!4# | 67678$$H*):'%C'A89.+<)'.>IJG.$7B.KLM.>?(%N(:?)9.OPCQG.$';<)*(;<'(.R8S :')CA8::6.TUVSH7S23=QQ.1H7W5.
!X# | <::Y6ZZ,,,0P'SP+S:';0D'ZD'@8?A:08(Y[\]R^4_G./`V<%+)._.aO.TbO.:';<)*;8A. D+;?P'):8:*+)G.9'('<').8P6.2c0=302334.Z.=362c.
