salfordracing/SR-FS-17/2017 vehicle design/untitled.280.jpg

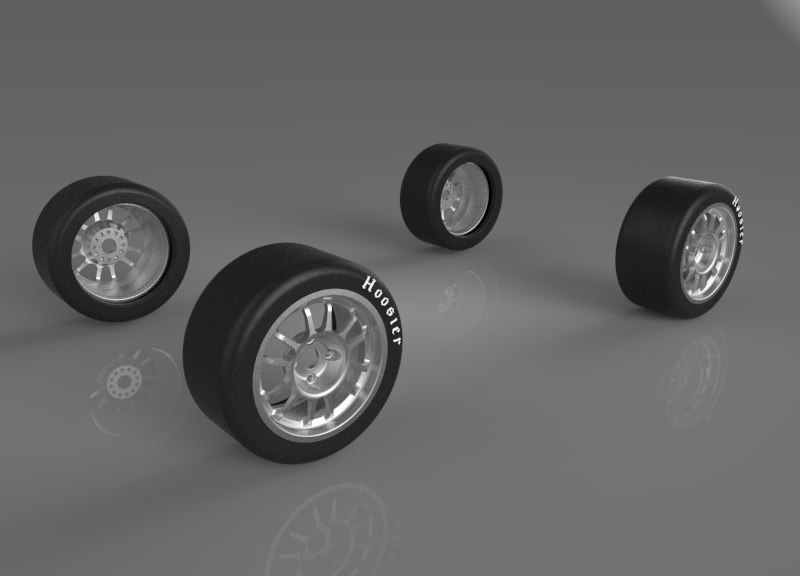
2017 vehicle design/untitled.280.jpg
