salfordracing/SR-FS-17/2017 vehicle design/untitled.282.jpg

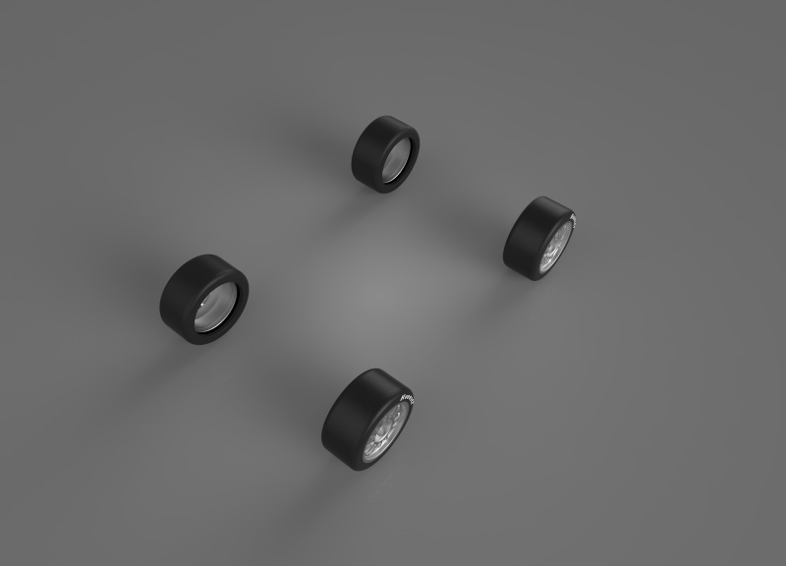
2017 vehicle design/untitled.282.jpg
