salfordracing/SR-FS-17/FS16/CAD/FS17-OT-IM19-01 chassis + wheels.jpg

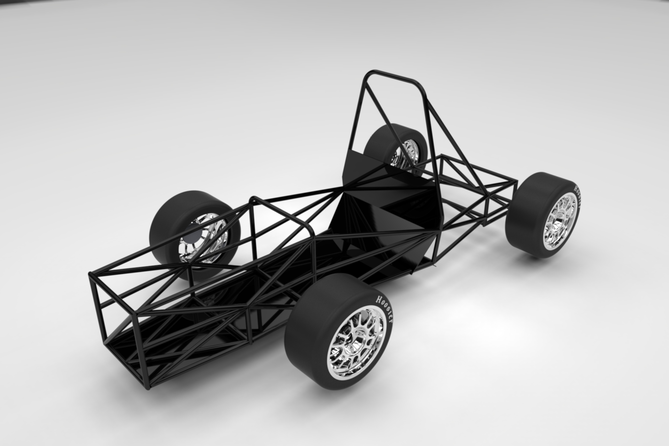
FS16/CAD/FS17-OT-IM19-01 chassis + wheels.jpg
