salfordracing/SR-FS-17/FS-17-0009-H Project Break Down Impact Attenuator/FS-17-0006 project items/impact attenuator renders/untitled.265.jpg

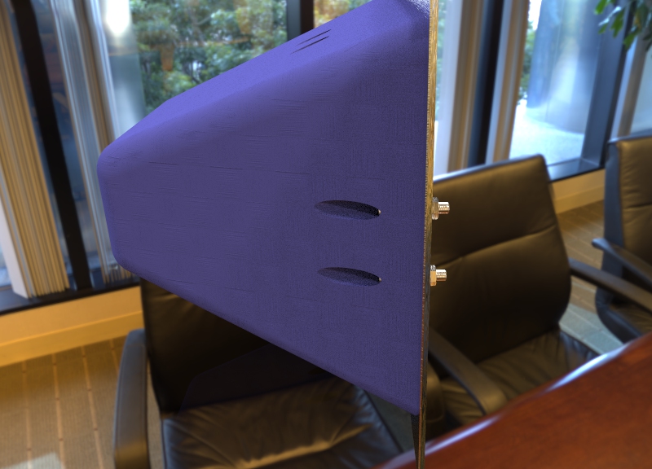
FS-17-0009-H Project Break Down Impact Attenuator/FS-17-0006 project items/impact attenuator renders/untitled.265.jpg
