salfordracing/SR-FS-17/FS-17-0012-H Braking system Design and integration/Research items/Copy of Brake Circuit.jpg

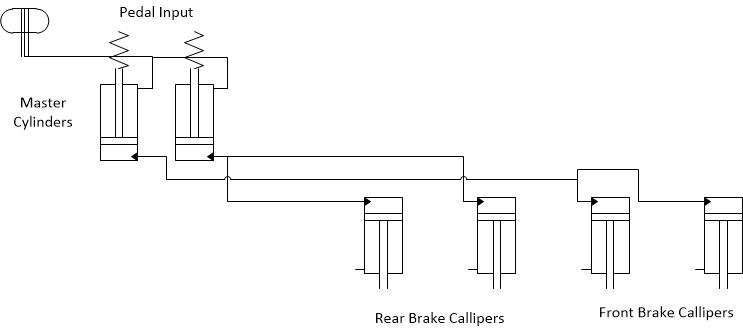
FS-17-0012-H Braking system Design and integration/Research items/Copy of Brake Circuit.jpg
