salfordracing/SR-FS-17/FS-17-0012-H Braking system Design and integration/Rules/FSAE Rules.JPG

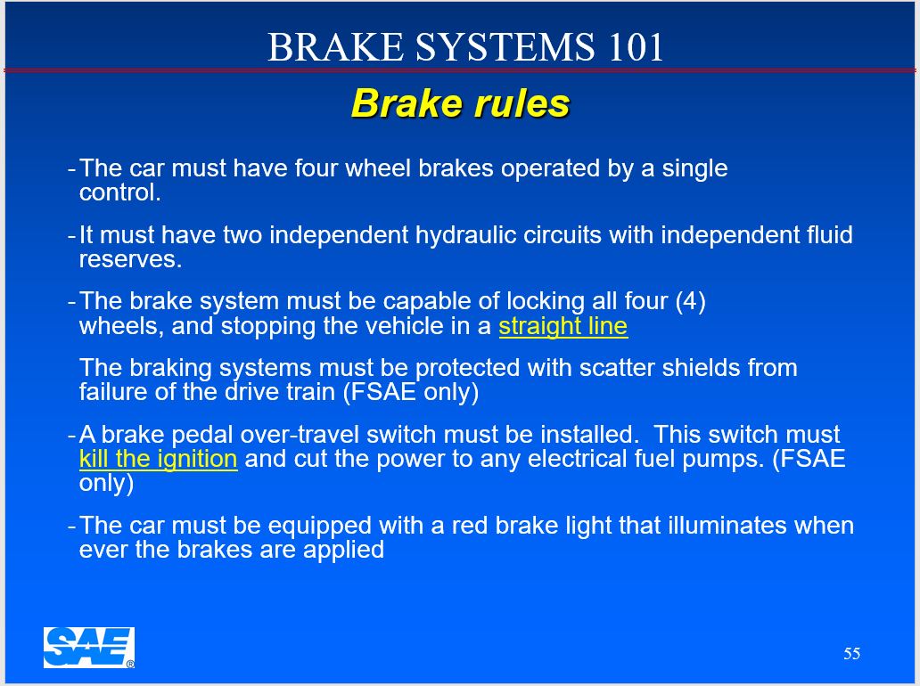
FS-17-0012-H Braking system Design and integration/Rules/FSAE Rules.JPG
