salfordracing/SR-FS-17/pushrod FS2017/1. Mounting.PNG

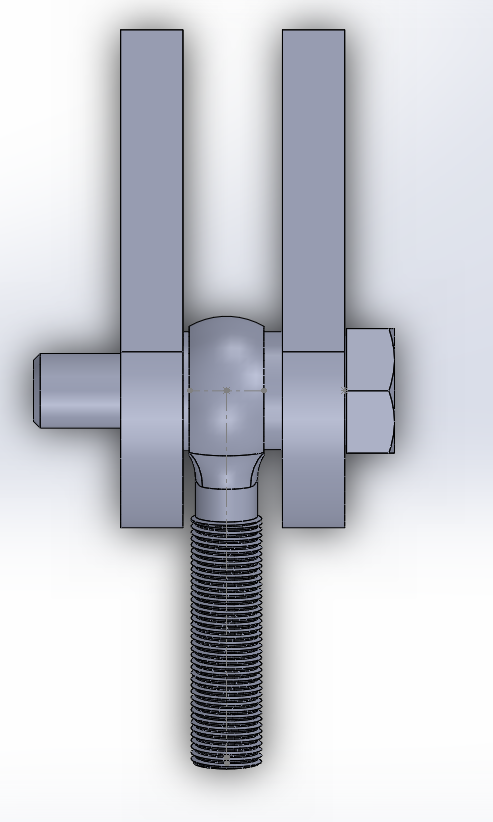
pushrod FS2017/1. Mounting.PNG
