salfordracing/SR-FS-17/pushrod FS2017/Capture.JPG

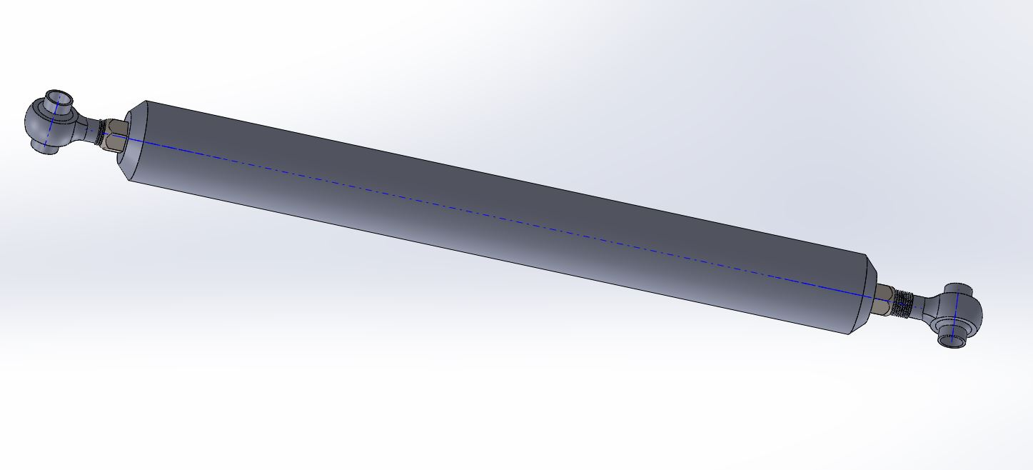
pushrod FS2017/Capture.JPG
