salfordracing/SR-FS-17/pushrod FS2017/pushrod.JPG

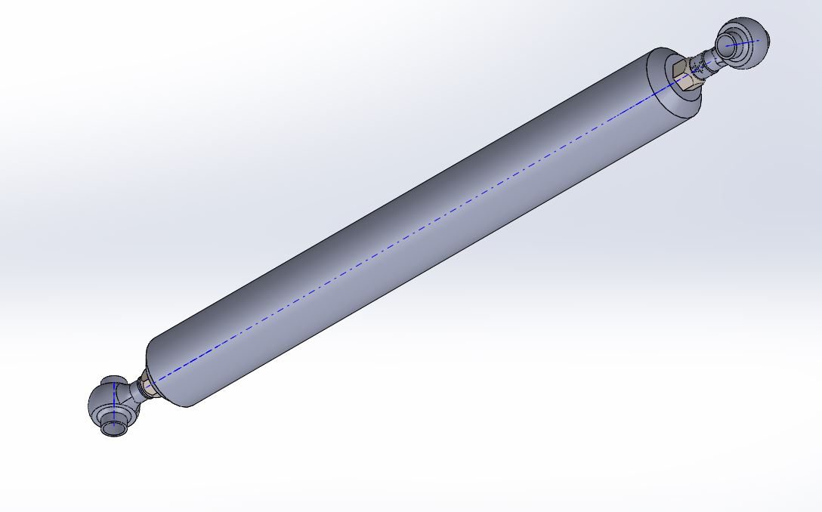
pushrod FS2017/pushrod.JPG
