salfordracing/SR-FS-17/Steering System/formula sae- steering mechanism/Carnegie Mellon Racing CMR 14e Steering System _ Seelio_files/1e4a6349bec2414be071021c3b0711527191.png

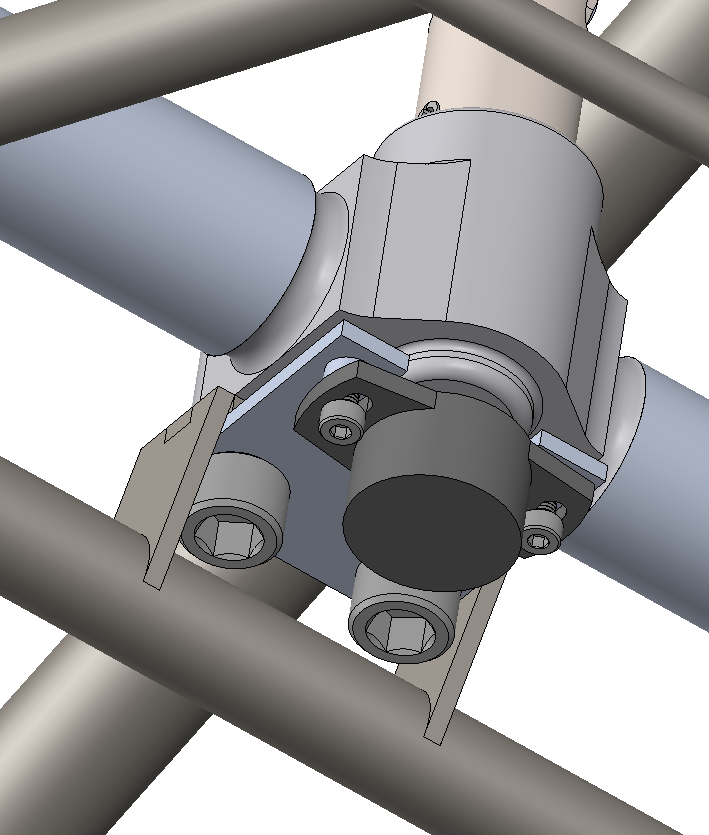
Steering System/formula sae- steering mechanism/Carnegie Mellon Racing CMR 14e Steering System _ Seelio_files/1e4a6349bec2414be071021c3b0711527191.png
