salfordracing/SR-FS-17/Steering System/formula sae- steering mechanism/Carnegie Mellon Racing CMR 14e Steering System _ Seelio_files/9e4fda64bba38813d15065a646cb21d2ab1c.png

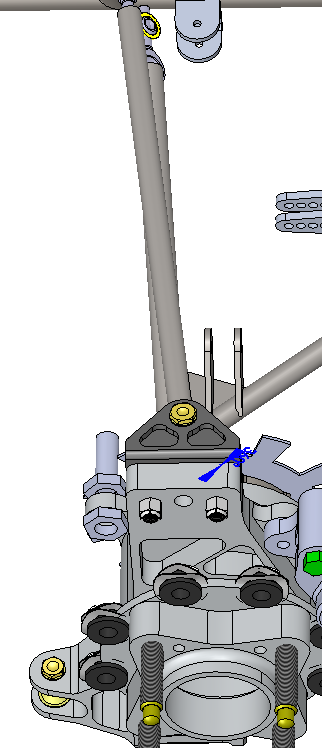
Steering System/formula sae- steering mechanism/Carnegie Mellon Racing CMR 14e Steering System _ Seelio_files/9e4fda64bba38813d15065a646cb21d2ab1c.png
