salfordracing/SR-FS-17/Steering System/formula sae- steering mechanism/Carnegie Mellon Racing CMR 14e Steering System _ Seelio_files/25d1610da9eb40038057482edf1608f702ee.png

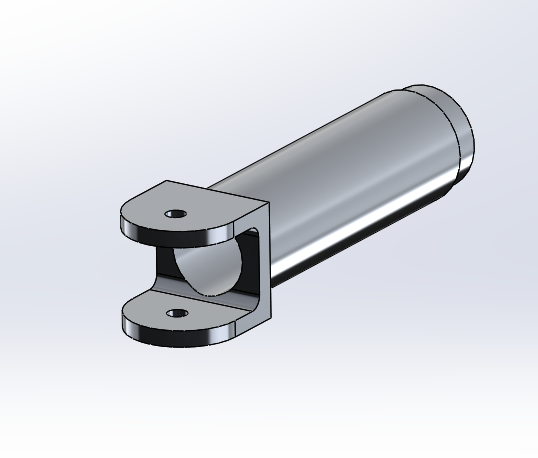
Steering System/formula sae- steering mechanism/Carnegie Mellon Racing CMR 14e Steering System _ Seelio_files/25d1610da9eb40038057482edf1608f702ee.png
