salfordracing/SR-FS-17/Steering System/formula sae- steering mechanism/Carnegie Mellon Racing CMR 14e Steering System _ Seelio_files/29d54f8d28a841e3e432146ee2f3d6684dc6.png

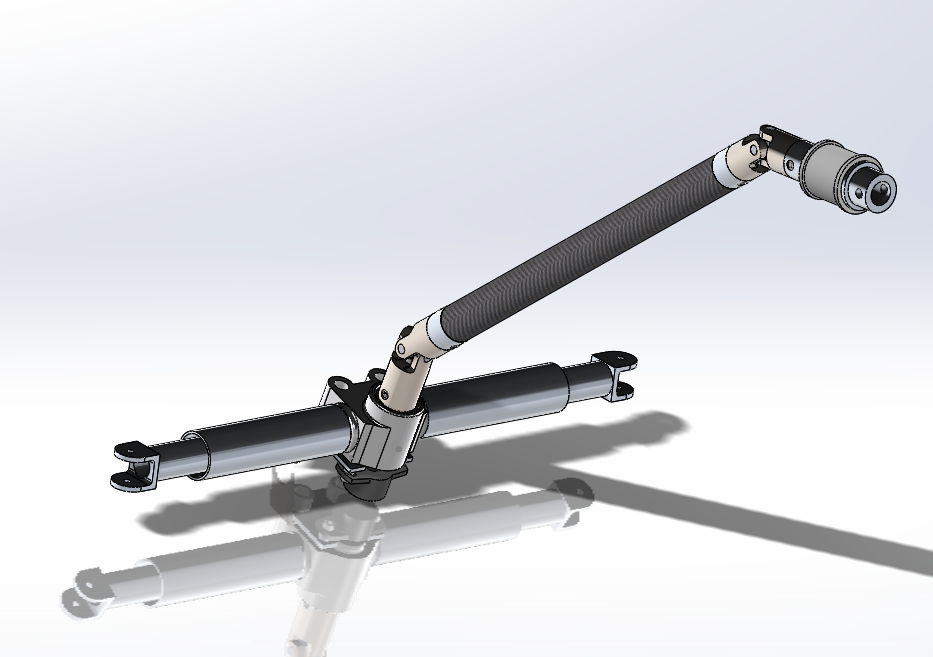
Steering System/formula sae- steering mechanism/Carnegie Mellon Racing CMR 14e Steering System _ Seelio_files/29d54f8d28a841e3e432146ee2f3d6684dc6.png
