salfordracing/SR-FS-17/Steering System/formula sae- steering mechanism/Carnegie Mellon Racing CMR 14e Steering System _ Seelio_files/55c00d732fb150971e6de0a869d06c25e9fe.png

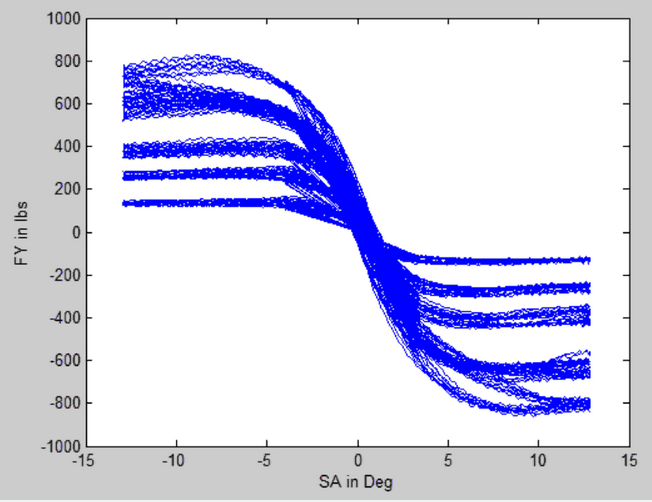
Steering System/formula sae- steering mechanism/Carnegie Mellon Racing CMR 14e Steering System _ Seelio_files/55c00d732fb150971e6de0a869d06c25e9fe.png
