salfordracing/SR-FS-17/Steering System/formula sae- steering mechanism/Carnegie Mellon Racing CMR 14e Steering System _ Seelio_files/08643e2a1f4c52cf5bffe9aee54a40d2546d.png

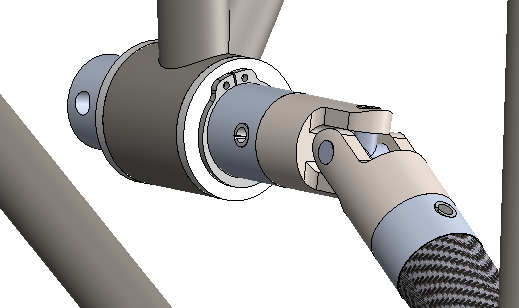
Steering System/formula sae- steering mechanism/Carnegie Mellon Racing CMR 14e Steering System _ Seelio_files/08643e2a1f4c52cf5bffe9aee54a40d2546d.png
