salfordracing/SR-FS-17/Steering System/formula sae- steering mechanism/Carnegie Mellon Racing CMR 14e Steering System _ Seelio_files/a7086d96ec6667a2c03eb31f7a0a1fb7f636_ps.jpg

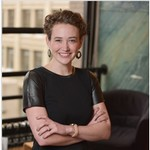
Steering System/formula sae- steering mechanism/Carnegie Mellon Racing CMR 14e Steering System _ Seelio_files/a7086d96ec6667a2c03eb31f7a0a1fb7f636_ps.jpg
