salfordracing/SR-FS-17/Steering System/formula sae- steering mechanism/Carnegie Mellon Racing CMR 14e Steering System _ Seelio_files/b4e0bac674393f5e437a86e8234e30373b7c_ps.jpg

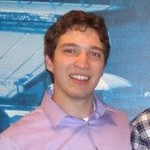
Steering System/formula sae- steering mechanism/Carnegie Mellon Racing CMR 14e Steering System _ Seelio_files/b4e0bac674393f5e437a86e8234e30373b7c_ps.jpg
