salfordracing/SR-FS-17/Suspension/FS17 Suspension_/2017 Wishbone CAD/fsae-front-hub-1.snapshot.1/FSAE FRONT HUB.png

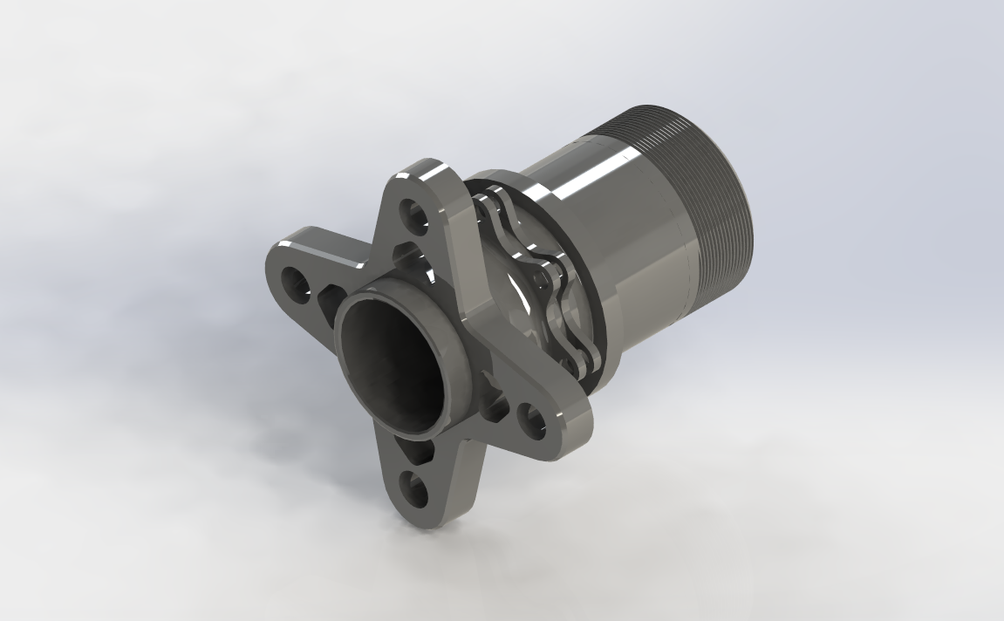
Suspension/FS17 Suspension_/2017 Wishbone CAD/fsae-front-hub-1.snapshot.1/FSAE FRONT HUB.png
