salfordracing/SR-FS-17/Suspension/FS17 Suspension_/2017 Wishbone CAD/fsae-rear-hub-1.snapshot.1/FSAE REAR HUB - TRIPOD SIDE.png

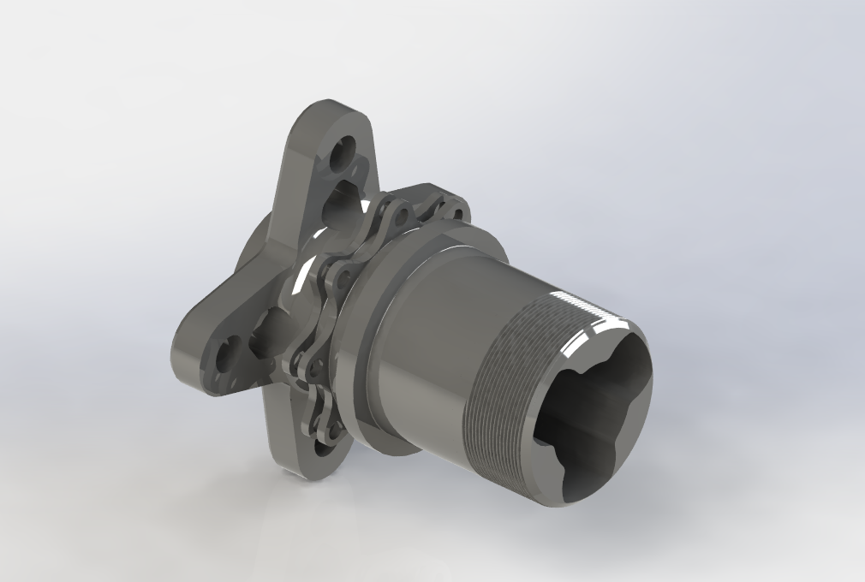
Suspension/FS17 Suspension_/2017 Wishbone CAD/fsae-rear-hub-1.snapshot.1/FSAE REAR HUB - TRIPOD SIDE.png
