salfordracing/SR-FS-17/Suspension/FS18 Suspension/rear upright and hub_/asse.jpg

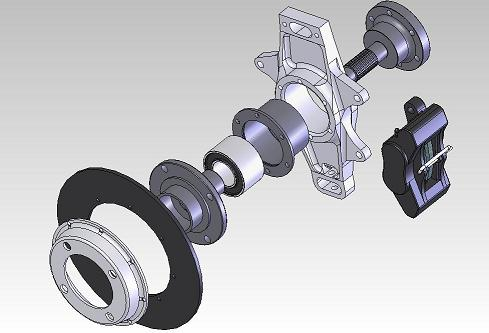
Suspension/FS18 Suspension/rear upright and hub_/asse.jpg
