salfordracing/SR-FS-17/Suspension/FS18 Suspension/rear upright and hub_/hub.jpg

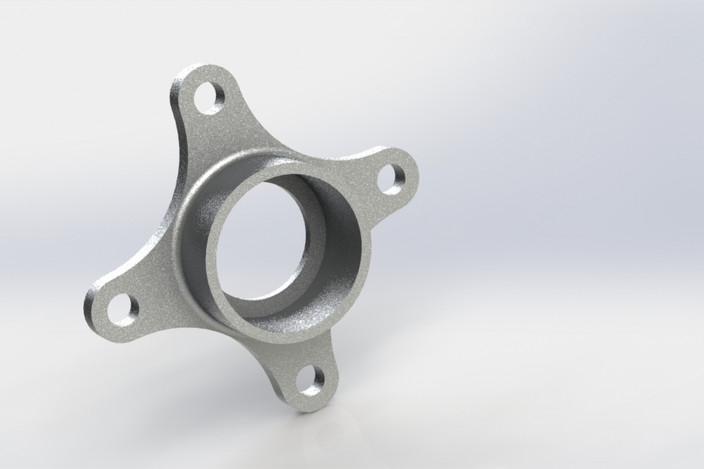
Suspension/FS18 Suspension/rear upright and hub_/hub.jpg
