salfordracing/SR-FS-17/Suspension/FS18 Suspension/rear upright and hub_/reaar1.jpg

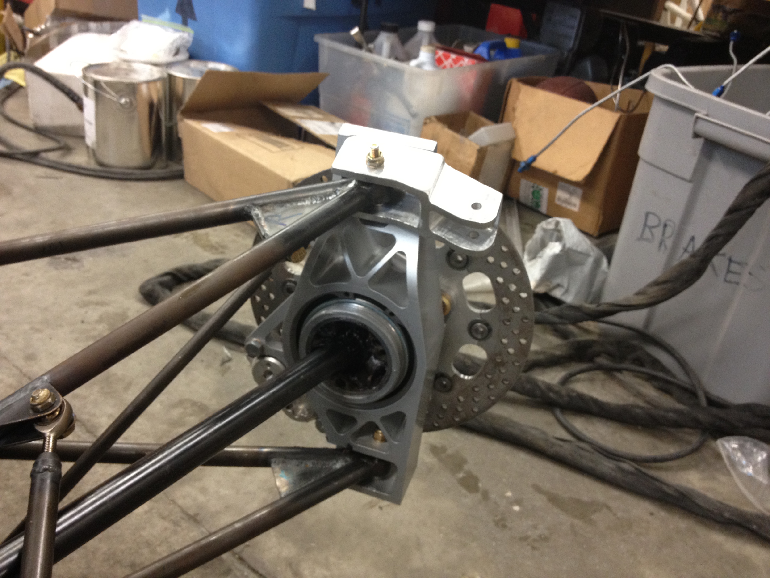
Suspension/FS18 Suspension/rear upright and hub_/reaar1.jpg
