salfordracing/SR-FS-17/Suspension/FS18 Suspension/rear upright and hub_/rearhub.JPG

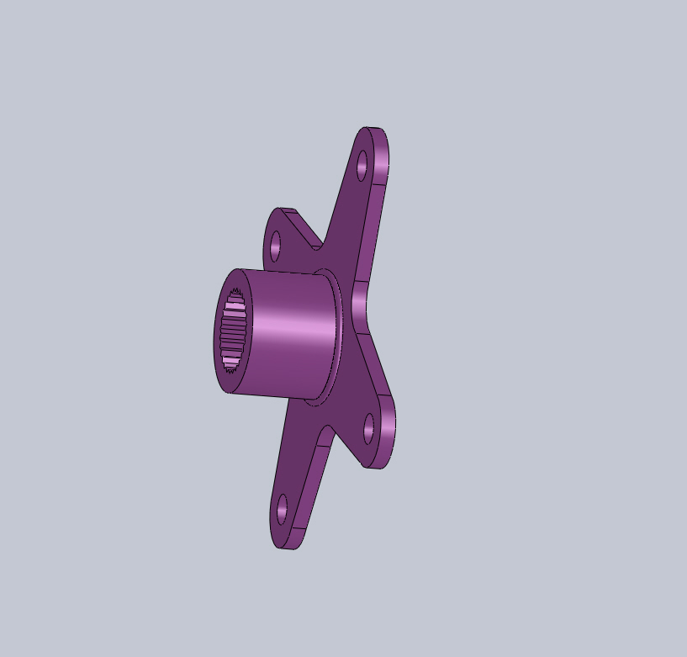
Suspension/FS18 Suspension/rear upright and hub_/rearhub.JPG
