salfordracing/SR-FS-17/Suspension/FS18 Suspension/Research/1_e965759.jpg

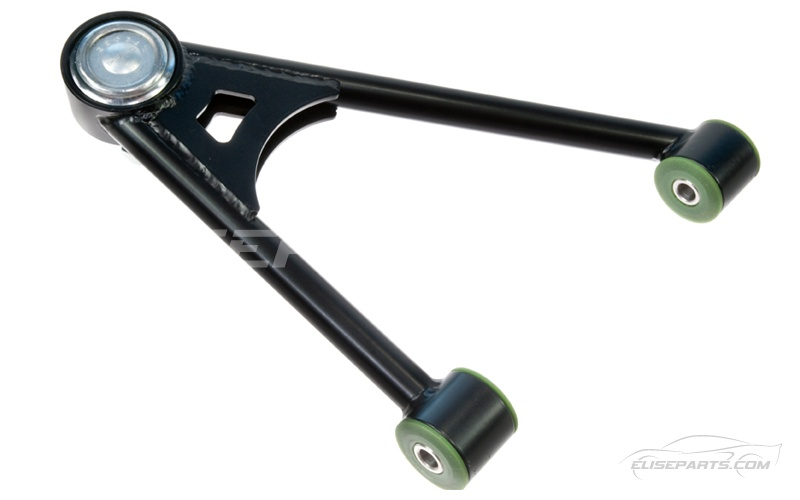
Suspension/FS18 Suspension/Research/1_e965759.jpg
