salfordracing/SR-FS-17/Suspension/FS18 Suspension/Research/100_2947.JPG

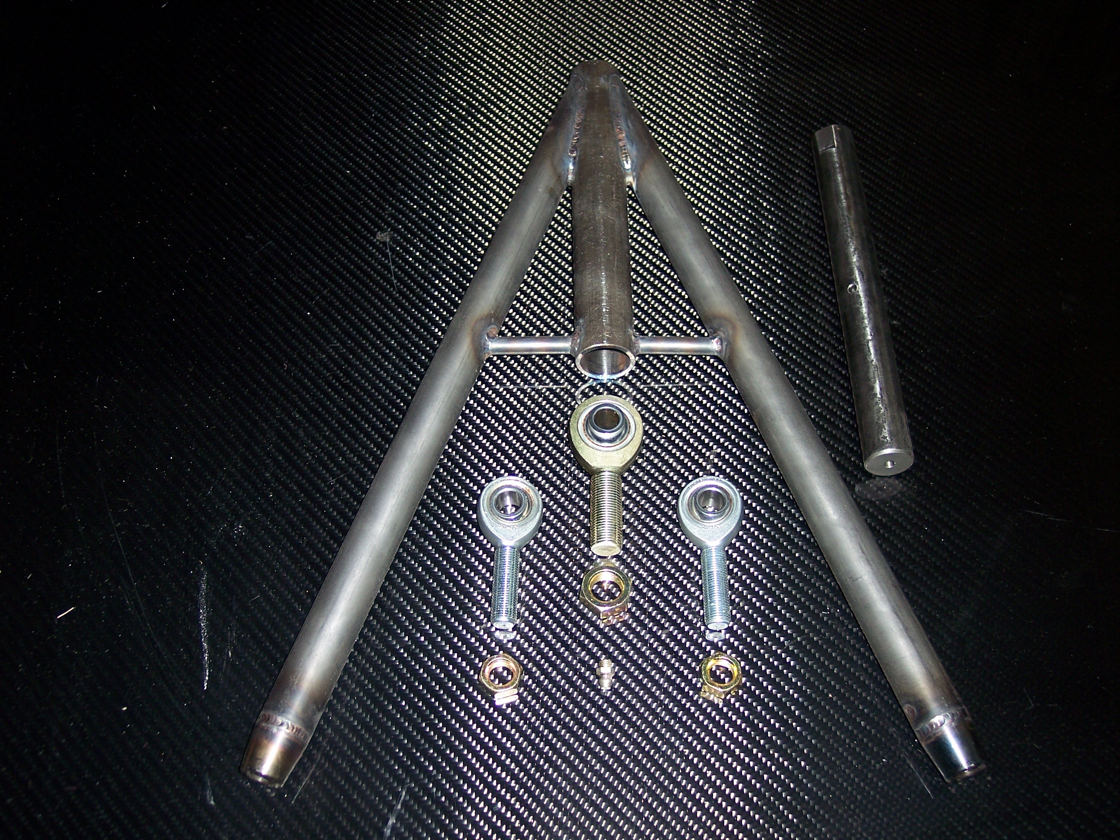
Suspension/FS18 Suspension/Research/100_2947.JPG
