salfordracing/SR-FS-17/Suspension/FS18 Suspension/Research/0911rc_09_z+ford_wishbone_suspension+tie_rod_ends.jpg

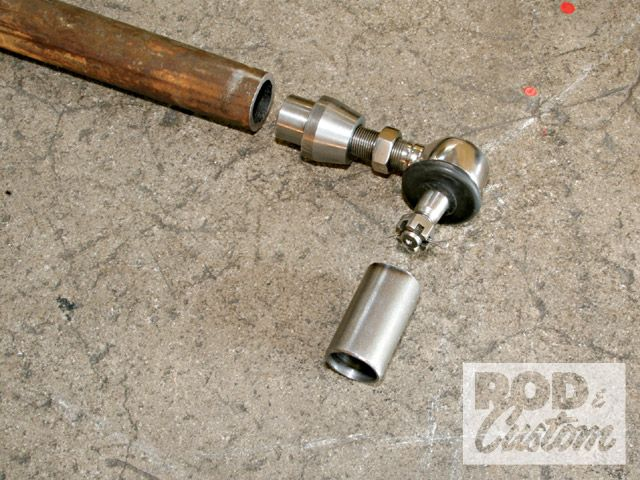
Suspension/FS18 Suspension/Research/0911rc_09_z+ford_wishbone_suspension+tie_rod_ends.jpg
