salfordracing/SR-FS-17/Suspension/FS18 Suspension/Research/RTEmagicC_image009.jpg.jpg

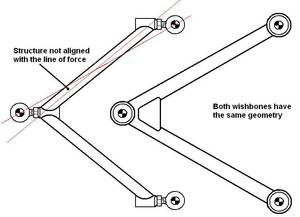
Suspension/FS18 Suspension/Research/RTEmagicC_image009.jpg.jpg
