salfordracing/SR-FS-17/Suspension/FS18 Suspension/Research/s-6616.jpg

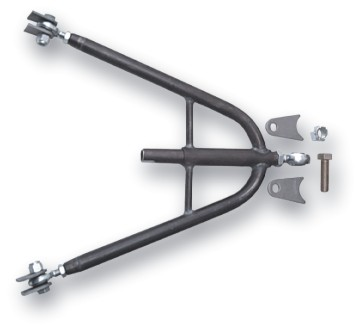
Suspension/FS18 Suspension/Research/s-6616.jpg
