salfordracing/SR-FS-17/Assembly/FInal Assembly (Don't Touch)/Assembly/Suspension/Rear Wishbone.SLDASM

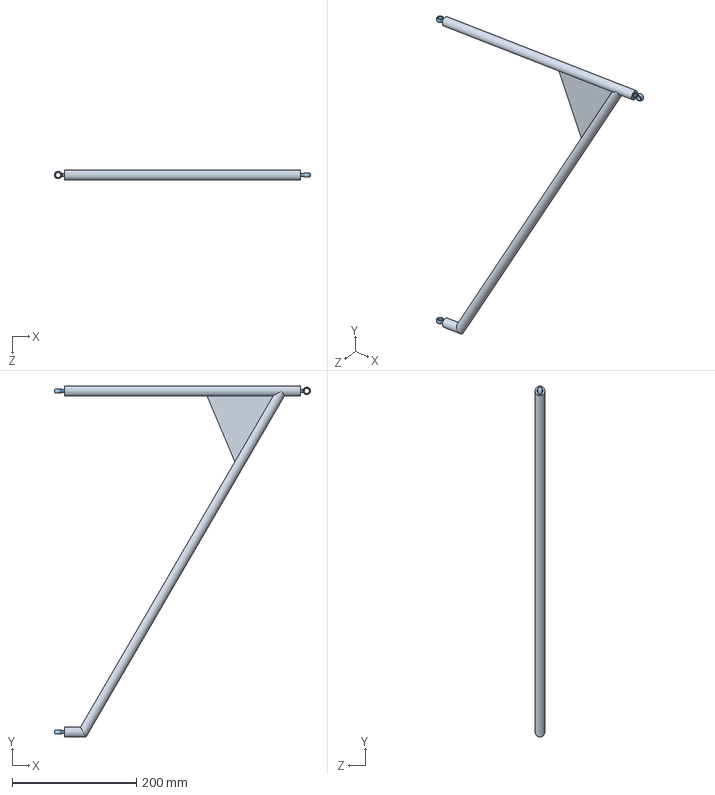
[picture p147: CAD file, 2017-11-24]
Assembly/FInal Assembly (Don't Touch)/Assembly/Suspension/Rear Wishbone.SLDASM
412.9 x 566.0 x 15.8 mm
rear wishbone
rod end screw cap x 3
Pushrod screw x 3
