salfordracing/SR-FS-17/Assembly/wishbone assembly.SLDASM

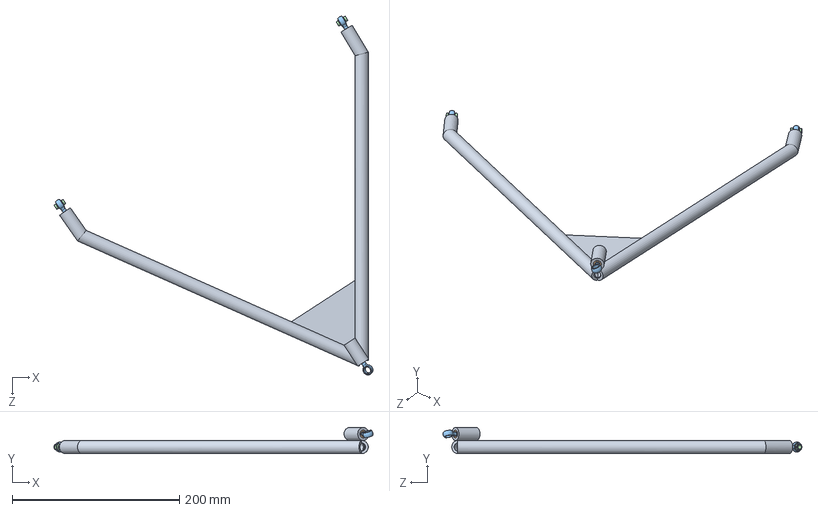
[picture p148: CAD file, 2017-11-24]
Assembly/wishbone assembly.SLDASM
381.9 x 31.4 x 429.6 mm
wishbone rod new
rod end screw cap x 3
Pushrod screw x 3
J1 x 2
