salfordracing/SR-FS-17/FS-17-0009-H Project Break Down Impact Attenuator/dev assy.SLDASM

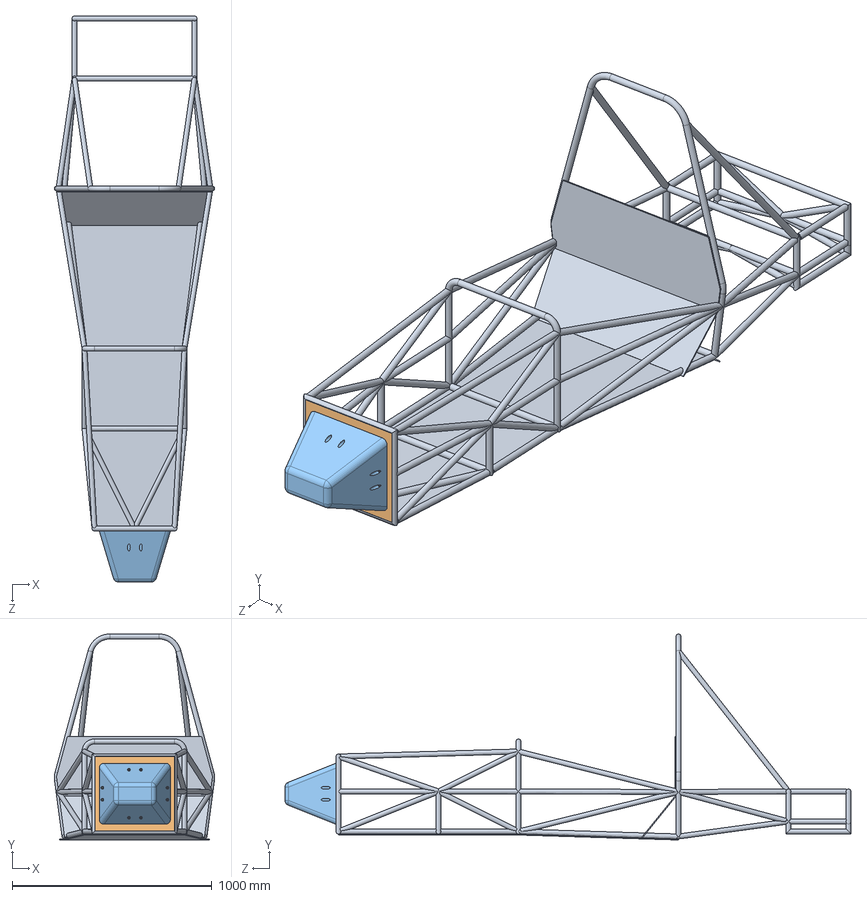
[picture p149: CAD file, 2017-11-24]
FS-17-0009-H Project Break Down Impact Attenuator/dev assy.SLDASM
801.4 x 1030.0 x 2830.1 mm
Chassis
FS-17-000-MS-00001-AA
FS-17-000-MS-00004-AA
FS-17-000-FS-00002-AA x 8
FS-17-000-FS-00003-AA x 8
