salfordracing/SR-FS-17/Powertrain/Driveshaft/FS17-PT-CF09-01 GKN Inner Joint/IBKITVL VL.SLDASM

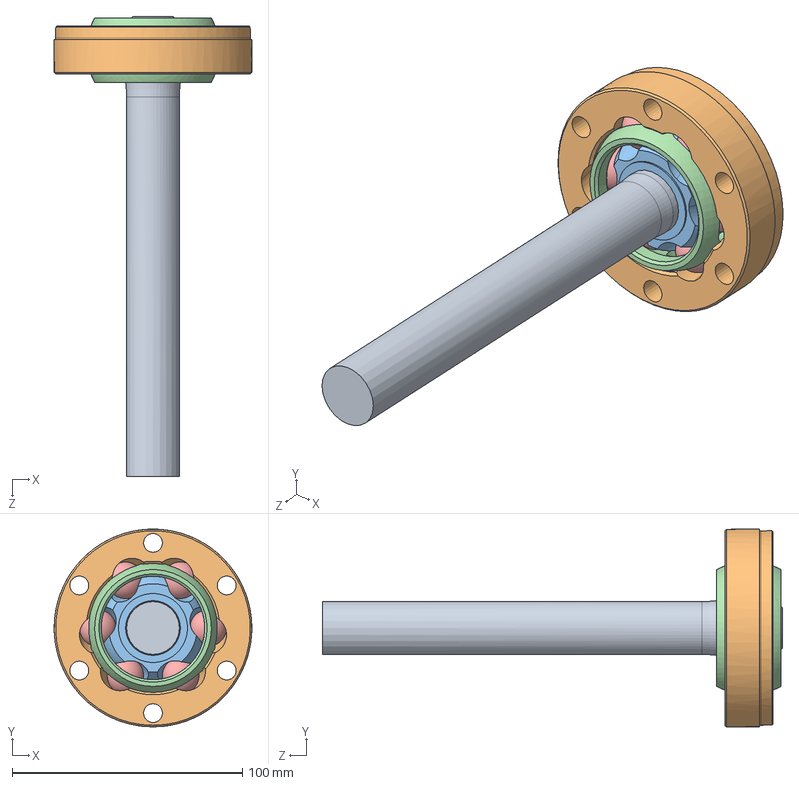
[picture p150: CAD file, 2017-11-24]
Powertrain/Driveshaft/FS17-PT-CF09-01 GKN Inner Joint/IBKITVL VL.SLDASM
86.0 x 86.0 x 200.0 mm
VL1500i Disc Bar End
outer_1
Inner_1
cage_2
Ball_1 x 6
GLi1500 circlip_2
