salfordracing/SR-FS-17/Powertrain/Driveshaft/FS18-PT-CF10-02 GKN Outer Joint_/OBKIT AC1700i.SLDASM

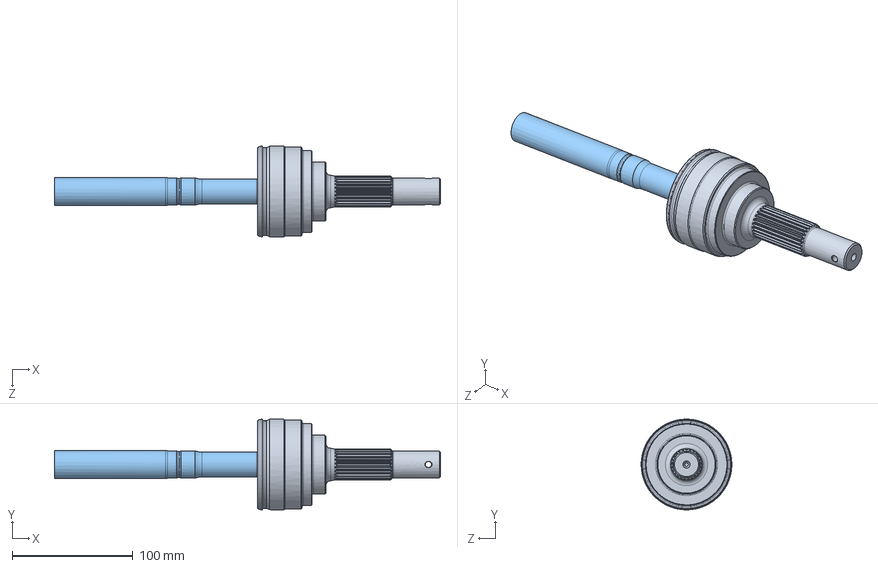
[picture p151: CAD file, 2017-11-24]
Powertrain/Driveshaft/FS18-PT-CF10-02 GKN Outer Joint_/OBKIT AC1700i.SLDASM
319.9 x 75.2 x 75.2 mm
10274392 AC Outer Race_1
AC1700i Inner Race
AC1700i Bar End
AC1700i Circlip
