salfordracing/SR-FS-17/Assembly/FInal Assembly (Don't Touch)/Assembly/Pedal box so far due to solidworks being a mess/Brake pedal assembly.SLDASM

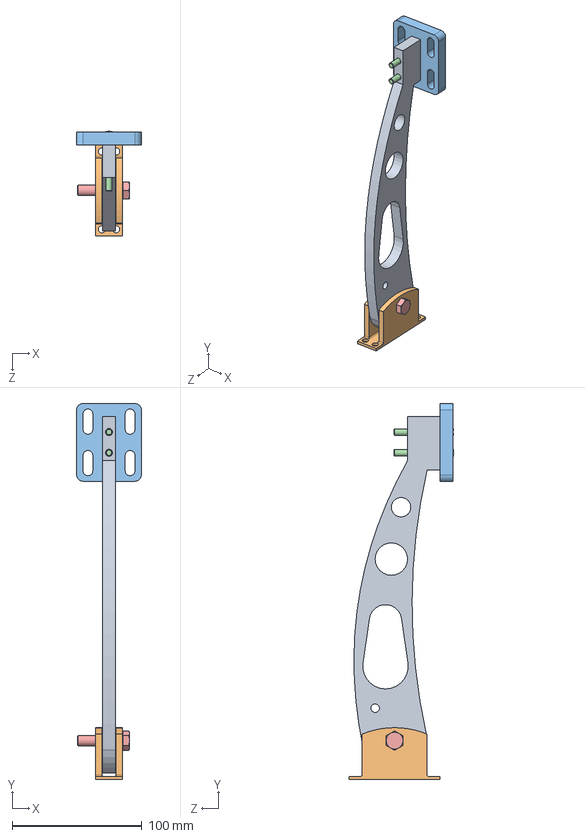
[picture p152: CAD file, 2017-11-24]
Assembly/FInal Assembly (Don't Touch)/Assembly/Pedal box so far due to solidworks being a mess/Brake pedal assembly.SLDASM
50.0 x 290.0 x 80.6 mm
Pedal support
Base Pedal Interface
Brake pedal only
din_en_iso2010_m5x45_4_8 x 2
din_en_24017_m8x35
