salfordracing/SR-FS-17/2017 vehicle design/Pedal Box/2017 Pedals/Pedal Box Final Assembly.SLDASM

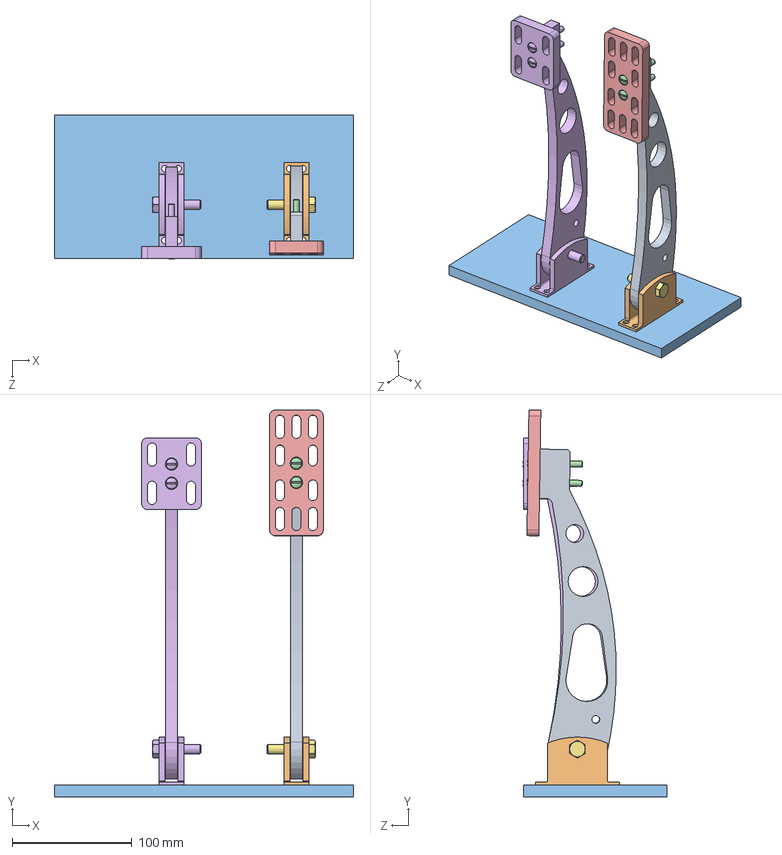
[picture p153: CAD file, 2017-11-24]
2017 vehicle design/Pedal Box/2017 Pedals/Pedal Box Final Assembly.SLDASM
250.0 x 323.2 x 120.6 mm
Pedal support
Base Pedal Interface
Base
din_en_iso2010_m5x45_4_8 x 2
Accellerator Pedal
Brake pedal assembly
din_en_24017_m8x35
