salfordracing/SR-FS-17/Assembly/Assembly of all.SLDASM

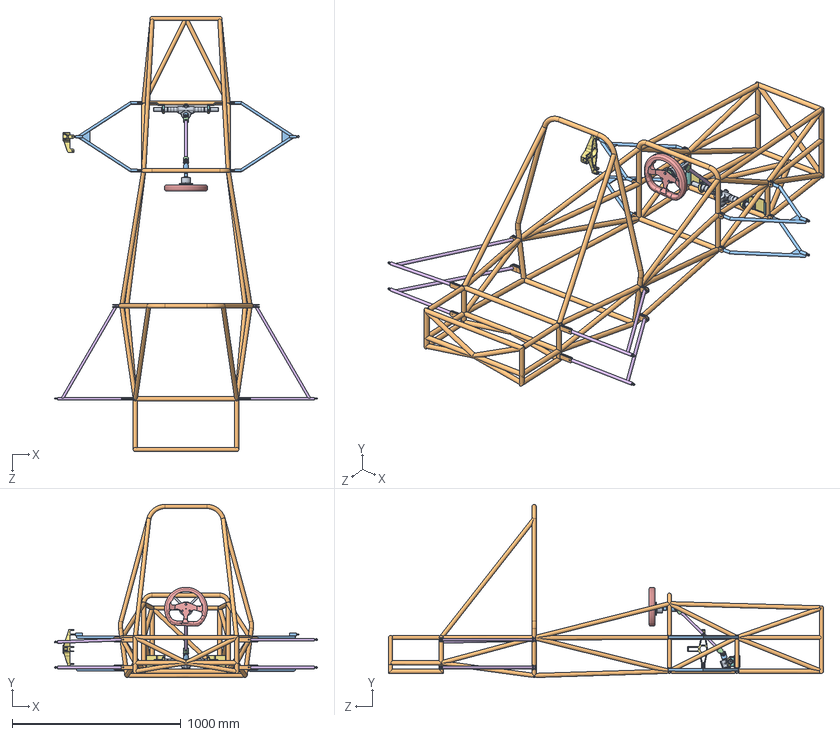
[picture p154: CAD file, 2017-11-24]
Assembly/Assembly of all.SLDASM
1556.3 x 1025.0 x 2575.0 mm
steering rack
alexfeb 2017 new mounts( still need wishbone and editing)
front wishbones x 4
rod end screw cap x 24
Pushrod screw x 24
rear wishbone x 4
new rack attachment - 1 x 2
new rack attachment - 2 x 2
bushing
steering shaft
steering shaft - 2
rack bracket 2 x 2
rack bracket 1 x 2
quick release plate attachment1
TE501054mozzoQR210-3d
TE501053pernoQR210-3d
TE501060boccolaQR200-3d
steering wheel
hex screw gradec_bsi x 3
UPRIGHT_FRONT_LEFT
