salfordracing/SR-FS-17/CAD_/Pedal box so far due to solidworks being a mess/drive-download-20170208T124512Z/Pedal box assem.SLDASM

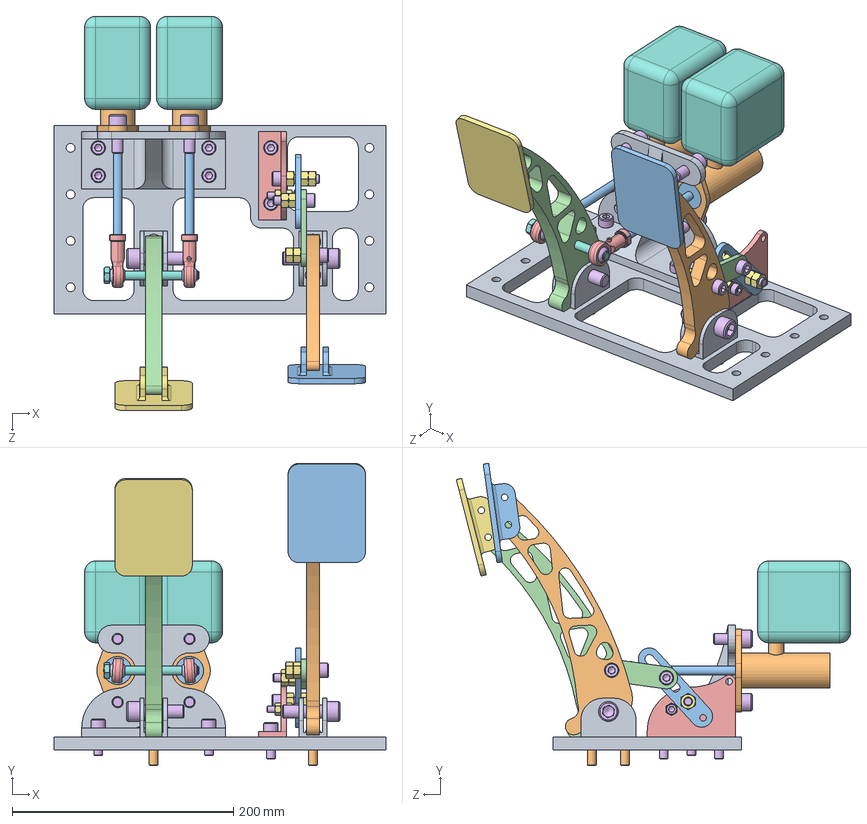
[picture p155: CAD file, 2017-11-24]
CAD_/Pedal box so far due to solidworks being a mess/drive-download-20170208T124512Z/Pedal box assem.SLDASM
300.0 x 273.3 x 356.4 mm
brake holder2
master cylinder x 2
master cylinder_plunge x 2
brake pedal bar2
rotula x 2
rotula2 x 2
brake pedal
reservoir x 2
pedal box base
throttle pedal bar
link1
link2
throttle link holder
socket head cap screw_am x 16
hex nut style 1_am x 9
hex cap screw_am
bracket1 x 2
socket button head cap screw_am x 4
throttle pedal
