salfordracing/SR-FS-17/2017 vehicle design/Pedal Box/2017 Pedals/Brake pedal.SLDASM

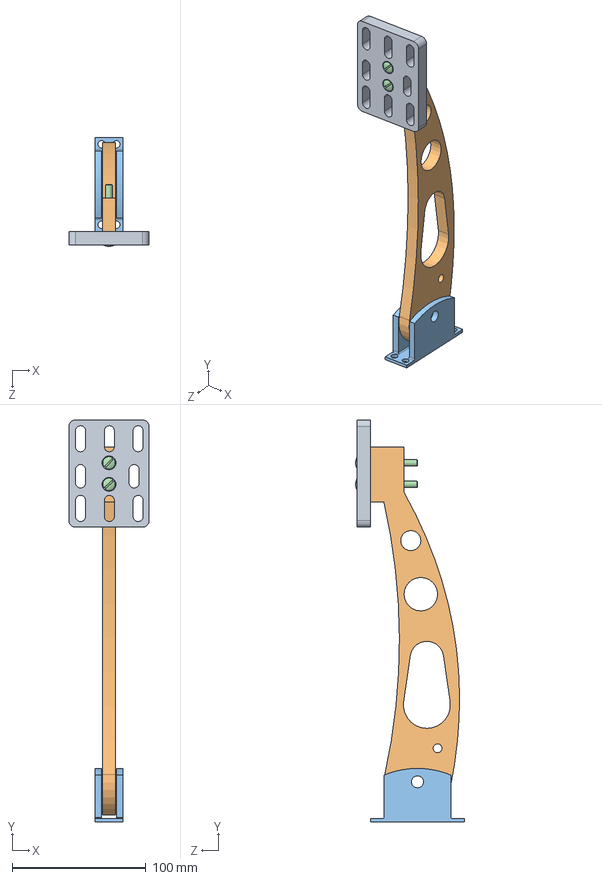
[picture p156: CAD file, 2017-11-24]
2017 vehicle design/Pedal Box/2017 Pedals/Brake pedal.SLDASM
60.0 x 300.0 x 81.2 mm
Accellerator Pedal
Pedal support
Base Pedal Interface
din_en_iso2010_m5x45_4_8 x 2
