salfordracing/SR-FS-17/FS-17-0009-H Project Break Down Impact Attenuator/FS-17-000-MS-A0001-AA.SLDASM

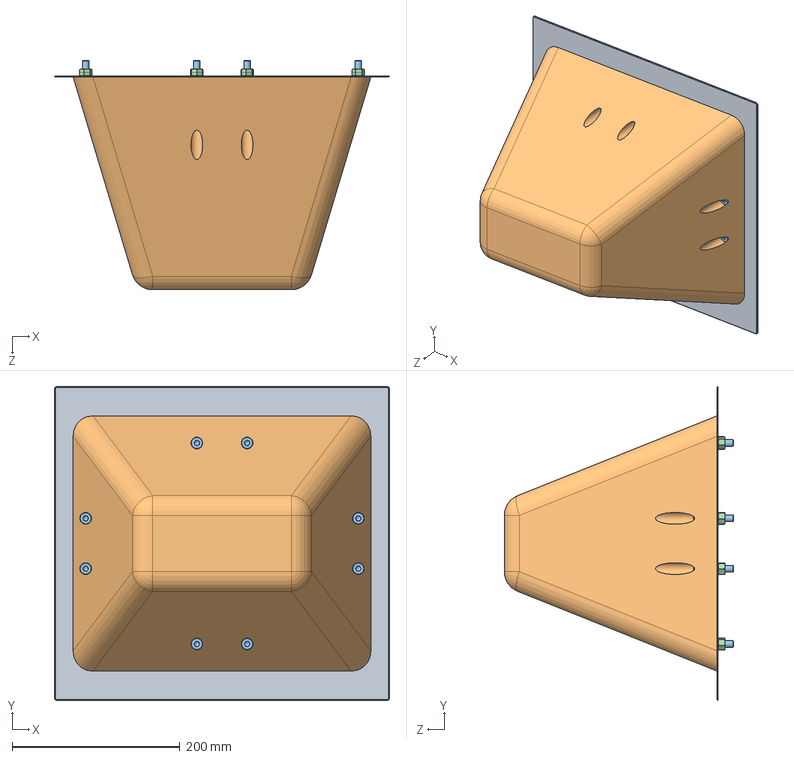
[picture p157: CAD file, 2017-11-24]
FS-17-0009-H Project Break Down Impact Attenuator/FS-17-000-MS-A0001-AA.SLDASM
400.0 x 375.0 x 274.0 mm
FS-17-000-MS-00001-AA
FS-17-000-MS-00004-AA
FS-17-000-FS-00002-AA x 8
FS-17-000-FS-00003-AA x 8
