salfordracing/SR-FS-17/Suspension/FS18 Suspension/2018 Wishbone CAD/Version 1/Parts/Assem2.SLDASM

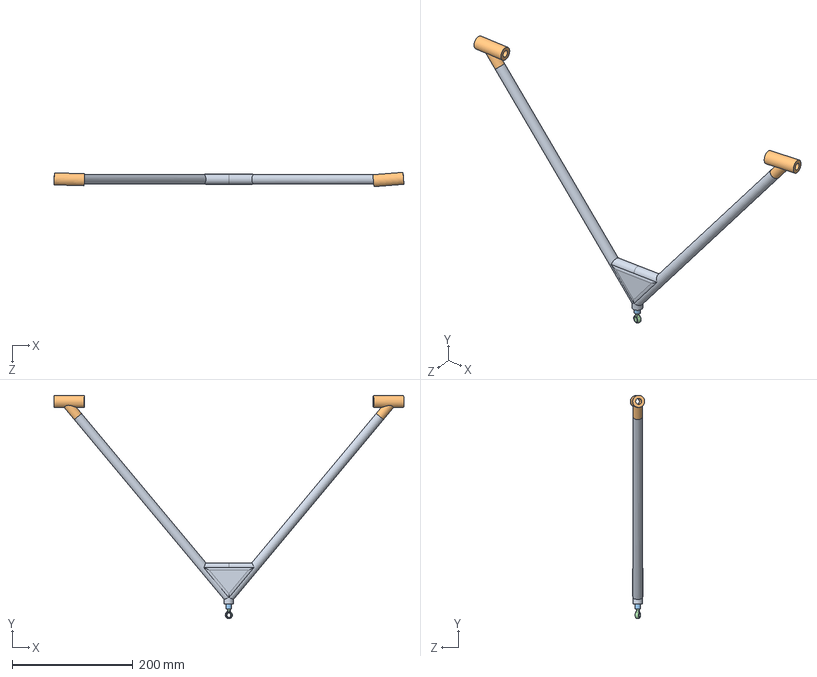
[picture p158: CAD file, 2017-11-24]
Suspension/FS18 Suspension/2018 Wishbone CAD/Version 1/Parts/Assem2.SLDASM
579.6 x 369.9 x 23.9 mm
Wishobone-chassis end x 2
rod end screw cap
Pushrod screw
