salfordracing/SR-FS-17/pushrod FS2017/pushrod assembly.SLDASM

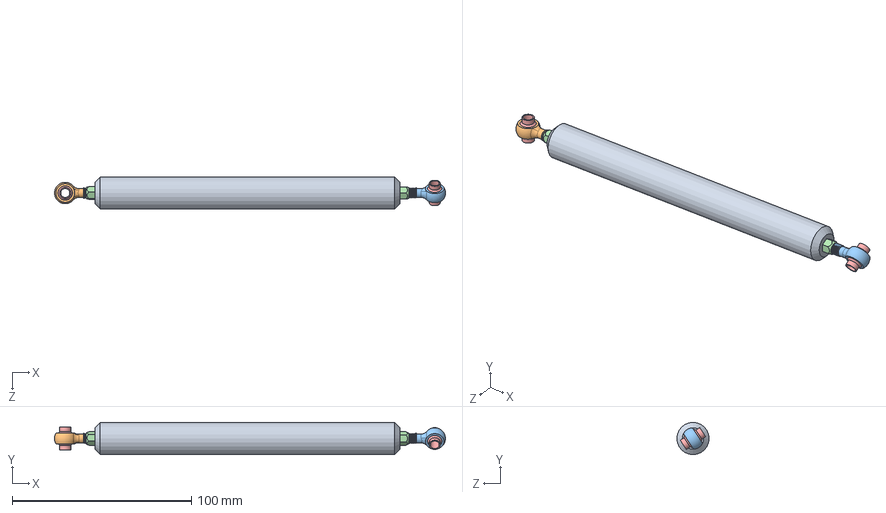
[picture p159: CAD file, 2017-11-24]
pushrod FS2017/pushrod assembly.SLDASM
217.9 x 18.0 x 18.0 mm
pushrod FS17
Pushrod screw
screw bottom Pushrod
clockwise nut x 2
J1 x 2
