salfordracing/SR-FS-17/Assembly/FInal Assembly (Don't Touch)/Assembly/Pedal box so far due to solidworks being a mess/Brake pedal assem.SLDPRT.SLDASM

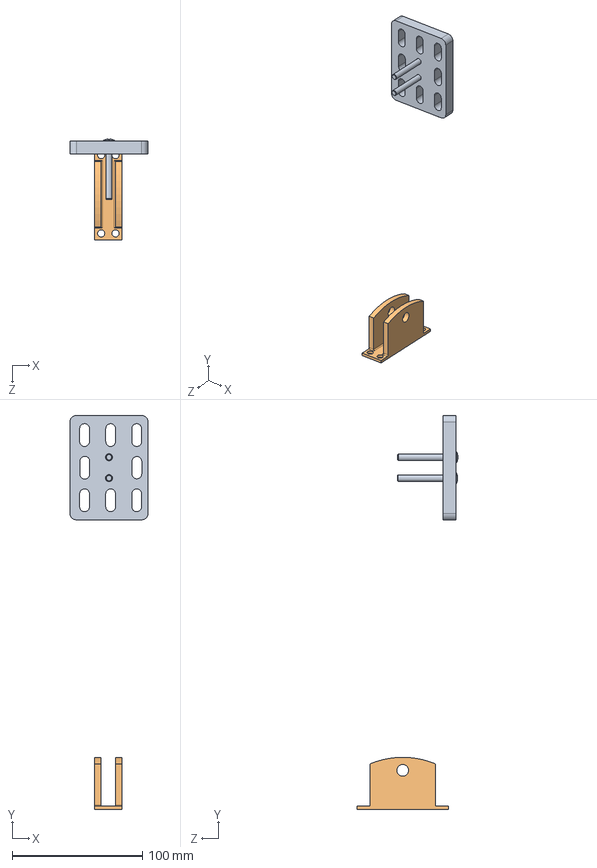
[picture p160: CAD file, 2017-11-24]
Assembly/FInal Assembly (Don't Touch)/Assembly/Pedal box so far due to solidworks being a mess/Brake pedal assem.SLDPRT.SLDASM
60.0 x 302.0 x 77.3 mm
Brake pedal with support and bolts
Base Pedal Interface
