salfordracing/SR-FS-17/Suspension/FS17 Suspension_/2017 Wishbone CAD/Front Wishbone Final.SLDASM

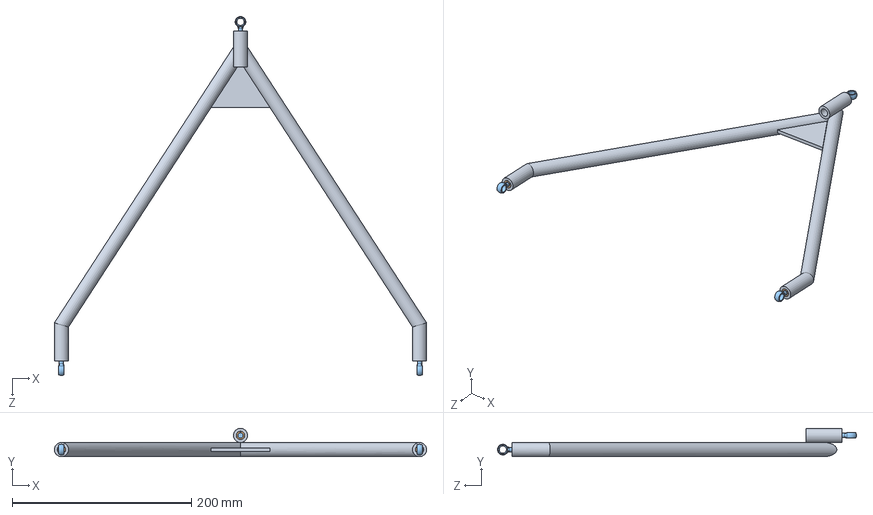
[picture p161: CAD file, 2017-11-24]
Suspension/FS17 Suspension_/2017 Wishbone CAD/Front Wishbone Final.SLDASM
415.2 x 31.6 x 400.4 mm
front wishbones
rod end screw cap x 3
Pushrod screw x 3
