salfordracing/SR-FS-17/Assembly/FInal Assembly (Don't Touch)/Assembly/Steering/steering attachment.SLDASM

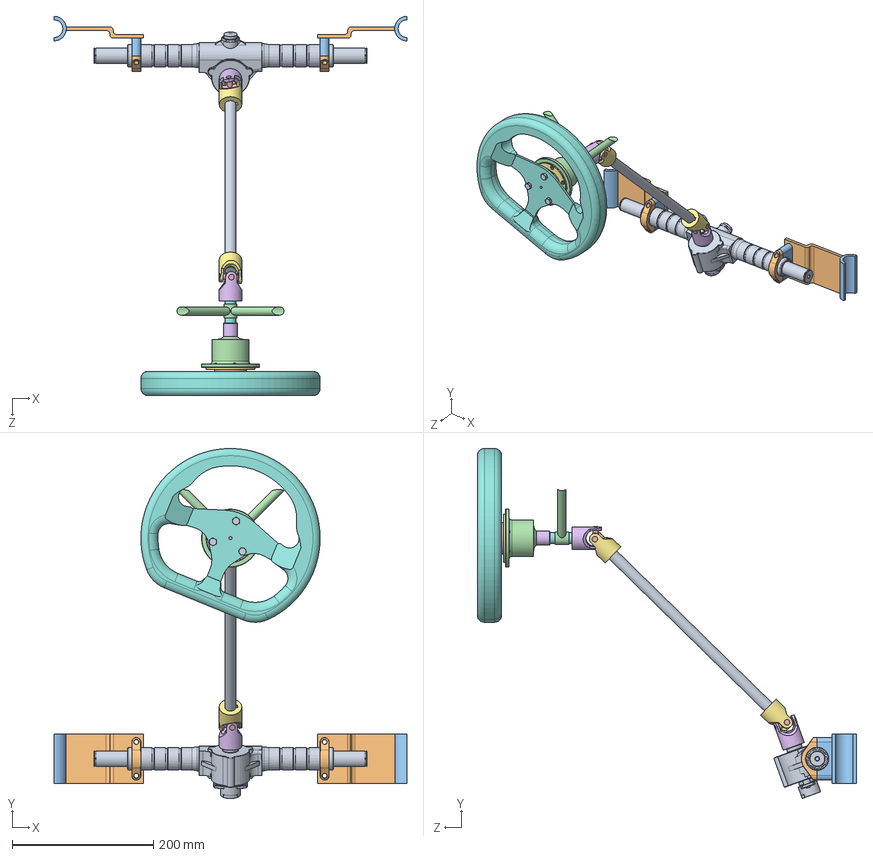
[picture p162: CAD file, 2017-11-24]
Assembly/FInal Assembly (Don't Touch)/Assembly/Steering/steering attachment.SLDASM
500.0 x 495.8 x 537.5 mm
steering rack
new rack attachment - 1 x 2
new rack attachment - 2 x 2
bushing
steering shaft
steering shaft - 2
rack bracket 2 x 2
rack bracket 1 x 2
quick release plate attachment1
TE501054mozzoQR210-3d
TE501053pernoQR210-3d
TE501060boccolaQR200-3d
steering wheel
hex screw gradec_bsi x 3
