salfordracing/SR-FS-17/Assembly/Temporary final assembly.SLDASM

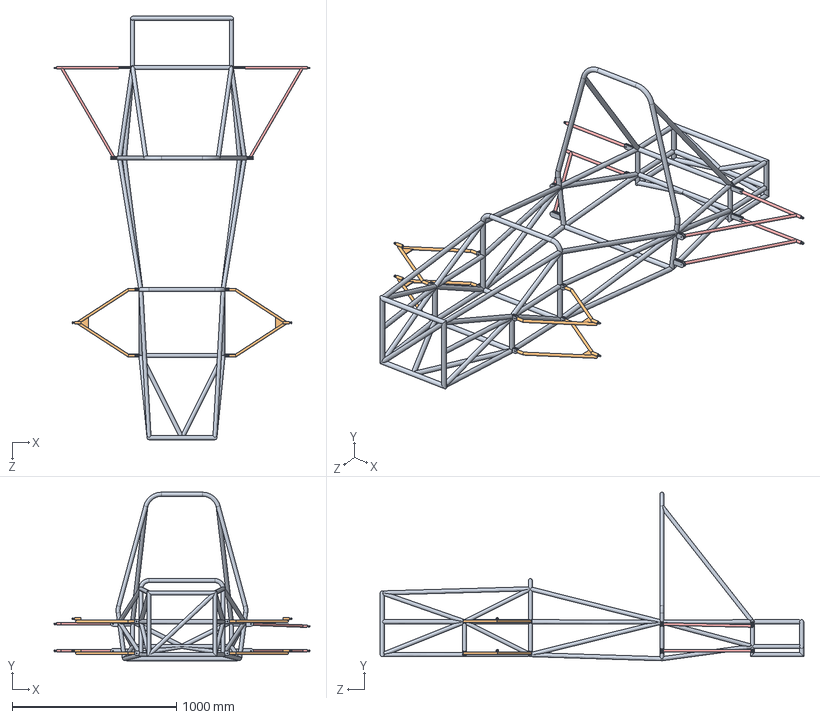
[picture p163: CAD file, 2017-11-24]
Assembly/Temporary final assembly.SLDASM
1556.3 x 1025.0 x 2575.0 mm
alexfeb 2017 new mounts( still need wishbone and editing)
front wishbones x 4
rod end screw cap x 24
Pushrod screw x 24
rear wishbone x 4
