salfordracing/SR-FS-17/2017 vehicle design/Pedal Box/2017 Pedals/Assem1.SLDASM

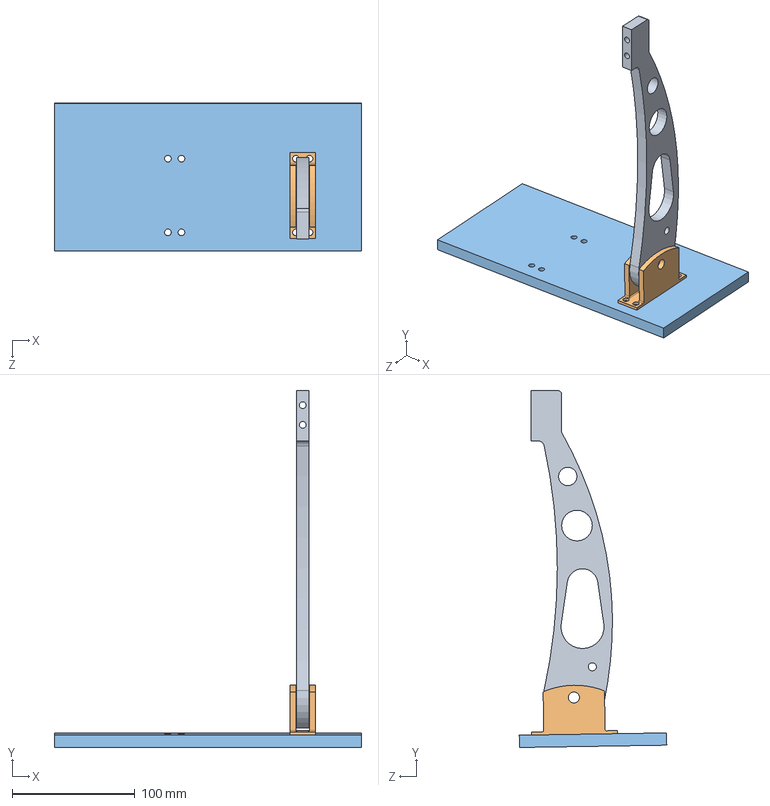
[picture p164: CAD file, 2017-11-24]
2017 vehicle design/Pedal Box/2017 Pedals/Assem1.SLDASM
250.0 x 290.7 x 120.1 mm
Pedal support
Base Pedal Interface
Base
