salfordracing/SR-FS-17/Chassis designs/Callum's Chassis Designs/Completed Chassis.SLDPRT

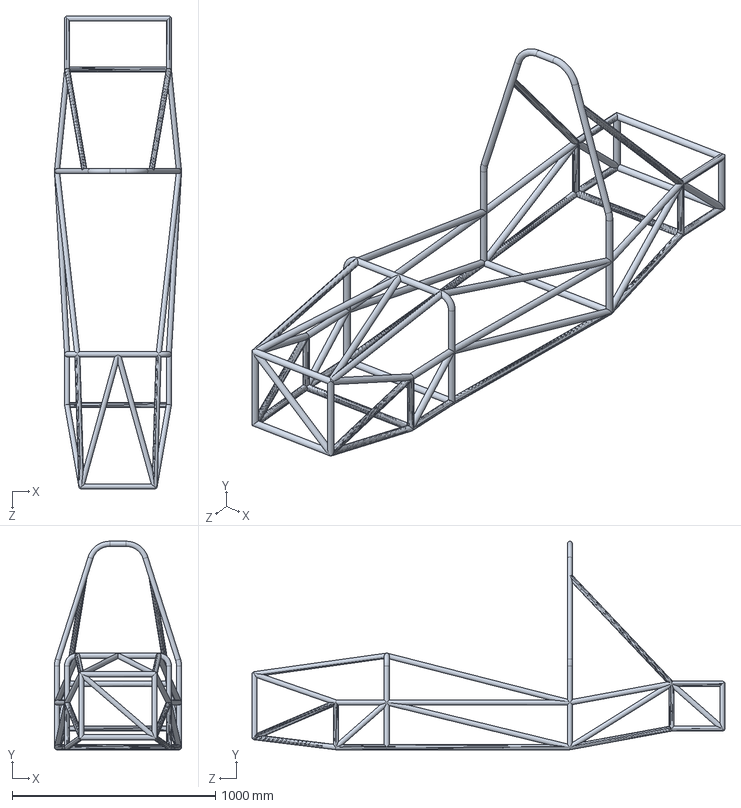
[picture p165: CAD file, 2017-11-24]
Chassis designs/Callum's Chassis Designs/Completed Chassis.SLDPRT
625.4 x 1025.4 x 2325.4 mm
