salfordracing/SR-FS-17/Assembly/FInal Assembly (Don't Touch)/Assembly/Pedal box so far due to solidworks being a mess/New assembly pedal box SOLIDWORKS IS A DICK.SLDASM

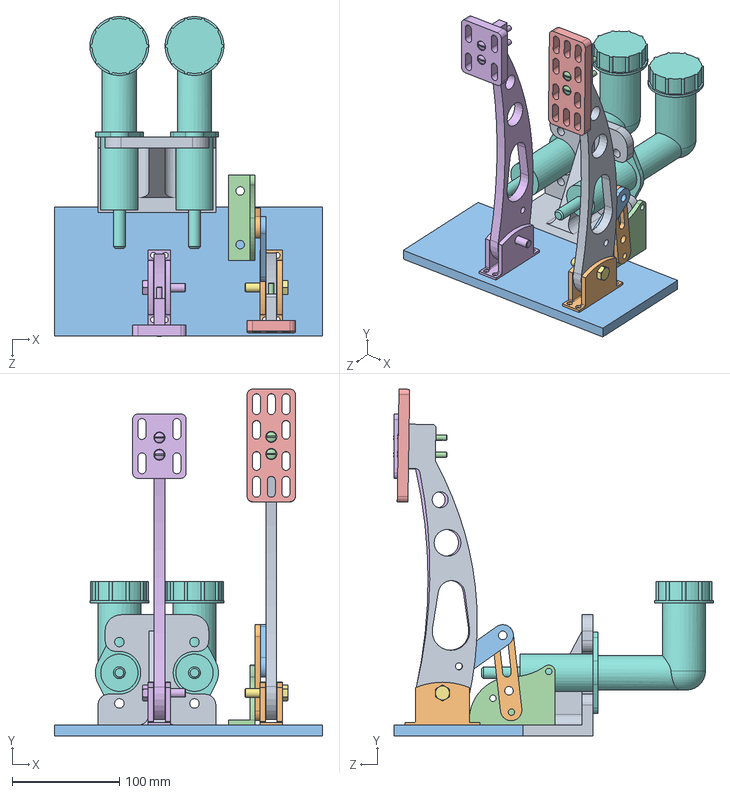
[picture p166: CAD file, 2017-11-24]
Assembly/FInal Assembly (Don't Touch)/Assembly/Pedal box so far due to solidworks being a mess/New assembly pedal box SOLIDWORKS IS A DICK.SLDASM
250.0 x 323.2 x 298.2 mm
Pedal support
Base Pedal Interface
Base
din_en_iso2010_m5x45_4_8 x 2
Accellerator Pedal
Brake pedal assembly
din_en_24017_m8x35
Brake c. holder
link1
link2
throttle link holder
