salfordracing/SR-FS-17/Steering System/formula sae- steering mechanism/F7_QUICK-RELEASE WITH CONNECTOR1.SLDASM

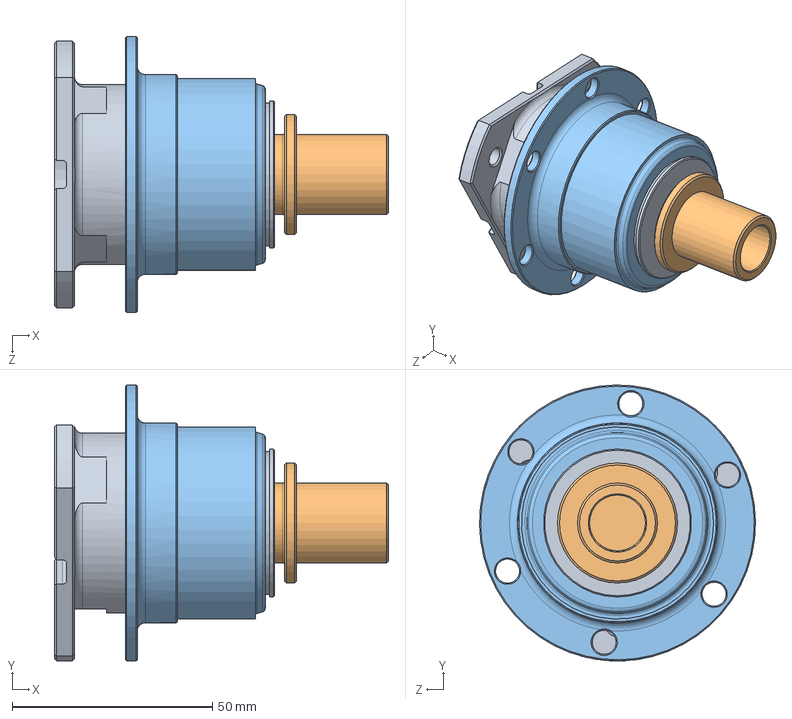
[picture p167: CAD file, 2017-11-24]
Steering System/formula sae- steering mechanism/F7_QUICK-RELEASE WITH CONNECTOR1.SLDASM
83.5 x 69.0 x 69.0 mm
TE501054mozzoQR210-3d
TE501053pernoQR210-3d
TE501060boccolaQR200-3d
