salfordracing/SR-FS-17/Suspension/FS17 Suspension_/2017 Wishbone CAD/Rear Wishbone.SLDASM

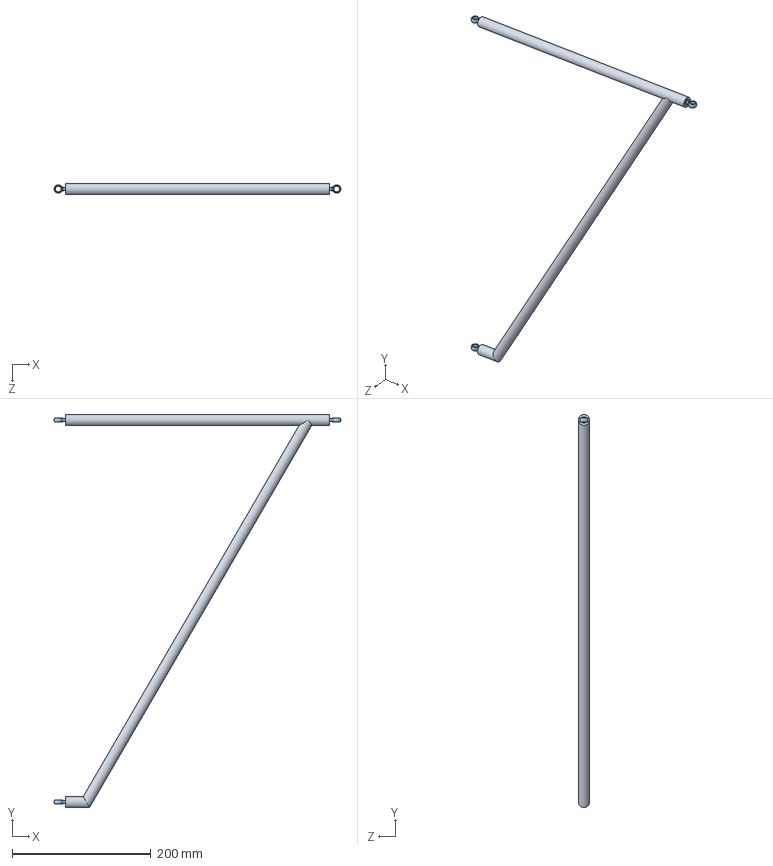
[picture p168: CAD file, 2017-11-24]
Suspension/FS17 Suspension_/2017 Wishbone CAD/Rear Wishbone.SLDASM
412.9 x 566.0 x 15.8 mm
rear wishbone
rod end screw cap x 3
Pushrod screw x 3
