salfordracing/SR-FS-17/2017 vehicle design/OZ Al 7x13 Wheel.SLDPRT

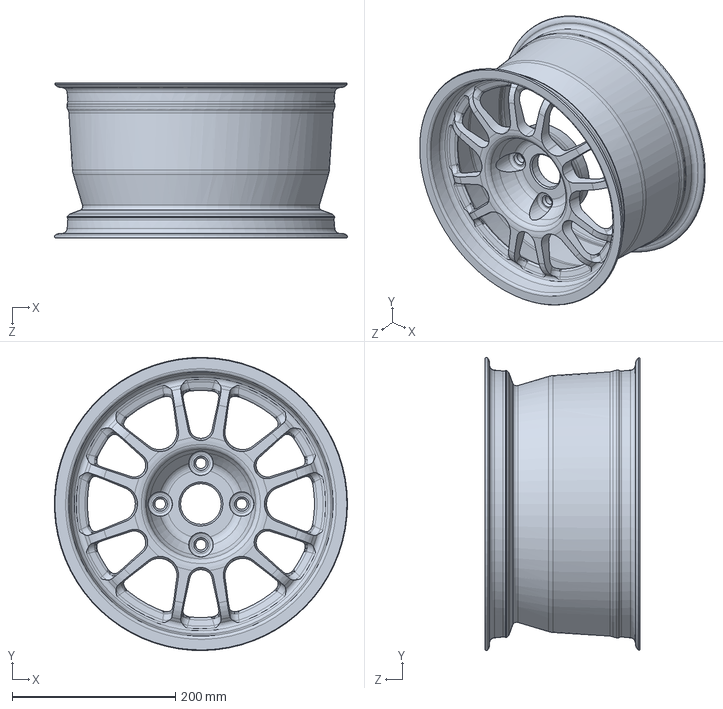
[picture p169: CAD file, 2017-11-24]
2017 vehicle design/OZ Al 7x13 Wheel.SLDPRT
359.5 x 359.6 x 190.6 mm
