salfordracing/SR-FS-17/2017 vehicle design/Pedal Box/throttle pedal bar.SLDPRT

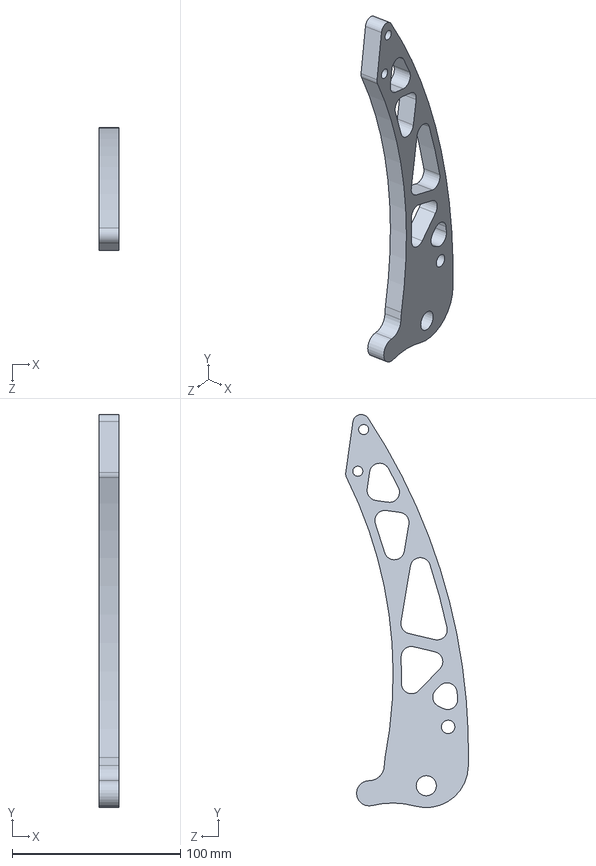
[picture p170: CAD file, 2017-11-24]
2017 vehicle design/Pedal Box/throttle pedal bar.SLDPRT
12.0 x 233.7 x 72.9 mm
