salfordracing/SR-FS-17/Assembly/FInal Assembly (Don't Touch)/Assembly/Chassis/seat v5.SLDPRT

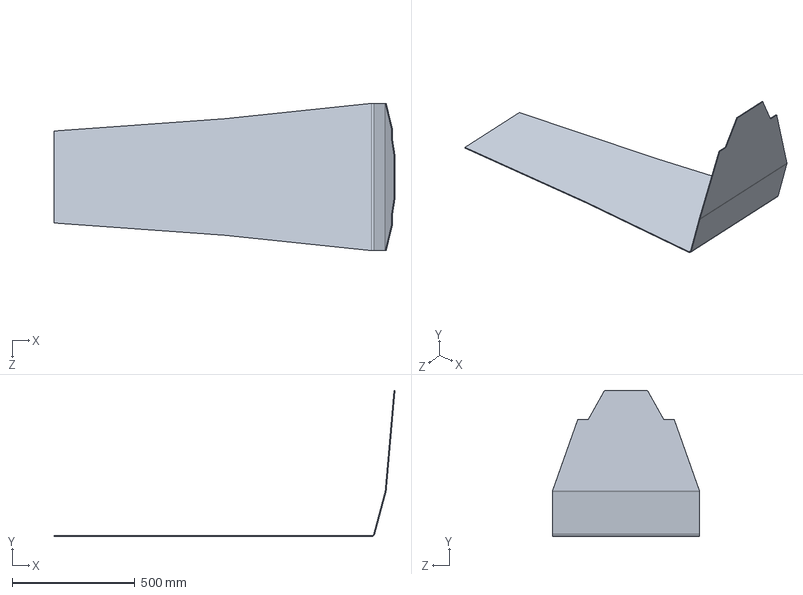
[picture p171: CAD file, 2017-11-24]
Assembly/FInal Assembly (Don't Touch)/Assembly/Chassis/seat v5.SLDPRT
1390.6 x 596.8 x 600.0 mm
