salfordracing/SR-FS-17/Assembly/FInal Assembly (Don't Touch)/Assembly/Pedal box so far due to solidworks being a mess/din_en_iso2010_m5x45_4_8.SLDPRT

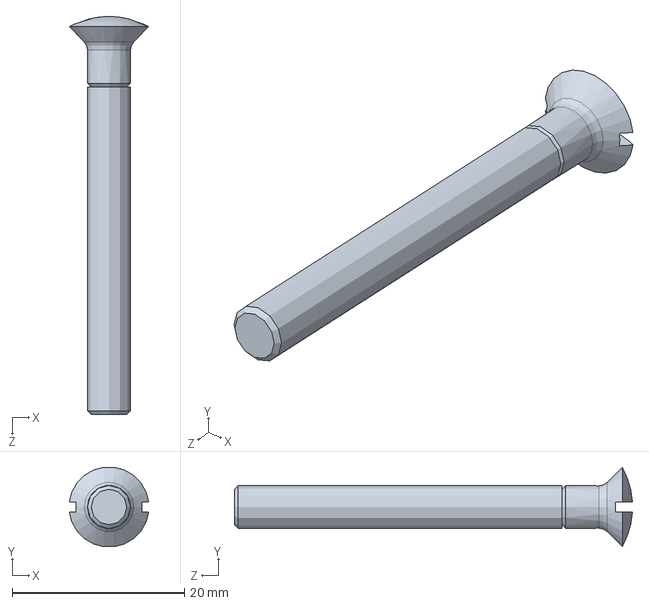
[picture p172: CAD file, 2017-11-24]
Assembly/FInal Assembly (Don't Touch)/Assembly/Pedal box so far due to solidworks being a mess/din_en_iso2010_m5x45_4_8.SLDPRT
9.22 x 9.22 x 46.2 mm
