salfordracing/SR-FS-17/Assembly/FInal Assembly (Don't Touch)/Assembly/Pedal box so far due to solidworks being a mess/drive-download-20170208T124512Z/bracket1.SLDPRT

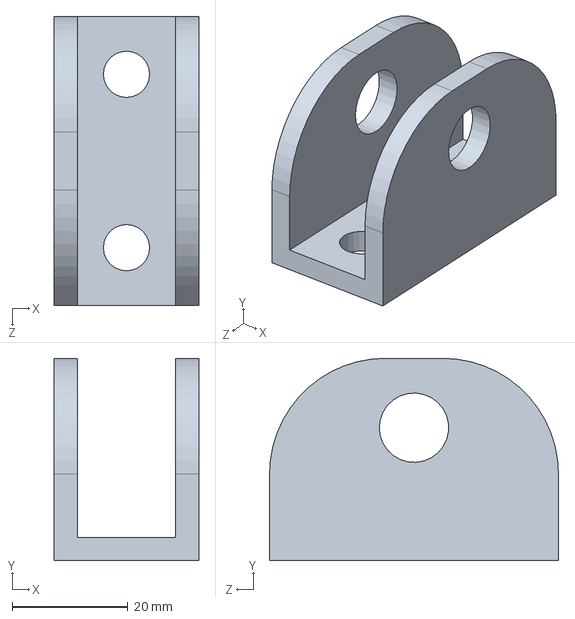
[picture p173: CAD file, 2017-11-24]
Assembly/FInal Assembly (Don't Touch)/Assembly/Pedal box so far due to solidworks being a mess/drive-download-20170208T124512Z/bracket1.SLDPRT
25.0 x 35.0 x 50.0 mm
