salfordracing/SR-FS-17/Assembly/FInal Assembly (Don't Touch)/Assembly/Steering/steering shaft - 2.SLDPRT

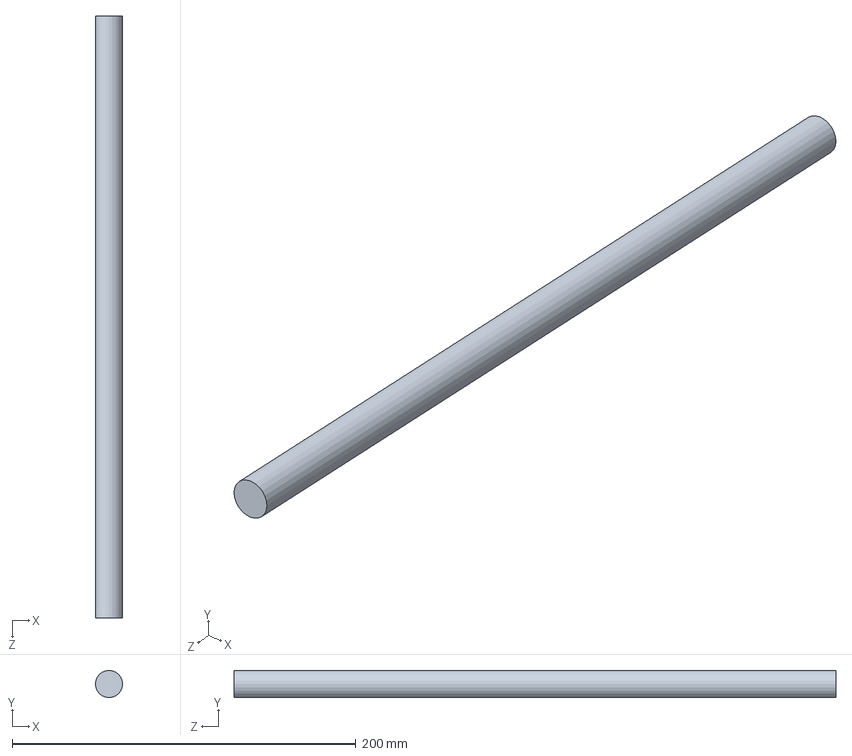
[picture p174: CAD file, 2017-11-24]
Assembly/FInal Assembly (Don't Touch)/Assembly/Steering/steering shaft - 2.SLDPRT
15.8 x 15.8 x 350.0 mm
