salfordracing/SR-FS-17/Assembly/FInal Assembly (Don't Touch)/Assembly/Suspension/fsae-front-hub/FSAE FRONT HUB.SLDPRT

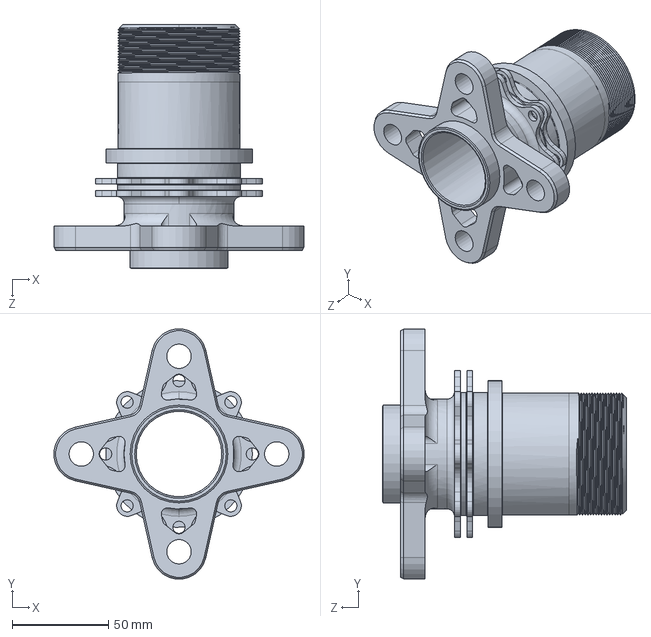
[picture p175: CAD file, 2017-11-24]
Assembly/FInal Assembly (Don't Touch)/Assembly/Suspension/fsae-front-hub/FSAE FRONT HUB.SLDPRT
130.0 x 130.0 x 127.0 mm
