salfordracing/SR-FS-17/Assembly/FInal Assembly (Don't Touch)/Assembly/Suspension/fsae-rear-hub/FSAE REAR HUB.IGS

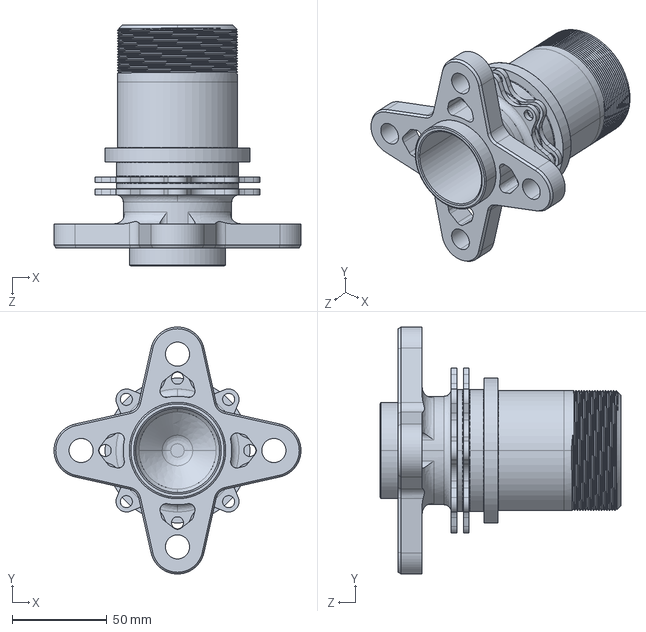
[picture p176: CAD file, 2017-11-24]
Assembly/FInal Assembly (Don't Touch)/Assembly/Suspension/fsae-rear-hub/FSAE REAR HUB.IGS
130.2 x 130.2 x 127.0 mm
