salfordracing/SR-FS-17/Assembly/FInal Assembly (Don't Touch)/Assembly/Wheels and Tyres/HUB-PROTOTYPE.SLDPRT

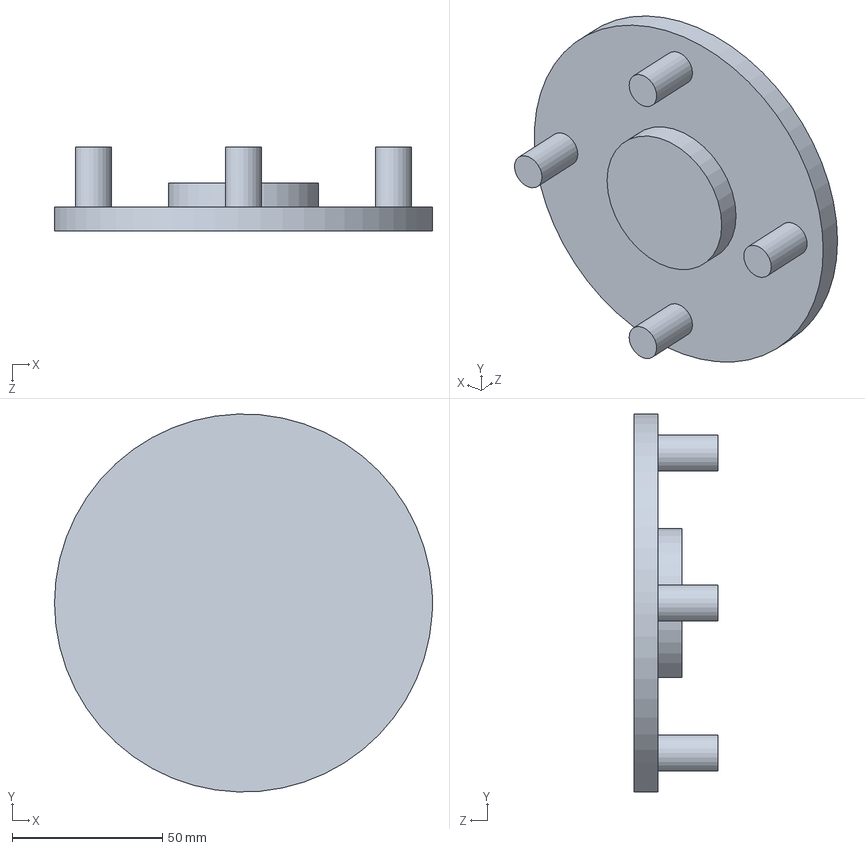
[picture p177: CAD file, 2017-11-24]
Assembly/FInal Assembly (Don't Touch)/Assembly/Wheels and Tyres/HUB-PROTOTYPE.SLDPRT
126.0 x 125.9 x 28.0 mm
