salfordracing/SR-FS-17/CAD_/Kart Seat.SLDPRT

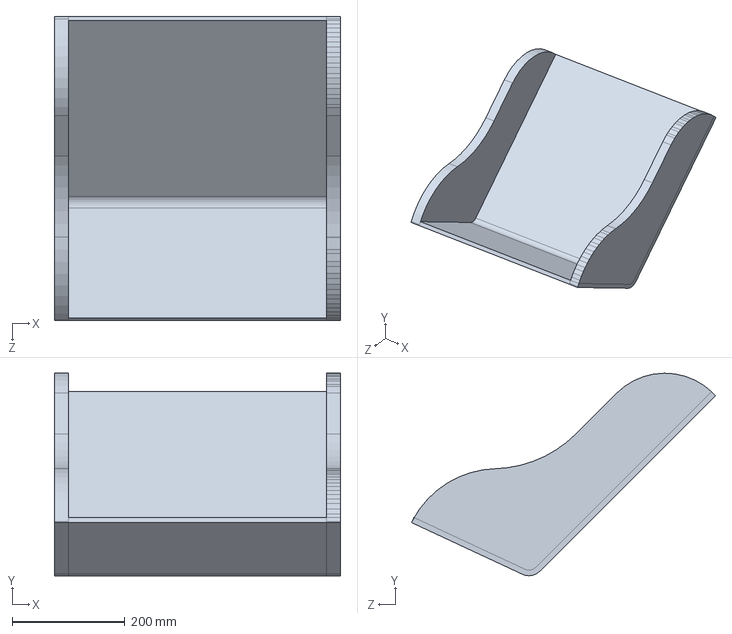
[picture p178: CAD file, 2017-11-24]
CAD_/Kart Seat.SLDPRT
507.2 x 359.3 x 539.1 mm
