salfordracing/SR-FS-17/CAD_/Pedal box so far due to solidworks being a mess/drive-download-20170208T124512Z/brake pedal bar2.SLDPRT

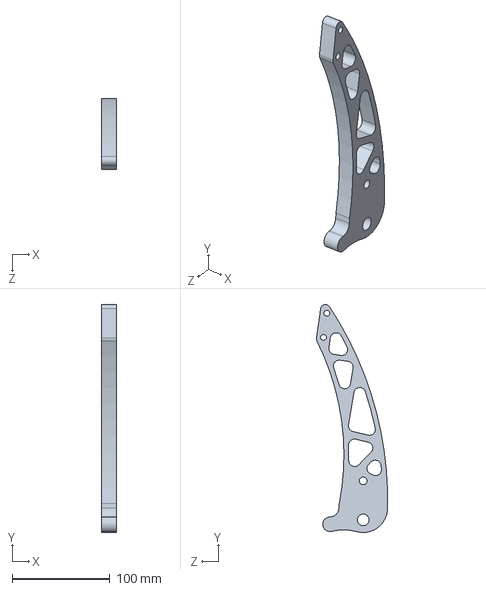
[picture p179: CAD file, 2017-11-24]
CAD_/Pedal box so far due to solidworks being a mess/drive-download-20170208T124512Z/brake pedal bar2.SLDPRT
15.0 x 233.7 x 72.9 mm
