salfordracing/SR-FS-17/FS16/CAD/FS16-CHS-CP11-01 Chassis CAD Model.SLDPRT

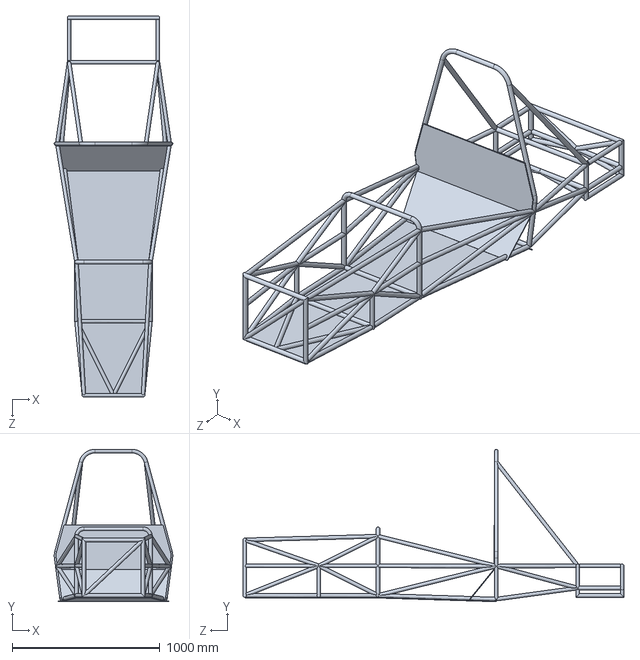
[picture p181: CAD file, 2017-11-24]
FS16/CAD/FS16-CHS-CP11-01 Chassis CAD Model.SLDPRT
801.4 x 1030.0 x 2575.0 mm
