salfordracing/SR-FS-17/Steering System/Steering mechansim parts and drawings/bushing.SLDPRT

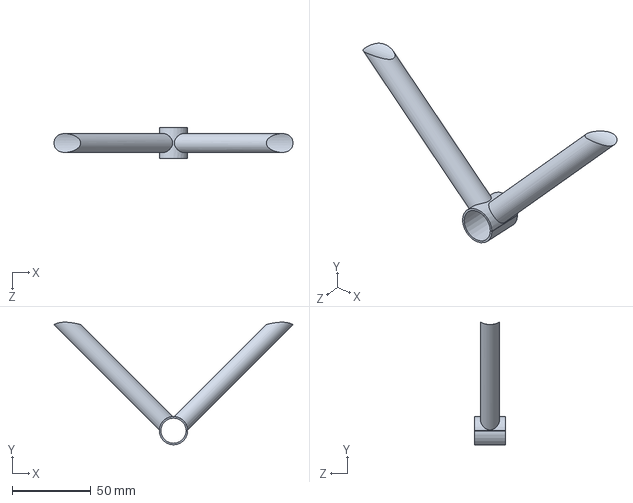
[picture p182: CAD file, 2017-11-24]
Steering System/Steering mechansim parts and drawings/bushing.SLDPRT
151.8 x 77.9 x 20.0 mm
