salfordracing/SR-FS-17/Suspension/FS17 Suspension_/2017 Wishbone CAD/UPRIGHT_FRONT_RIGHT.SLDPRT

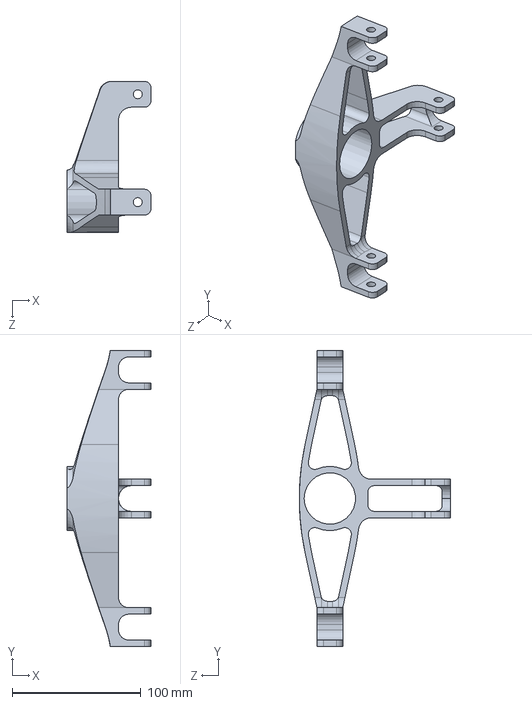
[picture p183: CAD file, 2017-11-24]
Suspension/FS17 Suspension_/2017 Wishbone CAD/UPRIGHT_FRONT_RIGHT.SLDPRT
65.3 x 230.1 x 117.7 mm
