salfordracing/SR-FS-17/Suspension/FS18 Suspension/2018 Wishbone CAD/Version 1/Parts/300mm wishbone arms.SLDPRT

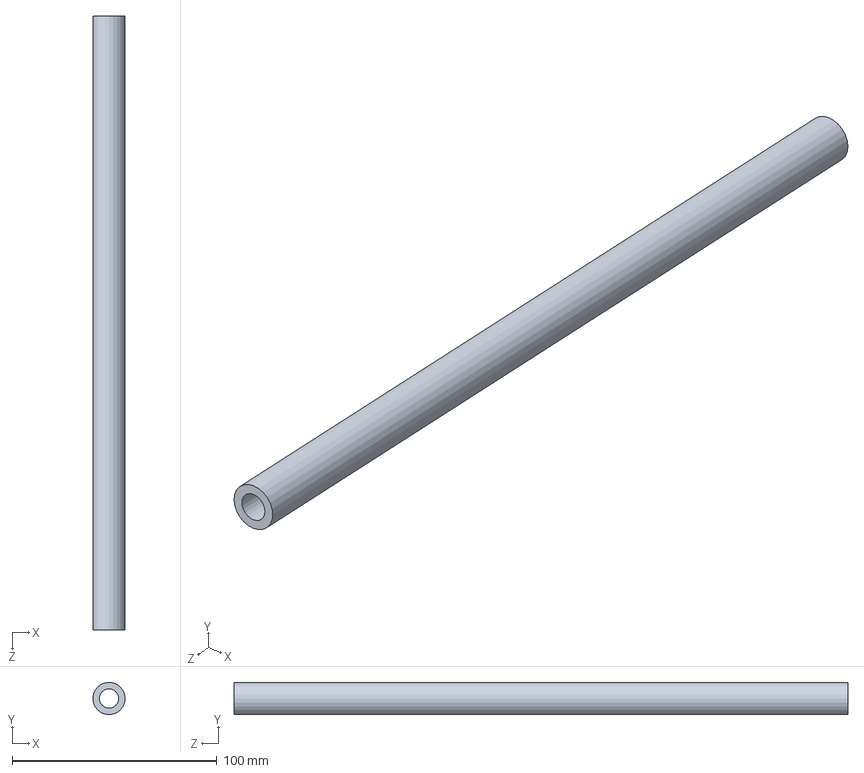
[picture p184: CAD file, 2017-11-24]
Suspension/FS18 Suspension/2018 Wishbone CAD/Version 1/Parts/300mm wishbone arms.SLDPRT
15.8 x 15.8 x 300.0 mm
