salfordracing/SR-FS-17/2017 vehicle design/Pedal Box/throttle link holder.SLDPRT

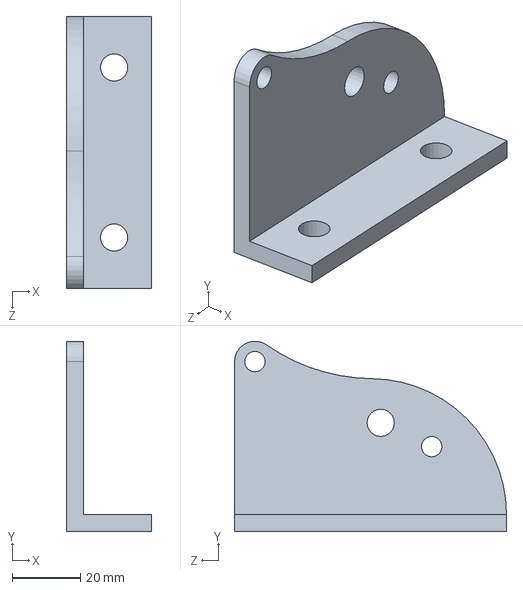
[picture p185: CAD file, 2017-11-24]
2017 vehicle design/Pedal Box/throttle link holder.SLDPRT
25.0 x 56.0 x 80.0 mm
