salfordracing/SR-FS-17/Assembly/FInal Assembly (Don't Touch)/Assembly/Chassis/Chassis With Mounts February 2017.SLDPRT

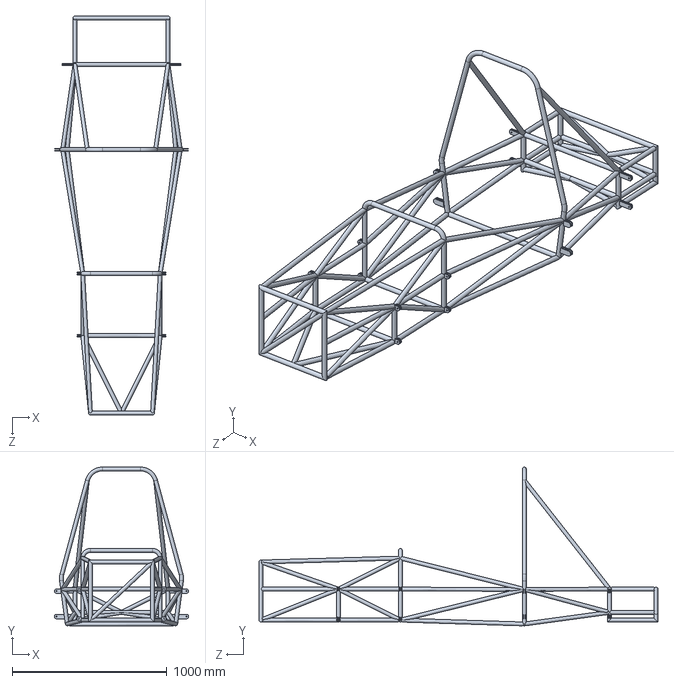
[picture p186: CAD file, 2017-11-24]
Assembly/FInal Assembly (Don't Touch)/Assembly/Chassis/Chassis With Mounts February 2017.SLDPRT
867.3 x 1025.0 x 2575.0 mm
