salfordracing/SR-FS-17/Assembly/FInal Assembly (Don't Touch)/Assembly/Pedal box so far due to solidworks being a mess/drive-download-20170208T124512Z/master cylinder_plunge.SLDPRT

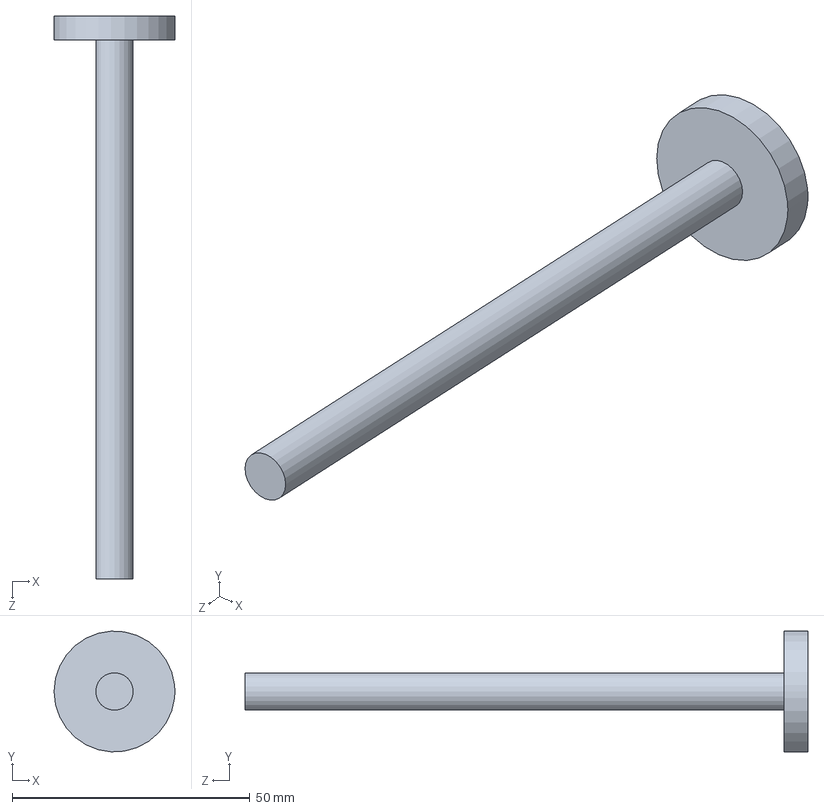
[picture p187: CAD file, 2017-11-24]
Assembly/FInal Assembly (Don't Touch)/Assembly/Pedal box so far due to solidworks being a mess/drive-download-20170208T124512Z/master cylinder_plunge.SLDPRT
25.4 x 25.4 x 118.3 mm
