salfordracing/SR-FS-17/CAD_/Pedal box so far due to solidworks being a mess/Base.SLDPRT

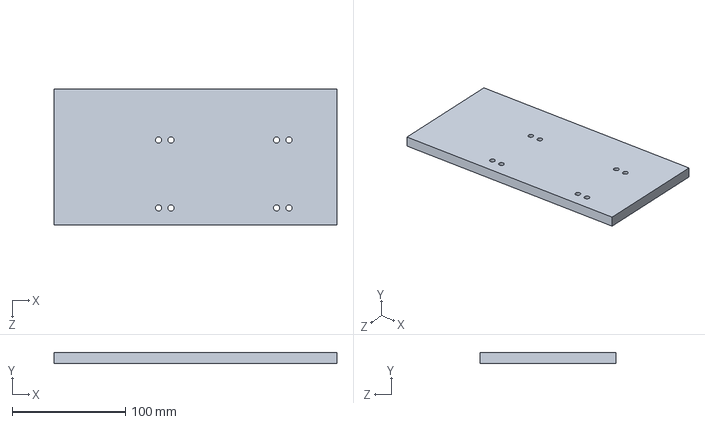
[picture p188: CAD file, 2017-11-24]
CAD_/Pedal box so far due to solidworks being a mess/Base.SLDPRT
250.0 x 10.0 x 120.0 mm
