salfordracing/SR-FS-17/Chassis designs/Callum's Chassis Designs/3D Model.SLDPRT

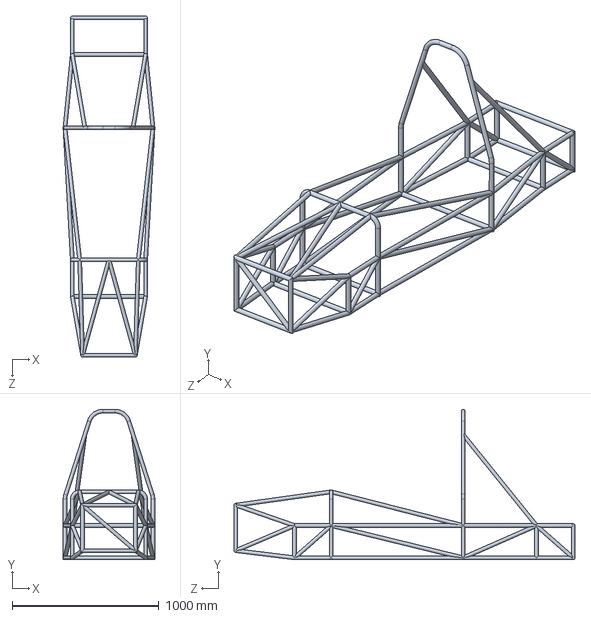
[picture p189: CAD file, 2017-11-24]
Chassis designs/Callum's Chassis Designs/3D Model.SLDPRT
625.4 x 1025.4 x 2325.4 mm
