salfordracing/SR-FS-17/Chassis designs/Chassis Jan 2017.SLDPRT

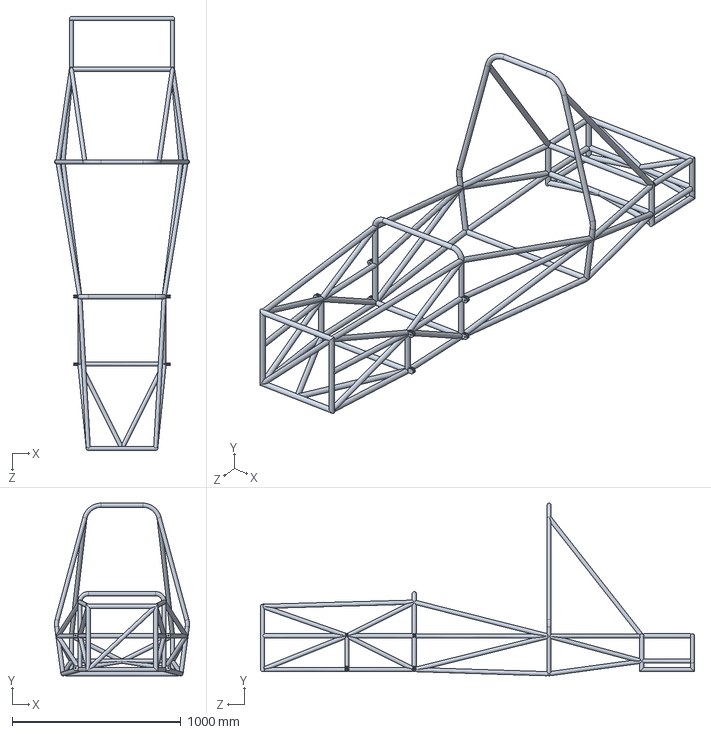
[picture p190: CAD file, 2017-11-24]
Chassis designs/Chassis Jan 2017.SLDPRT
801.4 x 1025.0 x 2575.0 mm
