salfordracing/SR-FS-17/FS-17-0009-H Project Break Down Impact Attenuator/FS-17-000-MS-00004-AA.SLDPRT

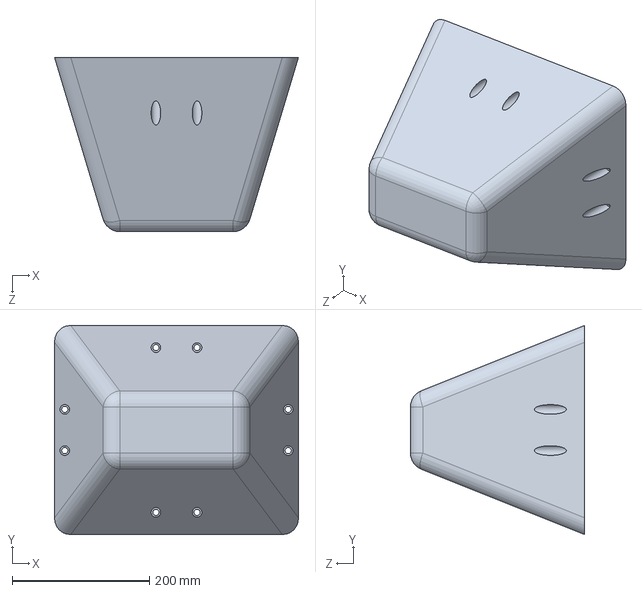
[picture p191: CAD file, 2017-11-24]
FS-17-0009-H Project Break Down Impact Attenuator/FS-17-000-MS-00004-AA.SLDPRT
355.6 x 304.8 x 254.0 mm
