salfordracing/SR-FS-17/Steering System/formula sae- steering mechanism/quick release 1.SLDPRT

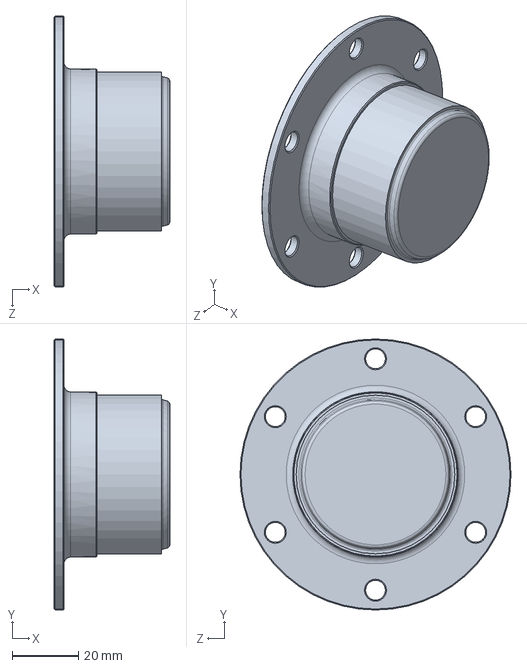
[picture p192: CAD file, 2017-11-24]
Steering System/formula sae- steering mechanism/quick release 1.SLDPRT
35.0 x 82.0 x 82.0 mm
