salfordracing/SR-FS-17/Steering System/Steering mechansim parts and drawings/new rack attachment - 2.SLDPRT

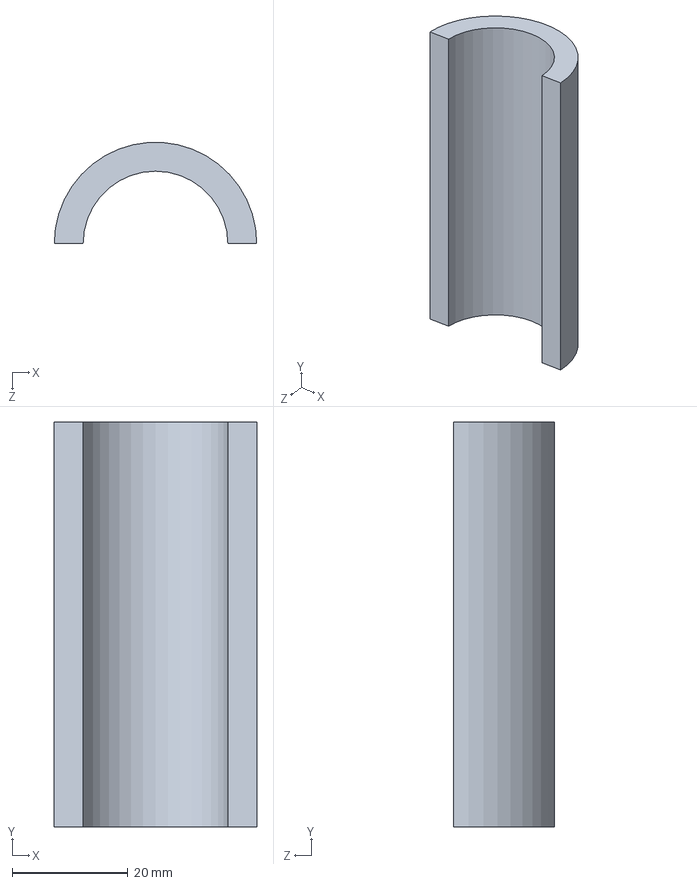
[picture p193: CAD file, 2017-11-24]
Steering System/Steering mechansim parts and drawings/new rack attachment - 2.SLDPRT
35.0 x 70.0 x 17.5 mm
