salfordracing/SR-FS-17/Suspension/FS18 Suspension/2018 Wishbone CAD/Version 1/Parts/50mm tube.SLDPRT

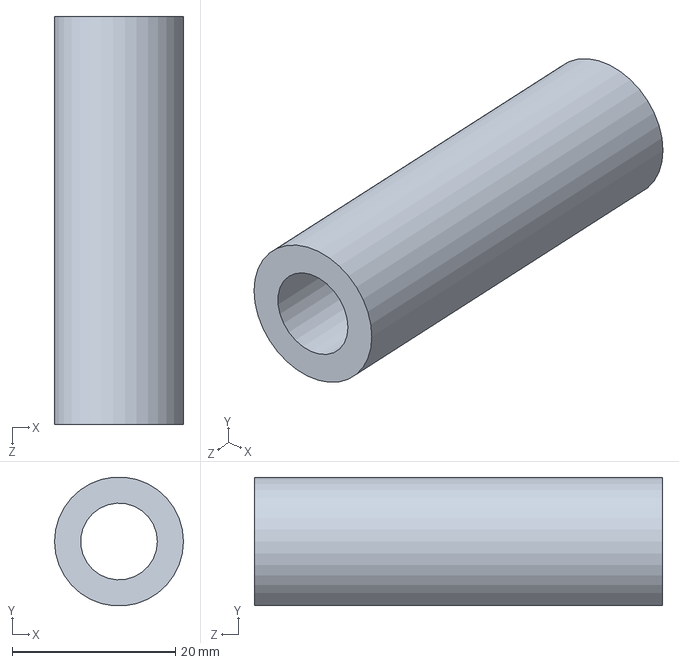
[picture p194: CAD file, 2017-11-24]
Suspension/FS18 Suspension/2018 Wishbone CAD/Version 1/Parts/50mm tube.SLDPRT
15.8 x 15.7 x 50.0 mm
