salfordracing/SR-FS-17/2017 vehicle design/Pedal Box/2017 Pedals/Pedal Box Left Rail.SLDPRT

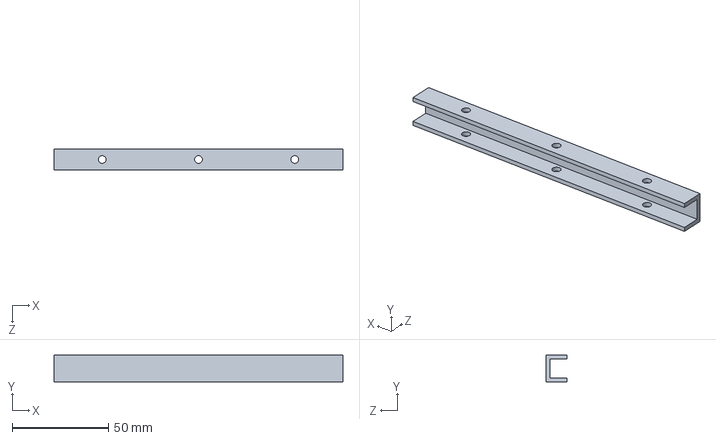
[picture p195: CAD file, 2017-11-24]
2017 vehicle design/Pedal Box/2017 Pedals/Pedal Box Left Rail.SLDPRT
150.0 x 14.0 x 11.0 mm
