salfordracing/SR-FS-17/2017 vehicle design/Pedal Box/pedal box base.SLDPRT

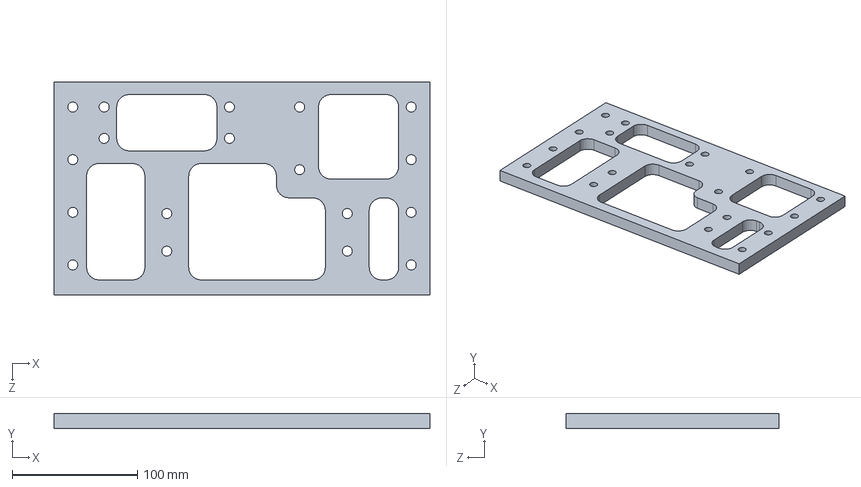
[picture p196: CAD file, 2017-11-24]
2017 vehicle design/Pedal Box/pedal box base.SLDPRT
300.0 x 12.0 x 170.0 mm
