salfordracing/SR-FS-17/Assembly/FInal Assembly (Don't Touch)/Assembly/Steering/steering wheel.SLDPRT

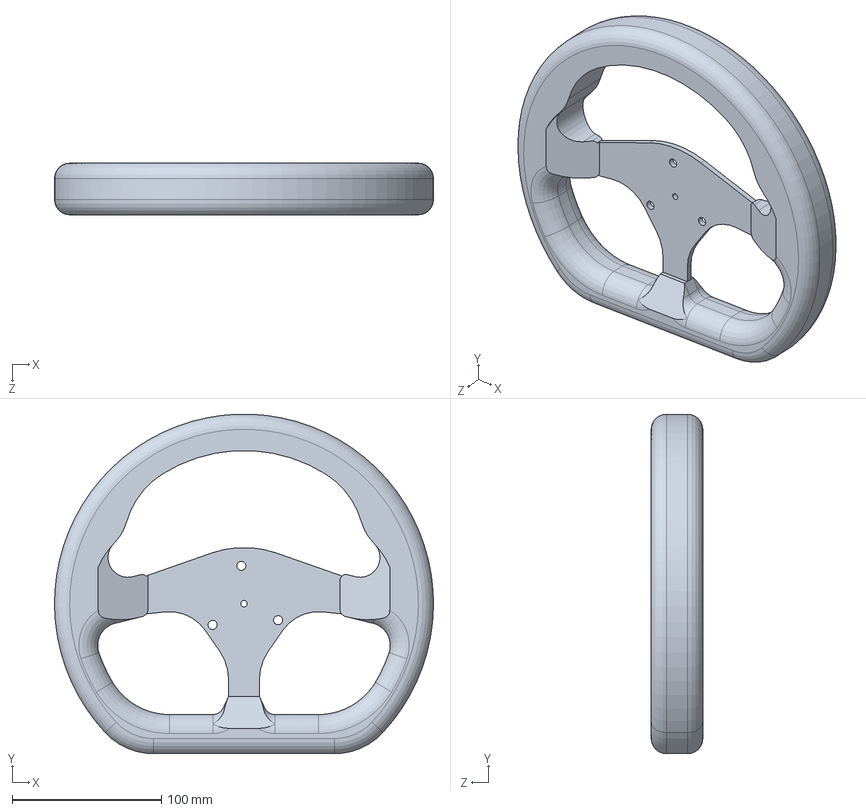
[picture p197: CAD file, 2017-11-24]
Assembly/FInal Assembly (Don't Touch)/Assembly/Steering/steering wheel.SLDPRT
254.0 x 227.5 x 34.6 mm
