salfordracing/SR-FS-17/Assembly/FInal Assembly (Don't Touch)/Assembly/Suspension/front wishbones.SLDPRT

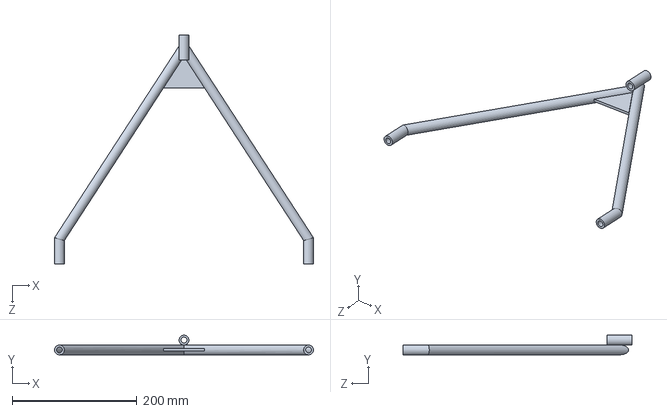
[picture p198: CAD file, 2017-11-24]
Assembly/FInal Assembly (Don't Touch)/Assembly/Suspension/front wishbones.SLDPRT
415.2 x 31.6 x 367.5 mm
