salfordracing/SR-FS-17/CAD_/Pedal box so far due to solidworks being a mess/drive-download-20170208T124512Z/brake pedal.SLDPRT

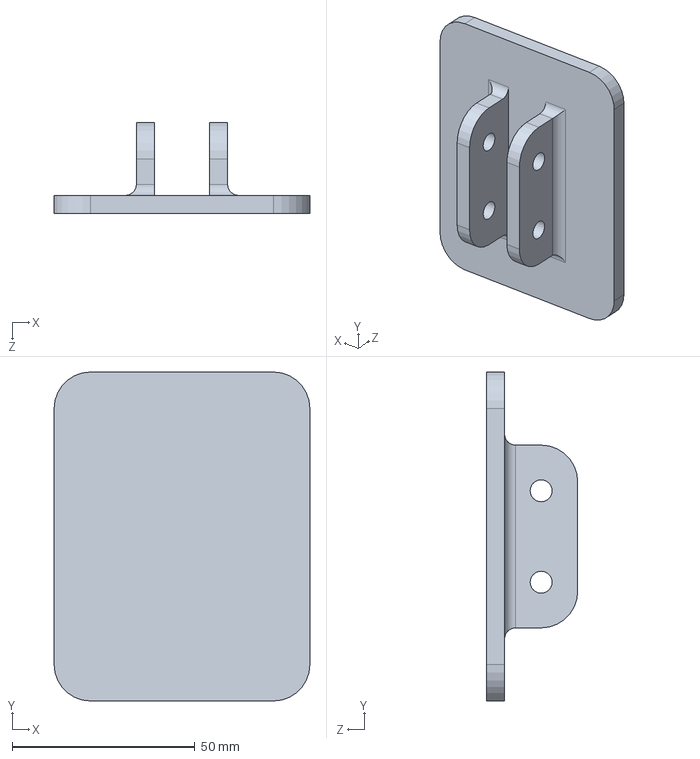
[picture p199: CAD file, 2017-11-24]
CAD_/Pedal box so far due to solidworks being a mess/drive-download-20170208T124512Z/brake pedal.SLDPRT
70.0 x 90.0 x 25.0 mm
