salfordracing/SR-FS-17/pushrod FS2017/BELL_CRANK.SLDPRT

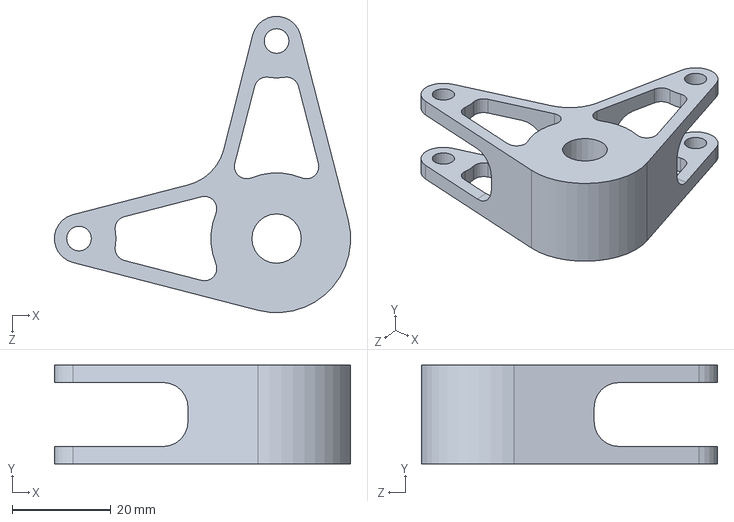
[picture p200: CAD file, 2017-11-24]
pushrod FS2017/BELL_CRANK.SLDPRT
59.9 x 20.0 x 59.9 mm
