salfordracing/SR-FS-17/Steering System/Steering mechansim parts and drawings/bushing for drawing.SLDPRT

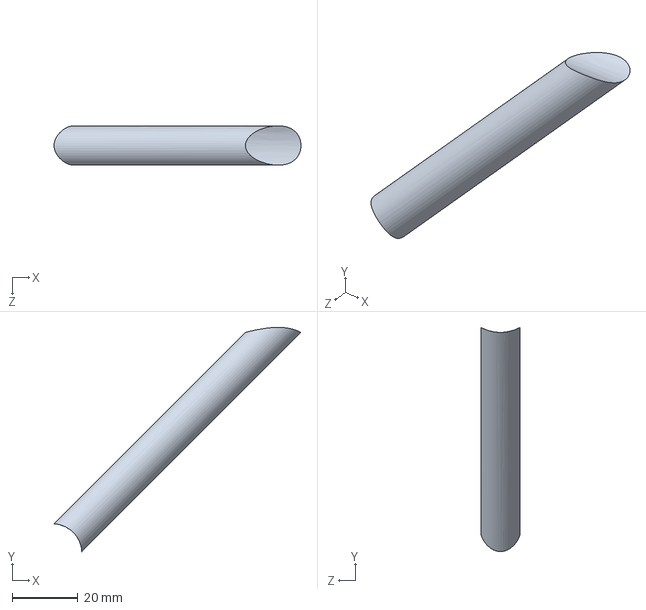
[picture p201: CAD file, 2017-11-24]
Steering System/Steering mechansim parts and drawings/bushing for drawing.SLDPRT
75.4 x 68.4 x 12.0 mm
