salfordracing/SR-FS-17/Suspension/FS18 Suspension/2018 Wishbone CAD/Version 1/Parts/Part5.SLDPRT

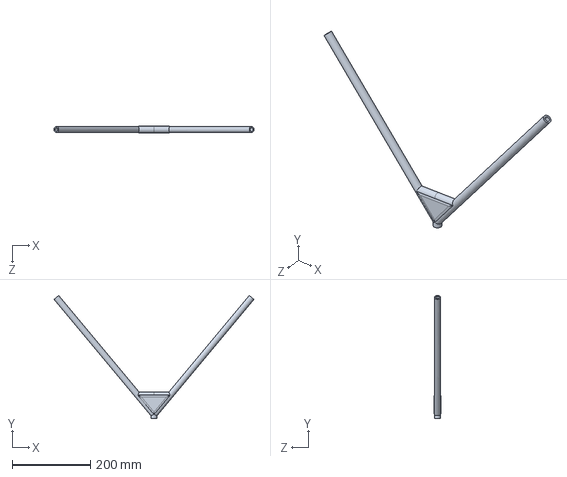
[picture p202: CAD file, 2017-11-24]
Suspension/FS18 Suspension/2018 Wishbone CAD/Version 1/Parts/Part5.SLDPRT
512.1 x 315.1 x 17.8 mm
