salfordracing/SR-FS-17/2017 vehicle design/Pedal Box/reservoir.SLDPRT

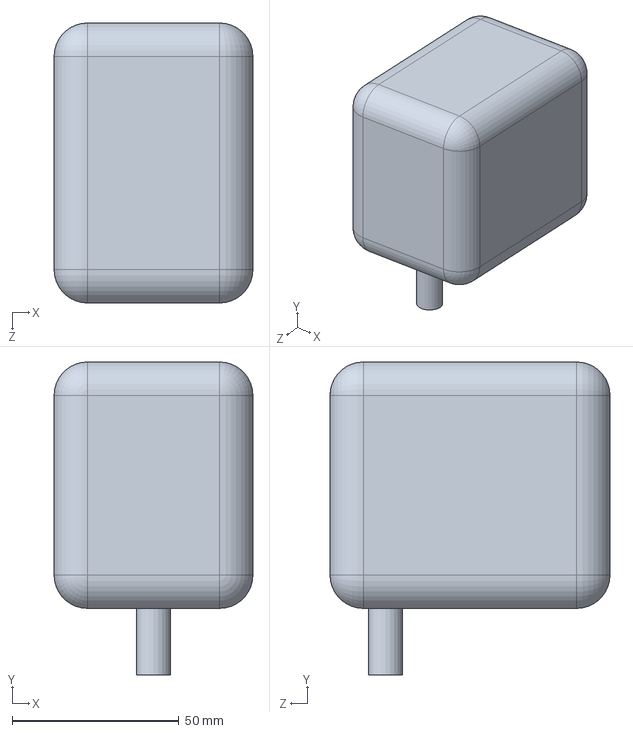
[picture p203: CAD file, 2017-11-24]
2017 vehicle design/Pedal Box/reservoir.SLDPRT
59.7 x 94.0 x 84.1 mm
