salfordracing/SR-FS-17/Assembly/FInal Assembly (Don't Touch)/Assembly/Pedal box so far due to solidworks being a mess/drive-download-20170208T124512Z/rotula2.SLDPRT

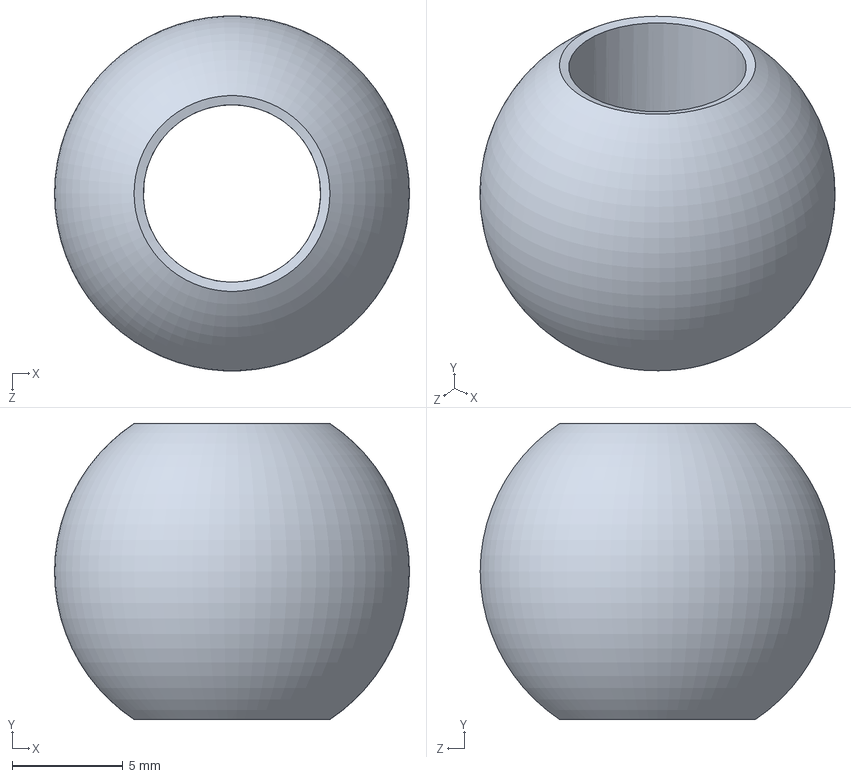
[picture p204: CAD file, 2017-11-24]
Assembly/FInal Assembly (Don't Touch)/Assembly/Pedal box so far due to solidworks being a mess/drive-download-20170208T124512Z/rotula2.SLDPRT
16.0 x 13.3 x 16.0 mm
