salfordracing/SR-FS-17/Assembly/FInal Assembly (Don't Touch)/Assembly/Suspension/UPRIGHT_REAR_RIGHT new.SLDPRT

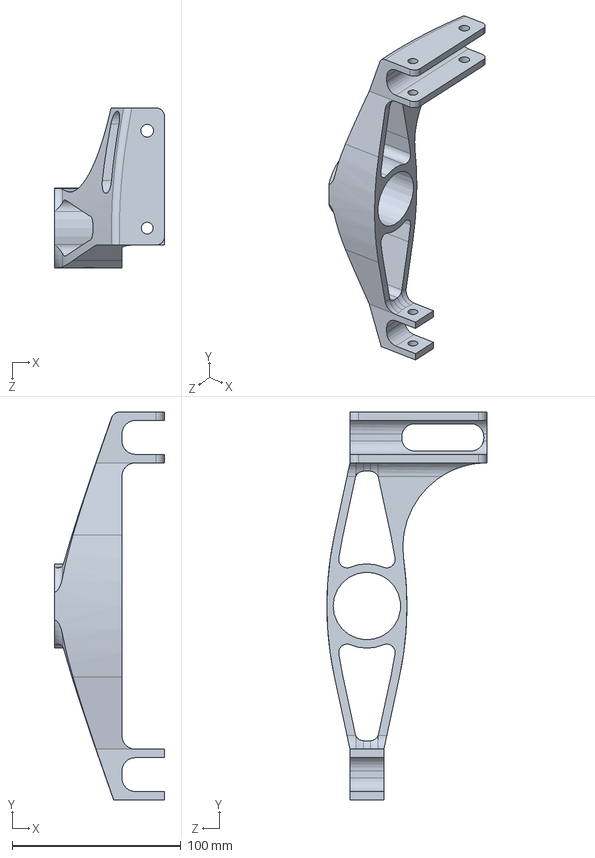
[picture p205: CAD file, 2017-11-24]
Assembly/FInal Assembly (Don't Touch)/Assembly/Suspension/UPRIGHT_REAR_RIGHT new.SLDPRT
65.3 x 230.1 x 95.0 mm
