salfordracing/SR-FS-17/FS-17-0009-H Project Break Down Impact Attenuator/FS-17-000-MS-00001-AA.SLDPRT

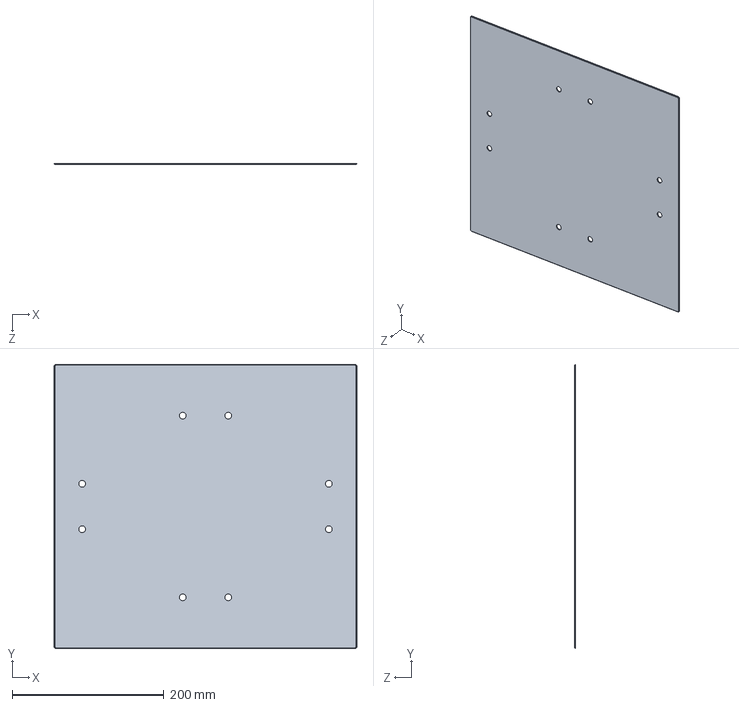
[picture p206: CAD file, 2017-11-24]
FS-17-0009-H Project Break Down Impact Attenuator/FS-17-000-MS-00001-AA.SLDPRT
400.0 x 375.0 x 1.50 mm
