salfordracing/SR-FS-17/pushrod FS2017/wishbone lower.SLDPRT

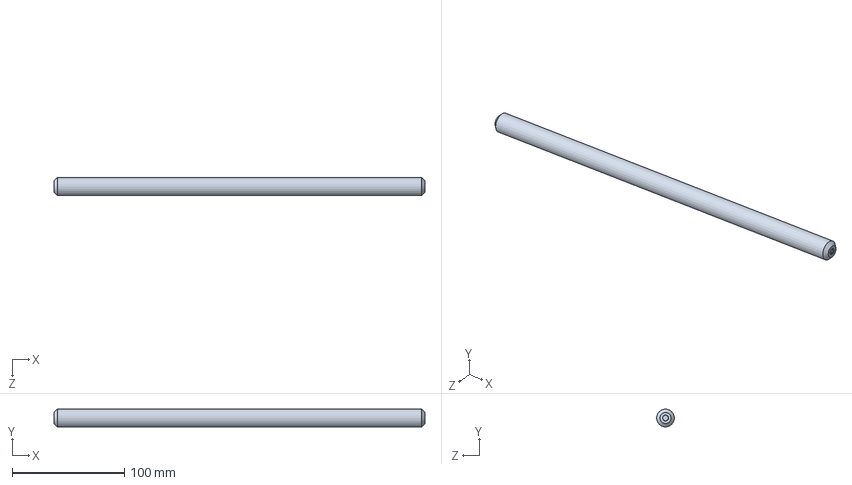
[picture p207: CAD file, 2017-11-24]
pushrod FS2017/wishbone lower.SLDPRT
330.0 x 15.9 x 15.9 mm
