salfordracing/SR-FS-17/Steering System/Steering mechansim parts and drawings/new rack attachment - 1.SLDPRT

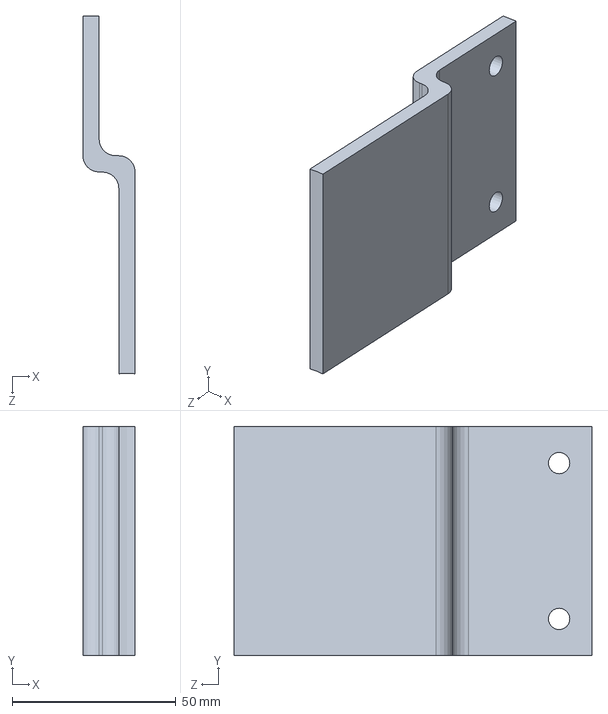
[picture p208: CAD file, 2017-11-24]
Steering System/Steering mechansim parts and drawings/new rack attachment - 1.SLDPRT
16.0 x 70.0 x 109.3 mm
