salfordracing/SR-FS-17/Suspension/FS17 Suspension_/2017 Wishbone CAD/wishbone rod.SLDPRT

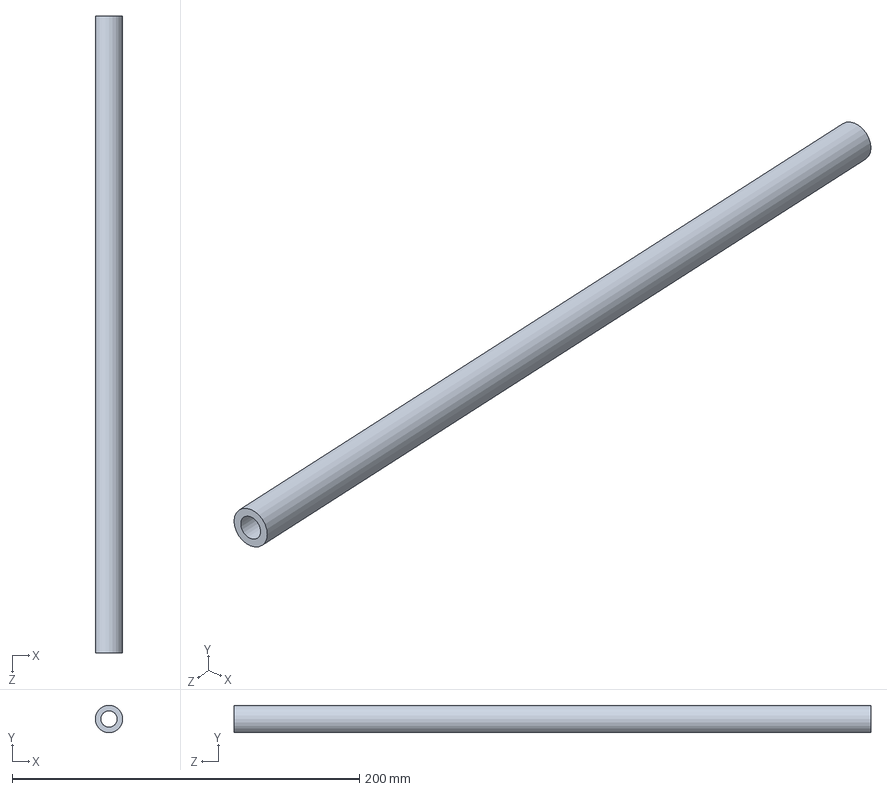
[picture p209: CAD file, 2017-11-24]
Suspension/FS17 Suspension_/2017 Wishbone CAD/wishbone rod.SLDPRT
15.8 x 15.8 x 366.7 mm
