salfordracing/SR-FS-17/Suspension/FS18 Suspension/2018 Wishbone CAD/Version 1/Parts/Wishobone-chassis end.SLDPRT

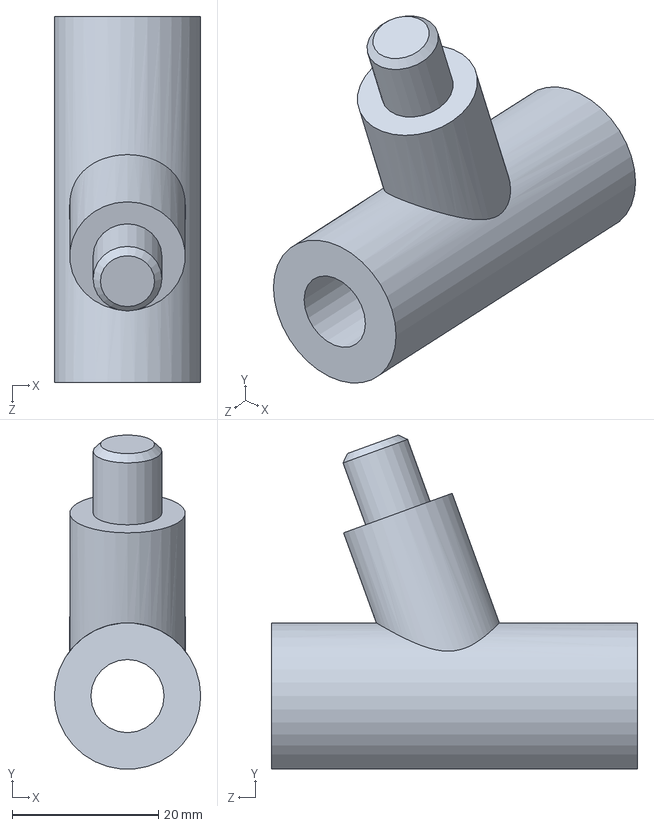
[picture p210: CAD file, 2017-11-24]
Suspension/FS18 Suspension/2018 Wishbone CAD/Version 1/Parts/Wishobone-chassis end.SLDPRT
20.0 x 45.6 x 50.0 mm
