salfordracing/SR-FS-17/Assembly/FInal Assembly (Don't Touch)/Assembly/Pedal box so far due to solidworks being a mess/drive-download-20170208T124512Z/link1.SLDPRT

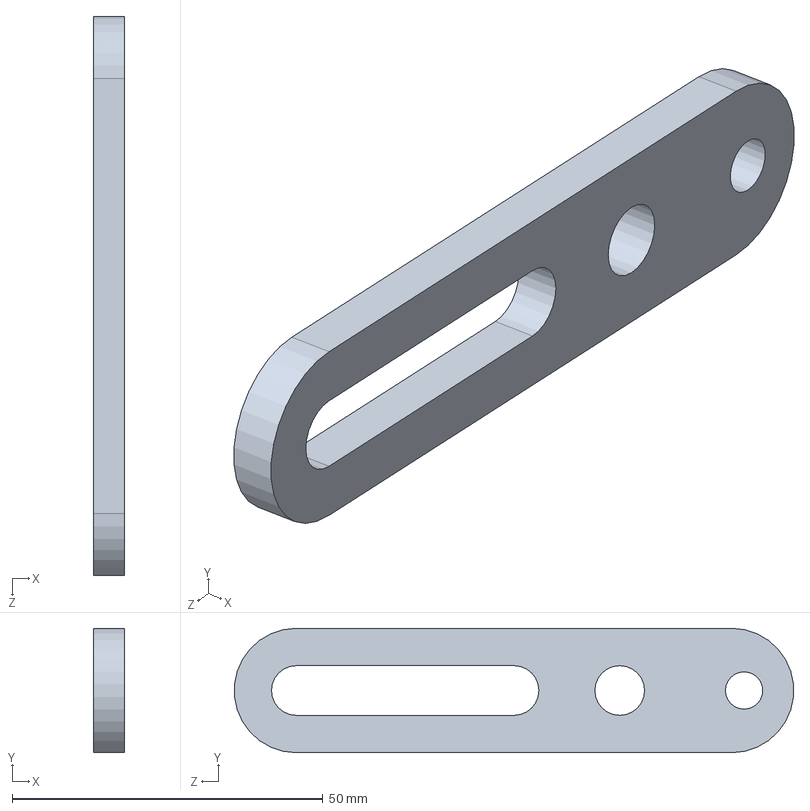
[picture p211: CAD file, 2017-11-24]
Assembly/FInal Assembly (Don't Touch)/Assembly/Pedal box so far due to solidworks being a mess/drive-download-20170208T124512Z/link1.SLDPRT
5.00 x 20.0 x 89.9 mm
