salfordracing/SR-FS-17/Assembly/FInal Assembly (Don't Touch)/Assembly/Steering/steering shaft.SLDPRT

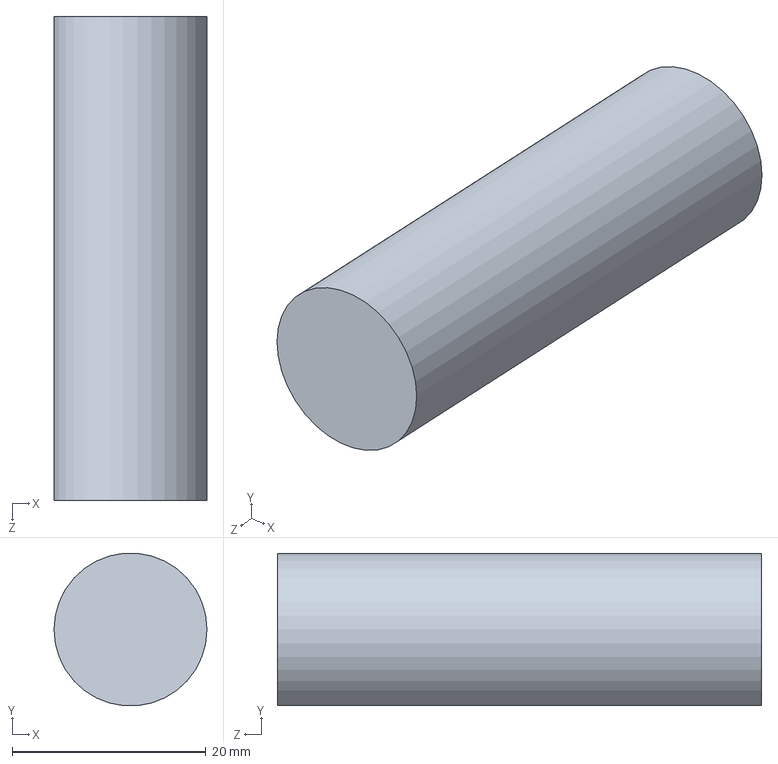
[picture p212: CAD file, 2017-11-24]
Assembly/FInal Assembly (Don't Touch)/Assembly/Steering/steering shaft.SLDPRT
15.8 x 15.7 x 50.0 mm
