salfordracing/SR-FS-17/Assembly/seat v5.SLDPRT

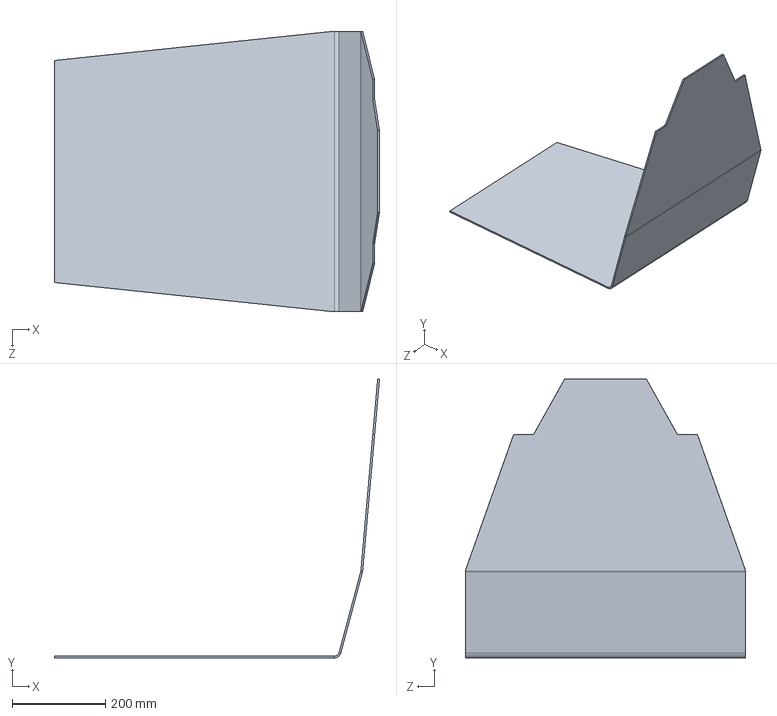
[picture p213: CAD file, 2017-11-24]
Assembly/seat v5.SLDPRT
695.3 x 596.8 x 600.0 mm
