salfordracing/SR-FS-17/CAD_/Pedal box so far due to solidworks being a mess/din_en_24017_m8x35.SLDPRT

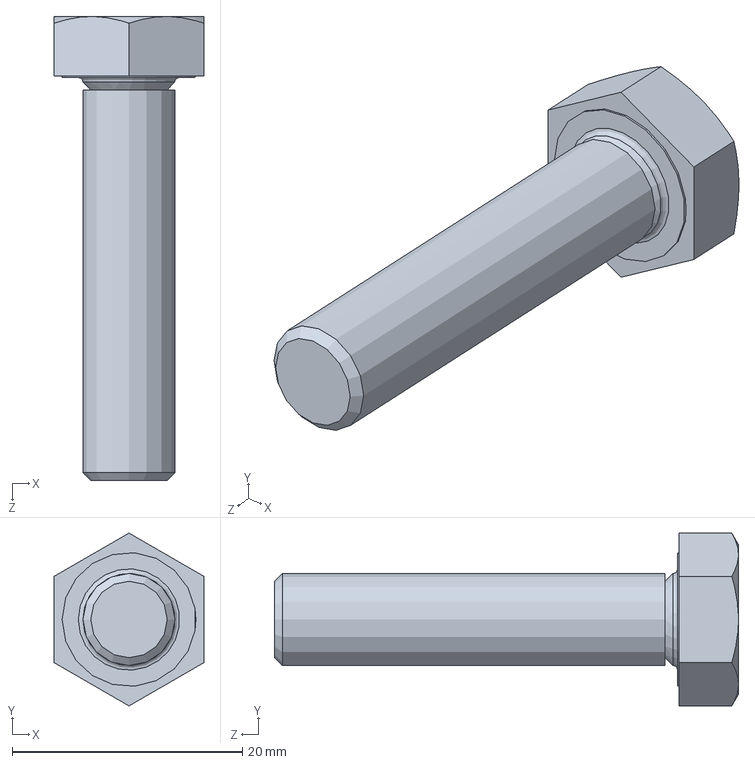
[picture p214: CAD file, 2017-11-24]
CAD_/Pedal box so far due to solidworks being a mess/din_en_24017_m8x35.SLDPRT
13.0 x 15.0 x 40.3 mm
