salfordracing/SR-FS-17/CAD_/Pedal box so far due to solidworks being a mess/drive-download-20170208T124512Z/link2.SLDPRT

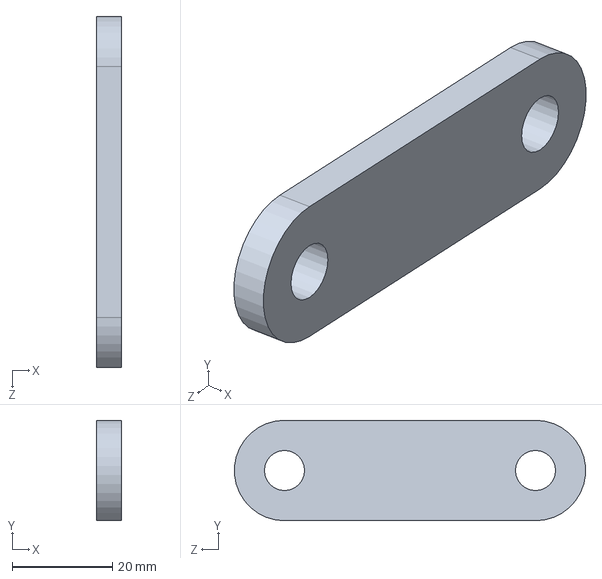
[picture p215: CAD file, 2017-11-24]
CAD_/Pedal box so far due to solidworks being a mess/drive-download-20170208T124512Z/link2.SLDPRT
5.00 x 20.0 x 69.9 mm
