salfordracing/SR-FS-17/pushrod FS2017/J1.SLDPRT

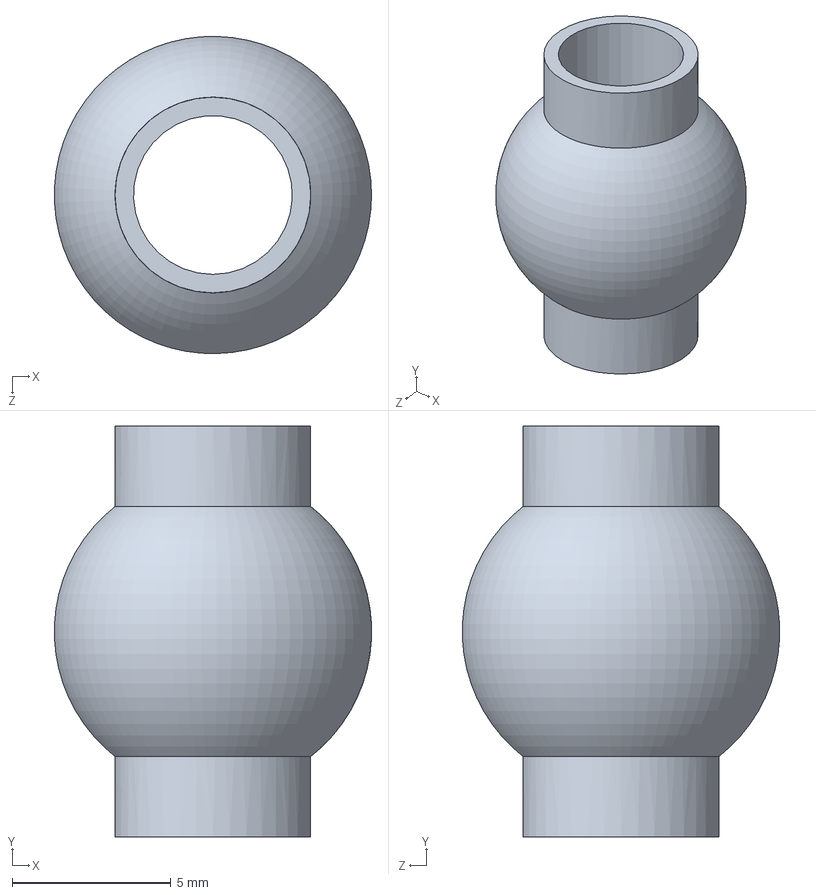
[picture p216: CAD file, 2017-11-24]
pushrod FS2017/J1.SLDPRT
9.98 x 12.9 x 9.99 mm
