salfordracing/SR-FS-17/Steering System/formula sae- steering mechanism/quick release plate attachment1.SLDPRT

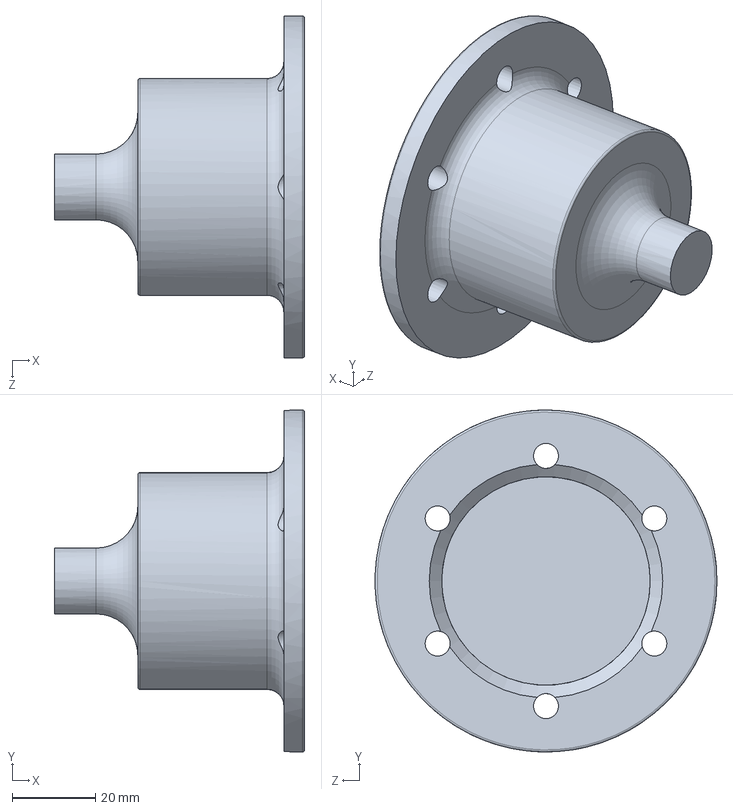
[picture p217: CAD file, 2017-11-24]
Steering System/formula sae- steering mechanism/quick release plate attachment1.SLDPRT
60.0 x 82.0 x 82.0 mm
