salfordracing/SR-FS-17/Assembly/alexfeb 2017 new.SLDPRT

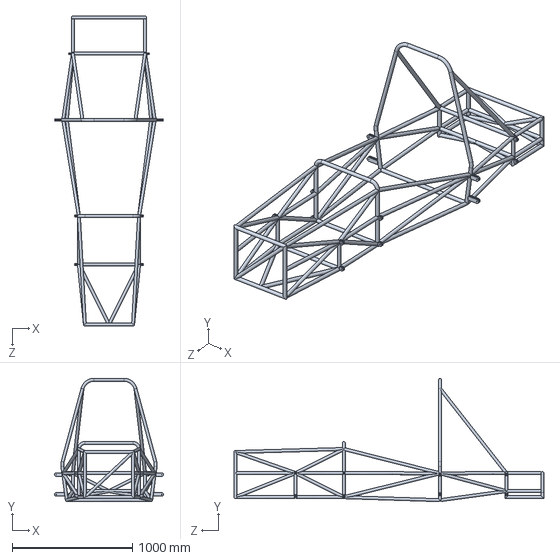
[picture p218: CAD file, 2017-11-24]
Assembly/alexfeb 2017 new.SLDPRT
907.3 x 1025.0 x 2575.0 mm
