salfordracing/SR-FS-17/Assembly/FInal Assembly (Don't Touch)/Assembly/Pedal box so far due to solidworks being a mess/Brake pedal only.SLDPRT

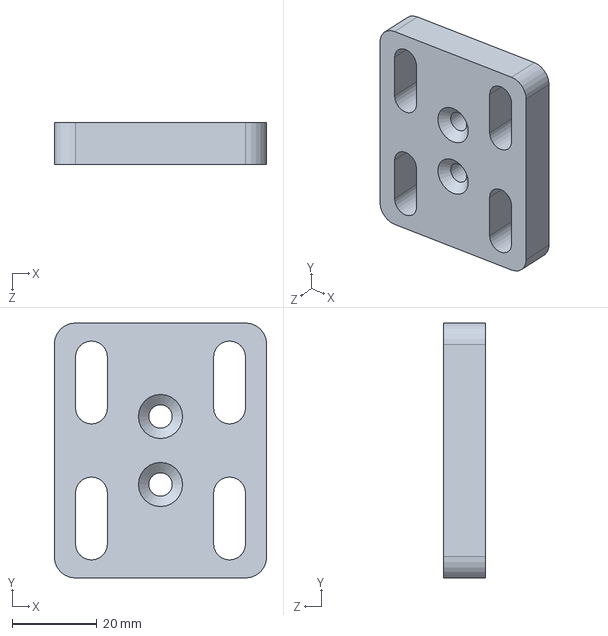
[picture p219: CAD file, 2017-11-24]
Assembly/FInal Assembly (Don't Touch)/Assembly/Pedal box so far due to solidworks being a mess/Brake pedal only.SLDPRT
50.0 x 60.0 x 10.0 mm
