salfordracing/SR-FS-17/Assembly/FInal Assembly (Don't Touch)/Assembly/Pedal box so far due to solidworks being a mess/drive-download-20170208T124512Z/rotula.SLDPRT

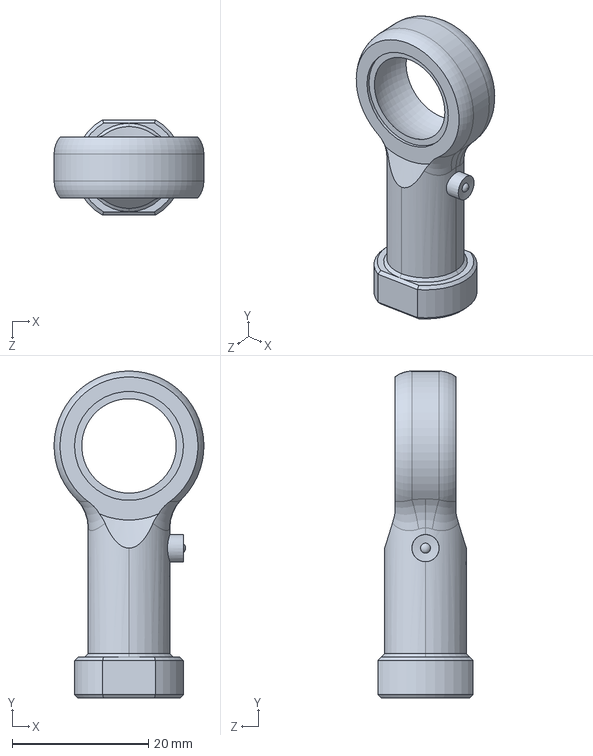
[picture p220: CAD file, 2017-11-24]
Assembly/FInal Assembly (Don't Touch)/Assembly/Pedal box so far due to solidworks being a mess/drive-download-20170208T124512Z/rotula.SLDPRT
22.0 x 48.0 x 14.0 mm
