salfordracing/SR-FS-17/CAD_/Pedal box so far due to solidworks being a mess/CYLINDER.SLDPRT

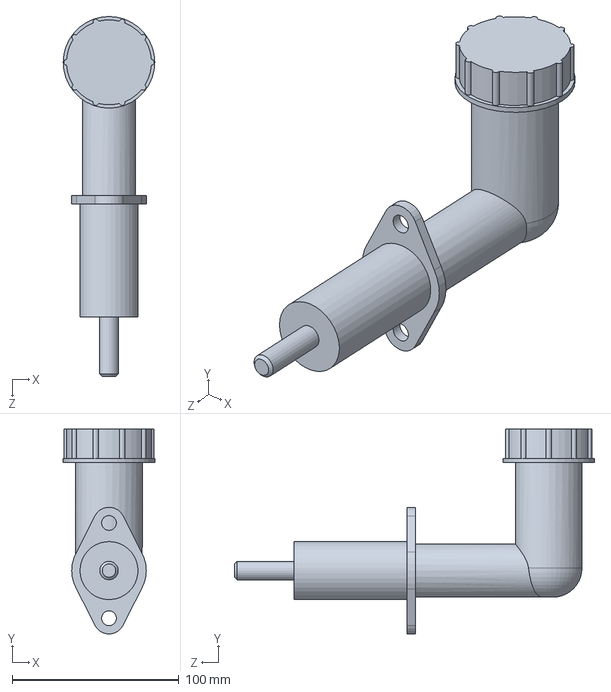
[picture p221: CAD file, 2017-11-24]
CAD_/Pedal box so far due to solidworks being a mess/CYLINDER.SLDPRT
55.0 x 122.9 x 216.1 mm
