salfordracing/SR-FS-17/FS-17-0009-H Project Break Down Impact Attenuator/FS-17-000-FS-00002-AA.SLDPRT

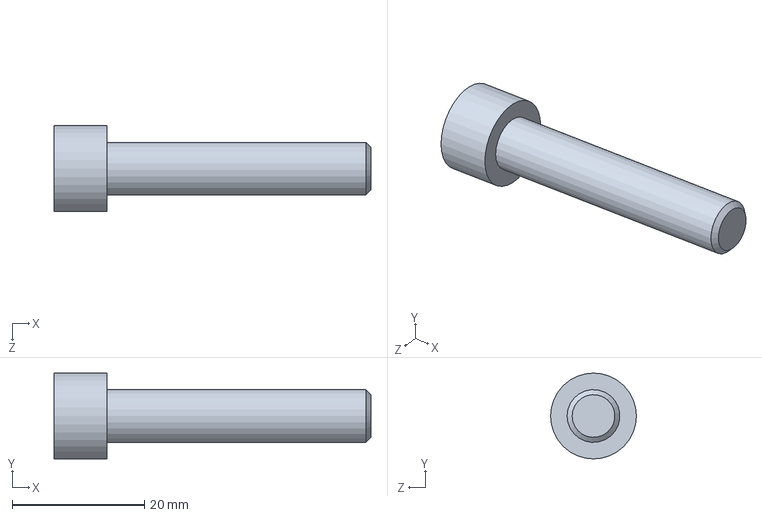
[picture p222: CAD file, 2017-11-24]
FS-17-0009-H Project Break Down Impact Attenuator/FS-17-000-FS-00002-AA.SLDPRT
48.0 x 13.0 x 13.0 mm
