salfordracing/SR-FS-17/Assembly/FInal Assembly (Don't Touch)/Assembly/Pedal box so far due to solidworks being a mess/Brake c. holder.SLDPRT

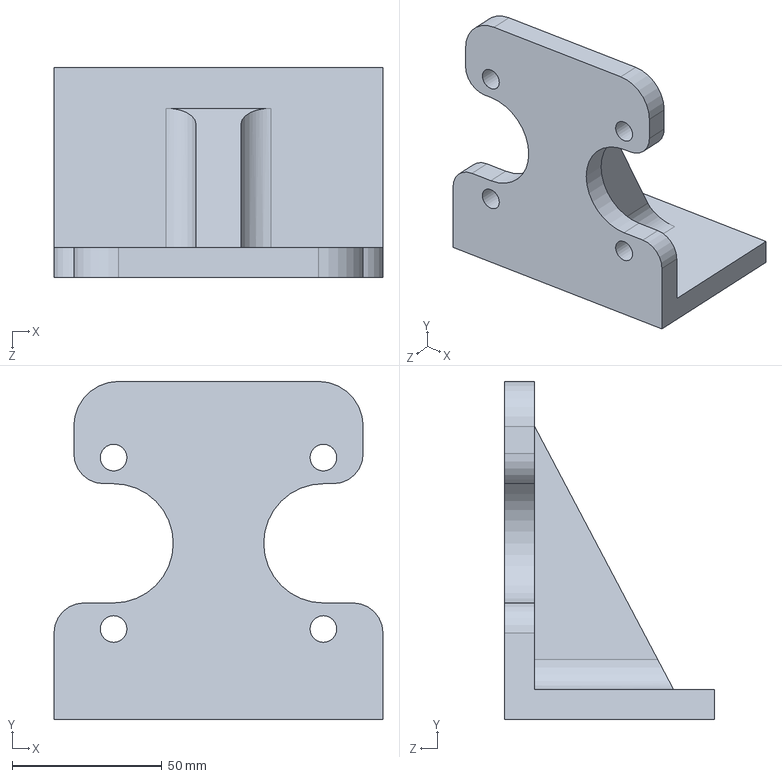
[picture p223: CAD file, 2017-11-24]
Assembly/FInal Assembly (Don't Touch)/Assembly/Pedal box so far due to solidworks being a mess/Brake c. holder.SLDPRT
109.8 x 112.9 x 70.0 mm
