salfordracing/SR-FS-17/Assembly/FInal Assembly (Don't Touch)/Assembly/Steering/rack bracket 1.SLDPRT

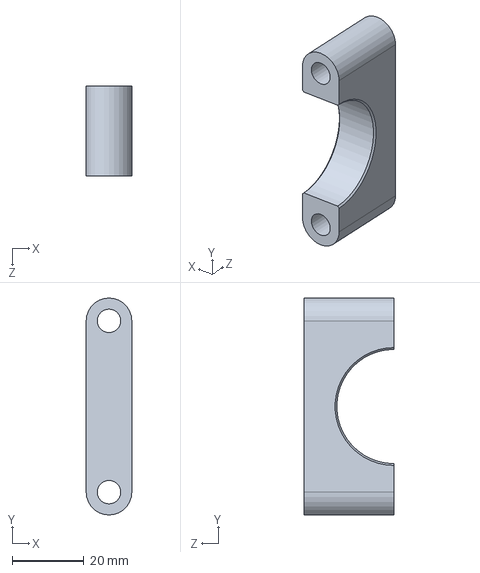
[picture p225: CAD file, 2017-11-24]
Assembly/FInal Assembly (Don't Touch)/Assembly/Steering/rack bracket 1.SLDPRT
12.7 x 60.3 x 25.0 mm
