salfordracing/SR-FS-17/Assembly/Front sus. mounts.SLDPRT

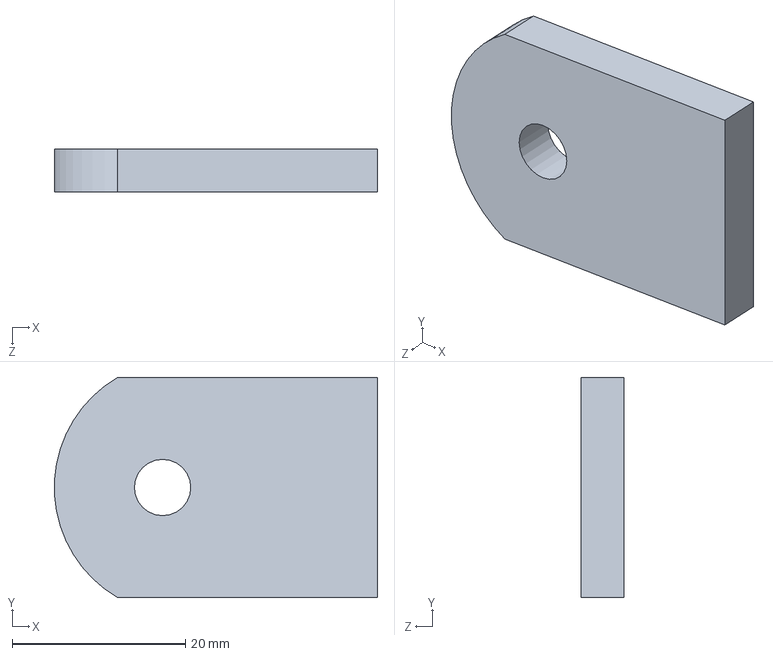
[picture p226: CAD file, 2017-11-24]
Assembly/Front sus. mounts.SLDPRT
37.3 x 25.4 x 5.00 mm
