salfordracing/SR-FS-17/FS-17-0009-H Project Break Down Impact Attenuator/FS-17-000-FS-00003-AA.SLDPRT

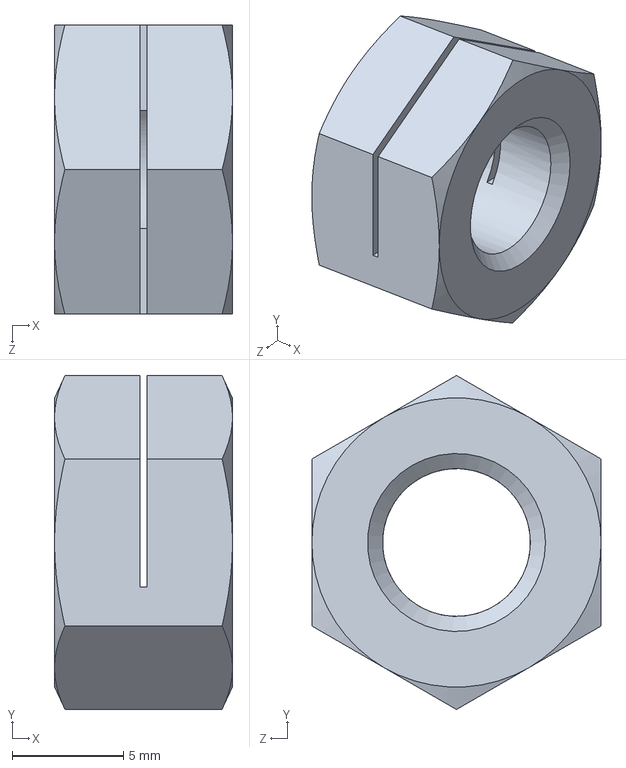
[picture p227: CAD file, 2017-11-24]
FS-17-0009-H Project Break Down Impact Attenuator/FS-17-000-FS-00003-AA.SLDPRT
8.00 x 15.0 x 13.0 mm
