salfordracing/SR-FS-17/Steering System/formula sae- steering mechanism/rack attachment part 1.SLDPRT

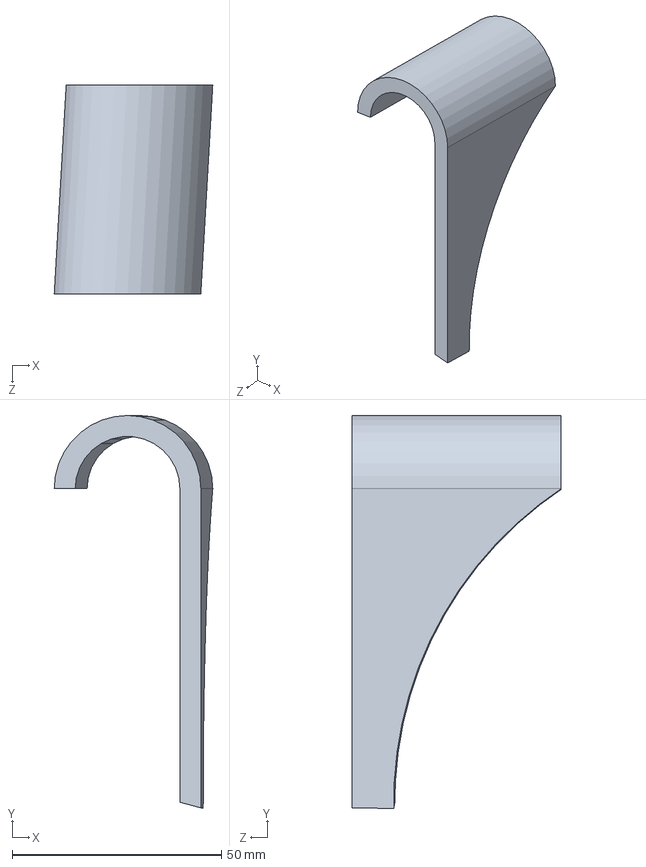
[picture p228: CAD file, 2017-11-24]
Steering System/formula sae- steering mechanism/rack attachment part 1.SLDPRT
37.9 x 93.9 x 50.0 mm
