salfordracing/SR-FS-17/2017 vehicle design/Pedal Box/2017 Pedals/Accellerator Pedal.SLDPRT

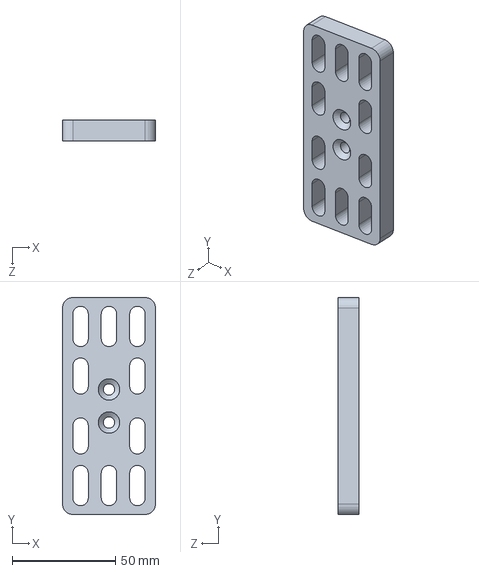
[picture p229: CAD file, 2017-11-24]
2017 vehicle design/Pedal Box/2017 Pedals/Accellerator Pedal.SLDPRT
45.0 x 105.0 x 10.0 mm
