salfordracing/SR-FS-17/(list of files, cad)

Other CAD files:
Powertrain/Driveshaft/FS17-PT-CF09-01 GKN Inner Joint/Assembly_1.sldasm
Steering System/formula sae- steering mechanism/steering attachment.SLDASM
Chassis designs/Callum's Chassis Designs/Revision 5 (Raised Nose).SLDPRT
Powertrain/Driveshaft/FS17-PT-CF09-01 GKN Inner Joint/VL1500i Disc Bar End.sldprt
Powertrain/Driveshaft/FS18-PT-CF10-02 GKN Outer Joint_/AC1700i Circlip.sldprt
Suspension/FS17 Suspension_/2017 Wishbone CAD/fsae-front-hub-1.snapshot.1/FSAE FRONT HUB.IGS
2017 vehicle design/HUB-PROTOTYPE.SLDPRT
Assembly/FInal Assembly (Don't Touch)/Assembly/Steering/Mirrorrack attachment.SLDPRT
Assembly/FInal Assembly (Don't Touch)/Assembly/Suspension/UPRIGHT_FRONT_LEFT.SLDPRT
Assembly/FInal Assembly (Don't Touch)/Assembly/Wheels and Tyres/OZ Al 7x13 Wheel.SLDPRT
CAD_/Pedal box so far due to solidworks being a mess/throttle link holder.SLDPRT
FS-17-0009-H Project Break Down Impact Attenuator/Chassis.SLDPRT
Powertrain/Driveshaft/FS17-PT-CF09-01 GKN Inner Joint/Ball_1.sldprt
Steering System/formula sae- steering mechanism/Mirrorrack attachment.SLDPRT
Suspension/FS17 Suspension_/2017 Wishbone CAD/sketch.SLDPRT
Chassis designs/Callum's Chassis Designs/Revision 7 (Update 3).SLDPRT
Powertrain/Driveshaft/FS18-PT-CF10-02 GKN Outer Joint_/AC1700i Inner Race.sldprt
Assembly/FInal Assembly (Don't Touch)/Assembly/Suspension/UPRIGHT_FRONT_RIGHT.SLDPRT
Chassis designs/Callum's Chassis Designs/Revision 6.SLDPRT
Powertrain/Driveshaft/FS17-PT-CF09-01 GKN Inner Joint/outer_1.sldprt
2017 vehicle design/Pedal Box/throttle pedal.SLDPRT
Chassis designs/Callum's Chassis Designs/Chassis Design Revision 7 (Update 6).SLDPRT
Powertrain/Driveshaft/FS17-PT-CF09-01 GKN Inner Joint/GLi1500 circlip_2.sldprt
Suspension/FS17 Suspension_/2017 Wishbone CAD/UPRIGHT_REAR_RIGHT.SLDPRT
Chassis designs/Callum's Chassis Designs/Revision 5 (Adjustable).SLDPRT
Powertrain/Driveshaft/FS17-PT-CF09-01 GKN Inner Joint/Inner_1.sldprt
CAD_/Pedal box so far due to solidworks being a mess/link1.SLDPRT
Chassis designs/Callum's Chassis Designs/Original.SLDPRT
Powertrain/Driveshaft/FS17-PT-CF09-01 GKN Inner Joint/cage_2.sldprt
pushrod FS2017/wishbone upper.SLDPRT
2017 vehicle design/HUB-PROTOTYPE.SLDDRW
2017 vehicle design/Pedal Box/2017 Pedals/Accel pedal with support and bolts.SLDPRT
2017 vehicle design/Pedal Box/2017 Pedals/Base Pedal Interface.SLDPRT
2017 vehicle design/Pedal Box/2017 Pedals/Brake pedal assembly.SLDPRT
2017 vehicle design/Pedal Box/2017 Pedals/Brake pedal with support and bolts.SLDPRT
2017 vehicle design/Pedal Box/2017 Pedals/Pedal support.SLDPRT
2017 vehicle design/Pedal Box/2017 Pedals/brake pedal.SLDPRT
Assembly/FInal Assembly (Don't Touch)/Assembly/Pedal box so far due to solidworks being a mess/Accel pedal with support and bolts.SLDPRT
Assembly/FInal Assembly (Don't Touch)/Assembly/Pedal box so far due to solidworks being a mess/Base Pedal Interface.SLDPRT
Assembly/FInal Assembly (Don't Touch)/Assembly/Pedal box so far due to solidworks being a mess/Brake pedal assembly.SLDPRT
Assembly/FInal Assembly (Don't Touch)/Assembly/Pedal box so far due to solidworks being a mess/Brake pedal with support and bolts.SLDPRT
Assembly/FInal Assembly (Don't Touch)/Assembly/Pedal box so far due to solidworks being a mess/Pedal support.SLDPRT
Assembly/FInal Assembly (Don't Touch)/Assembly/Pedal box so far due to solidworks being a mess/brake pedal.SLDPRT
Assembly/FInal Assembly (Don't Touch)/Assembly/Pedal box so far due to solidworks being a mess/drive-download-20170208T124512Z/throttle pedal.SLDPRT
Assembly/FInal Assembly (Don't Touch)/Assembly/Pedal box so far due to solidworks being a mess/link1.SLDPRT
Assembly/FInal Assembly (Don't Touch)/Assembly/Pedal box so far due to solidworks being a mess/link2.SLDPRT
Assembly/FInal Assembly (Don't Touch)/Assembly/Pedal box so far due to solidworks being a mess/throttle link holder.SLDPRT
Assembly/FInal Assembly (Don't Touch)/Assembly/Steering/59507664-7-23406-116068/23406-116068.SLDASM
Assembly/FInal Assembly (Don't Touch)/Assembly/Steering/59507664-7-23406-116068/23406-116068_01.SLDPRT
Assembly/FInal Assembly (Don't Touch)/Assembly/Steering/59507664-7-23406-116068/23406-116068_02.SLDPRT
Assembly/FInal Assembly (Don't Touch)/Assembly/Steering/59507664-7-23406-116068/23406-116068_03.SLDPRT
Assembly/FInal Assembly (Don't Touch)/Assembly/Steering/TE501053pernoQR210-3d.sldprt
Assembly/FInal Assembly (Don't Touch)/Assembly/Steering/TE501054mozzoQR210-3d.sldprt
Assembly/FInal Assembly (Don't Touch)/Assembly/Steering/TE501060boccolaQR200-3d.sldprt
Assembly/FInal Assembly (Don't Touch)/Assembly/Steering/rack attachment part 2.SLDPRT
Assembly/FInal Assembly (Don't Touch)/Assembly/Steering/rack attachment.SLDPRT
Assembly/FInal Assembly (Don't Touch)/Assembly/Steering/rack bracket 2.SLDPRT
Assembly/FInal Assembly (Don't Touch)/Assembly/Steering/steering rack.SLDPRT
Assembly/FInal Assembly (Don't Touch)/Assembly/Suspension/J1 susp.SLDPRT
Assembly/FInal Assembly (Don't Touch)/Assembly/Suspension/Pushrod screw.SLDPRT
Assembly/FInal Assembly (Don't Touch)/Assembly/Suspension/UPRIGHT_REAR_LEFT new .SLDPRT
Assembly/FInal Assembly (Don't Touch)/Assembly/Suspension/UPRIGHT_REAR_LEFT.SLDPRT
Assembly/FInal Assembly (Don't Touch)/Assembly/Suspension/UPRIGHT_REAR_RIGHT.SLDPRT
Assembly/FInal Assembly (Don't Touch)/Assembly/Suspension/fsae-front-hub/FSAE FRONT HUB.IGS
Assembly/FInal Assembly (Don't Touch)/Assembly/Suspension/rear wishbone.SLDPRT
Assembly/FInal Assembly (Don't Touch)/Assembly/Suspension/rod end screw cap assembly.SLDPRT.SLDASM
Assembly/FInal Assembly (Don't Touch)/Assembly/Suspension/rod end screw cap.SLDPRT
Assembly/Final .SLDDRW
Assembly/Final Assembly.SLDDRW
Assembly/Pushrod screw.SLDPRT
Assembly/TE501053pernoQR210-3d.sldprt
Assembly/alexfeb 2017 new mounts( still need wishbone and editing).SLDPRT
Assembly/rod end screw cap assembly.SLDPRT.SLDASM
Assembly/rod end screw cap.SLDPRT
Assembly/wishbone adjustor.SLDPRT
Assembly/wishbone rod new.SLDPRT
CAD_/Pedal box so far due to solidworks being a mess/Accel pedal with support and bolts.SLDPRT
CAD_/Pedal box so far due to solidworks being a mess/Base Pedal Interface.SLDPRT
CAD_/Pedal box so far due to solidworks being a mess/Brake pedal assembly.SLDPRT
CAD_/Pedal box so far due to solidworks being a mess/Brake pedal with support and bolts.SLDPRT
CAD_/Pedal box so far due to solidworks being a mess/Pedal support.SLDPRT
CAD_/Pedal box so far due to solidworks being a mess/brake pedal.SLDPRT
CAD_/Pedal box so far due to solidworks being a mess/drive-download-20170208T124512Z/throttle pedal.SLDPRT
CAD_/Pedal box so far due to solidworks being a mess/link2.SLDPRT
Chassis designs/Callum's Chassis Designs/Chassis Design Revision 7 (Update 4).SLDPRT
Chassis designs/Callum's Chassis Designs/FINAL Design.SLDPRT
Chassis designs/Callum's Chassis Designs/Revision 1.SLDPRT
Chassis designs/Callum's Chassis Designs/Revision 2.SLDPRT
Chassis designs/Callum's Chassis Designs/Revision 3 (Update 2).SLDPRT
FS-17-0009-H Project Break Down Impact Attenuator/Development Assembly for FS-17-0009-H.SLDDRW
FS-17-0009-H Project Break Down Impact Attenuator/FS-17-000-MS-00001-AA.SLDDRW
FS-17-0009-H Project Break Down Impact Attenuator/FS-17-000-MS-00004-AA.SLDDRW
FS-17-0009-H Project Break Down Impact Attenuator/FS-17-000-MS-A0001-AA.SLDDRW
Powertrain/Driveshaft/FS18-PT-CF10-02 GKN Outer Joint_/10274392 AC Outer Race_1.sldprt
Steering System/Steering mechansim parts and drawings/Bushing attachment.SLDDRW
Steering System/Steering mechansim parts and drawings/Rack attachment - 2.SLDDRW
Steering System/Steering mechansim parts and drawings/Rack attachment.SLDDRW
Steering System/formula sae- steering mechanism/59507664-7-23406-116068/23406-116068.SLDASM
Steering System/formula sae- steering mechanism/59507664-7-23406-116068/23406-116068_01.SLDPRT
Steering System/formula sae- steering mechanism/59507664-7-23406-116068/23406-116068_02.SLDPRT
Steering System/formula sae- steering mechanism/59507664-7-23406-116068/23406-116068_03.SLDPRT
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
