salfordracing/SR-FS-17/Assembly/FInal Assembly (Don't Touch)/rendered FSAE.JPG

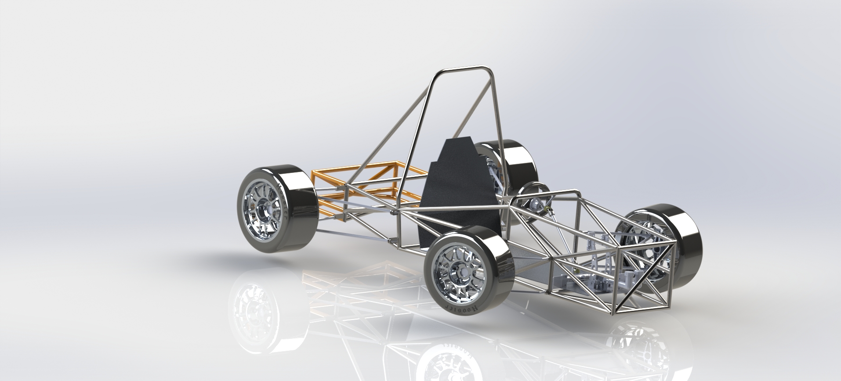
Assembly/FInal Assembly (Don't Touch)/rendered FSAE.JPG
