salfordracing/SR-FS-17/FS-17-0009-H Project Break Down Impact Attenuator/FS-17-0006 project items/impact attenuator renders/Development Assembly for FS-17-0009-H (2).JPG

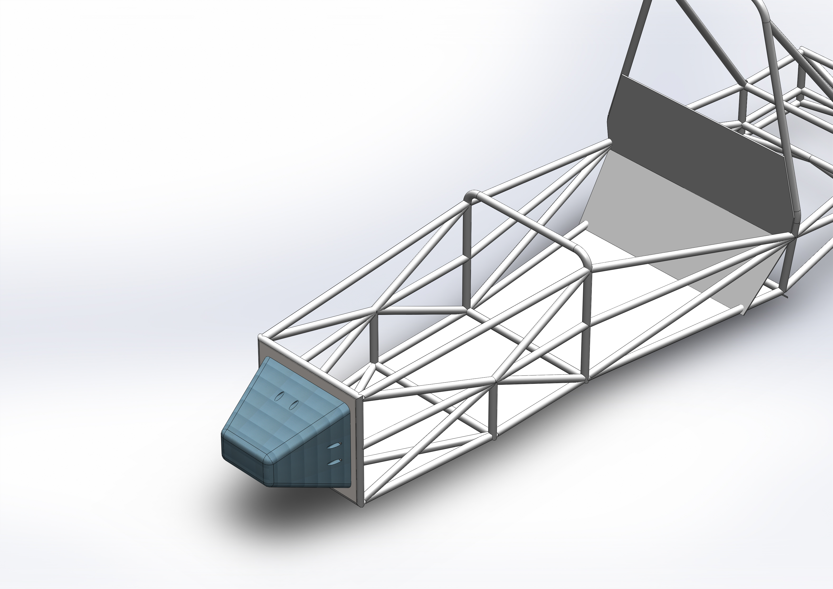
FS-17-0009-H Project Break Down Impact Attenuator/FS-17-0006 project items/impact attenuator renders/Development Assembly for FS-17-0009-H (2).JPG
