salfordracing/SR-FS-17/FS-17-0012-H Braking system Design and integration/Research items/wheel hub final assembly.JPG

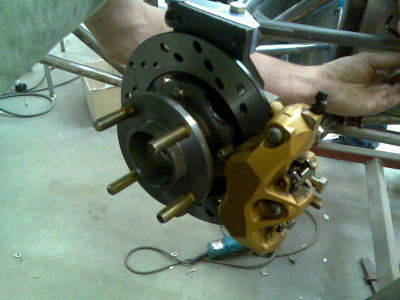
FS-17-0012-H Braking system Design and integration/Research items/wheel hub final assembly.JPG
