salfordracing/SR-FS-17/FS-17-0009-H Project Break Down Impact Attenuator/FS-17-0006 project items/FS-17-000-MS-A0001-AA.PDF

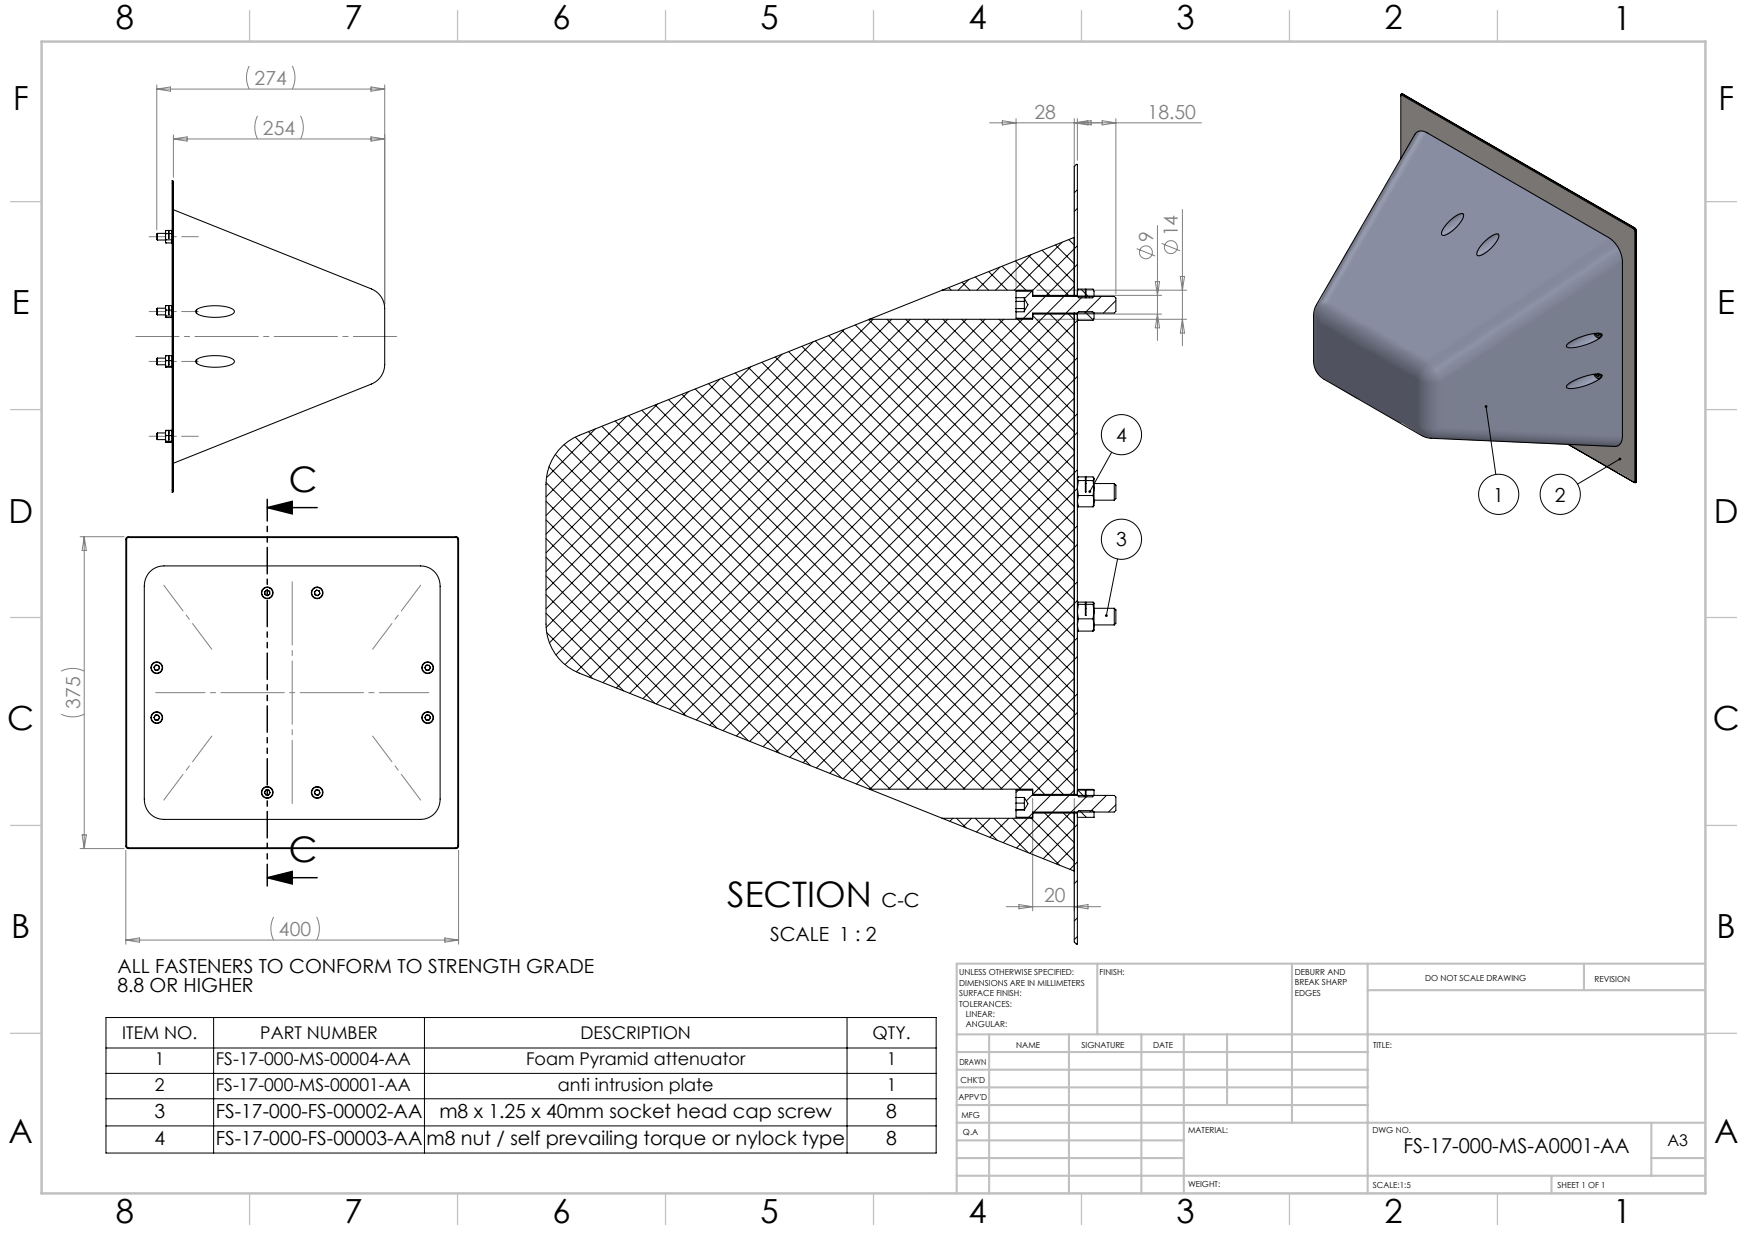
[picture p238: page 1]
SECTION C-C; SCALE 1 : 2; FS-17-000-FS-00003-AA m8 nut / self prevailing torque or nylock type; FINISH:; DEBURR AND; BREAK SHARP; DO NOT SCALE DRAWING; REVISION; SCALE:1:5; SHEET 1 OF 1

ALL FASTENERS TO CONFORM TO STRENGTH GRADE
8.8 OR HIGHER

UNLESS OTHERWISE SPECIFIED:
DIMENSIONS ARE IN MILLIMETERS
SURFACE FINISH:
TOLERANCES:
LINEAR:
ANGULAR:

ITEM NO. | PART NUMBER | DESCRIPTION | QTY.
1 | FS-17-000-MS-00004-AA | Foam Pyramid attenuator | 1
2 | FS-17-000-MS-00001-AA | anti intrusion plate | 1
3 | FS-17-000-FS-00002-AA | m8 x 1.25 x 40mm socket head cap screw | 8

NAME | SIGNATURE | DATE | | | | TITLE:

DRAWN
CHK'D
APPV'D
MFG
Q.A | | | | MATERIAL: | DWG NO. FS-17-000-MS-A0001-AA | A3
