salfordracing/SR-FS-17/(commit log)

2017-11-24 Initial Commit
    Initial commit of 2017 Engineering Directory
    [1. Mounting.SLDPRT, 10274392 AC Outer Race_1.sldprt, 2016 Chassis Design (Old team).SLDPRT, 23406-116068.SLDASM, 23406-116068_01.SLDPRT, 23406-116068_02.SLDPRT, 23406-116068_03.SLDPRT, 27.2.2017-RS.xlsx]
2017-11-24 removing
    removing excess files
    [27.2.2017-RS.xlsx, FS17-MT-PO06-01 Metals4U Order.xlsx, FS17-PT-PO07-01 Quaife PO.xlsx, FS17-ST-PO05-01 Kaz Technologies PO.xlsx, FS17-WT-PO04-01 Demon Tweeks PO.xlsx, Part Comapre.xlsx, Shopping list.xlsx]
